jiaruiyang123/SD-OCT/README.md

# SD-OCT

This is for Thorlabs spectral domain OCT acquisition.

Jiarui Yang
05/22/19
