jiaruiyang123/SD-OCT/Vibratome/Rev 1.2/Vibratome Motor Assembly_RevC.SLDASM

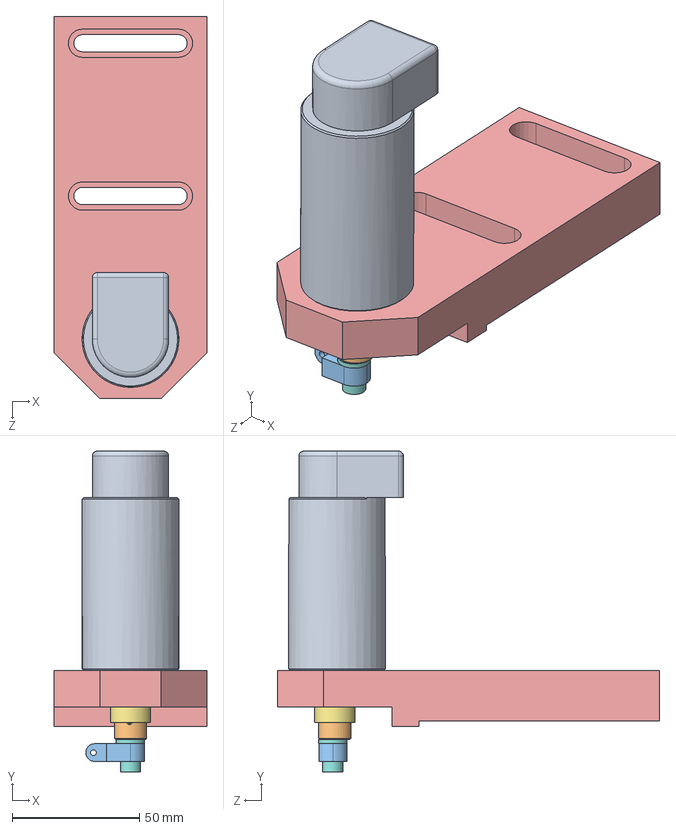
[picture p1: CAD file, 2019-05-22]
Vibratome/Rev 1.2/Vibratome Motor Assembly_RevC.SLDASM
60.0 x 126.0 x 150.0 mm
[Faulhaber] Series3863MotorwithEncoder
MotorEshaft
Motor Coupler Rev C
92695A105_HIGH HOLD CONE POINT SET SCREW x 4
Motor Holder Redesign
91290A113_BLACK-OXIDE CLASS 12.9 SOCKET HEAD CAP SCREW x 6
2706T280_ULTRA-LOW-FRICTION DRY-RUNNING SLEEVE BEARING
2706T120_ULTRA-LOW-FRICTION DRY-RUNNING SLEEVE BEARING
