jiaruiyang123/SD-OCT/Vibratome/Rev 1.2/BladeHolderBottom.STEP

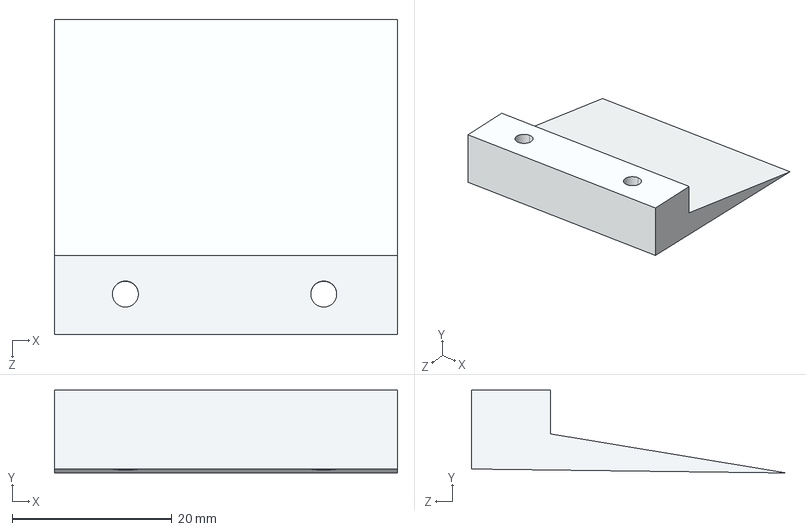
[picture p3: CAD file, 2019-05-22]
Vibratome/Rev 1.2/BladeHolderBottom.STEP
43.0 x 10.4 x 39.5 mm
