jiaruiyang123/SD-OCT/Vibratome/Rev 1.2/MotorEshaft.SLDPRT

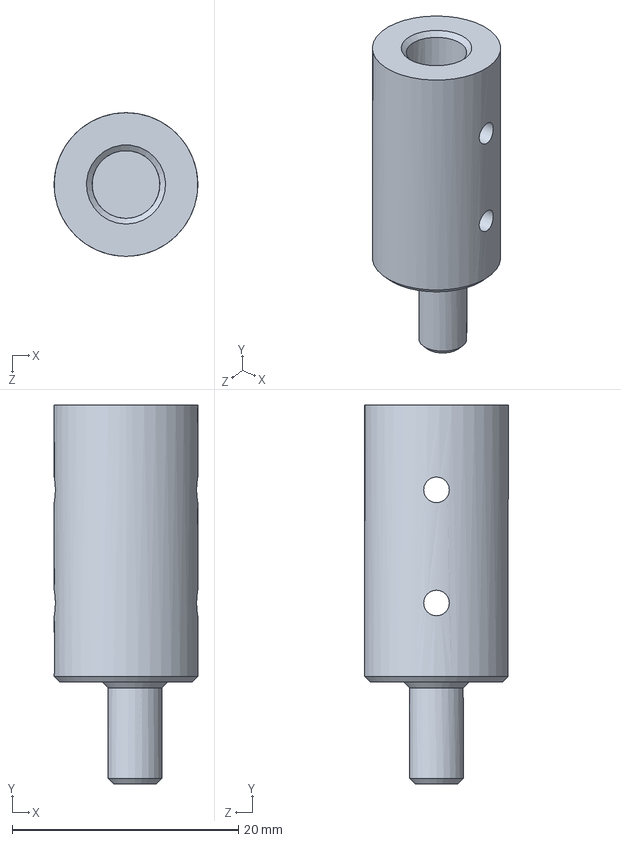
[picture p5: CAD file, 2019-05-22]
Vibratome/Rev 1.2/MotorEshaft.SLDPRT
12.7 x 33.5 x 12.7 mm
