jiaruiyang123/SD-OCT/Vibratome/Rev 1.2/BladeHolderTop.STEP

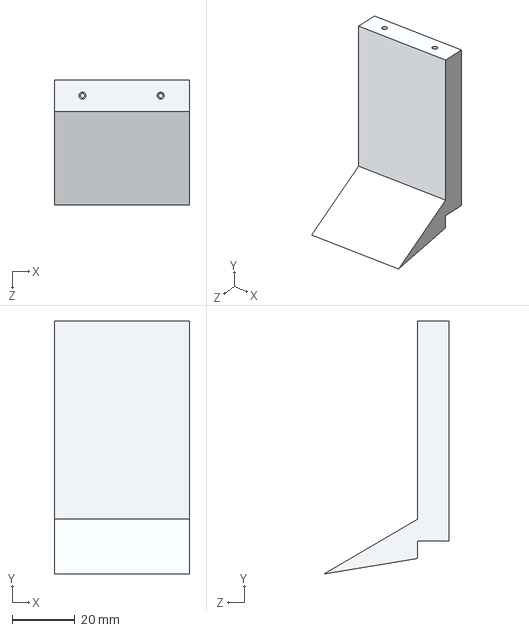
[picture p6: CAD file, 2019-05-22]
Vibratome/Rev 1.2/BladeHolderTop.STEP
43.0 x 80.4 x 39.8 mm
