jiaruiyang123/SD-OCT/Vibratome/Rev 1.2/Motor Coupler Rev C.SLDPRT

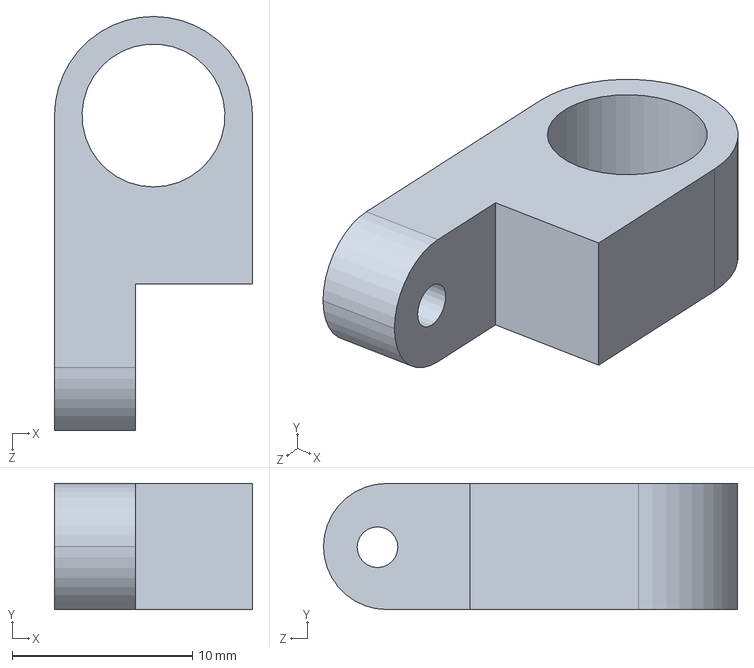
[picture p7: CAD file, 2019-05-22]
Vibratome/Rev 1.2/Motor Coupler Rev C.SLDPRT
11.0 x 7.00 x 23.0 mm
