jiaruiyang123/SD-OCT/Vibratome/Rev 1.2/[Faulhaber] Series3863MotorwithEncoder.SLDPRT

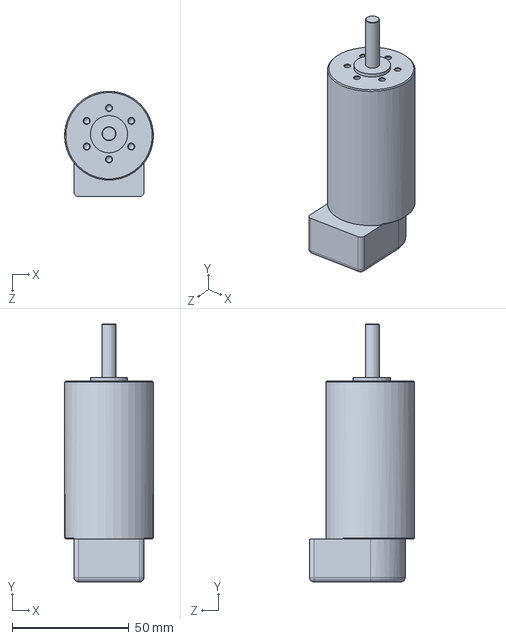
[picture p8: CAD file, 2019-05-22]
Vibratome/Rev 1.2/[Faulhaber] Series3863MotorwithEncoder.SLDPRT
38.0 x 110.4 x 45.1 mm
