jiaruiyang123/SD-OCT/Vibratome/Rev 1.2/Vibratome_Measured.SLDPRT

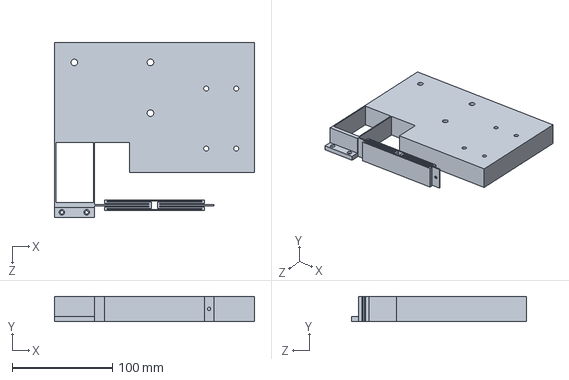
[picture p9: CAD file, 2019-05-22]
Vibratome/Rev 1.2/Vibratome_Measured.SLDPRT
200.0 x 25.0 x 174.8 mm
