jiaruiyang123/SD-OCT/Vibratome/Rev 1.2/93705A119_THREAD-LOCKING 18-8 SS SOCKET HEAD CAP SCREW.SLDPRT

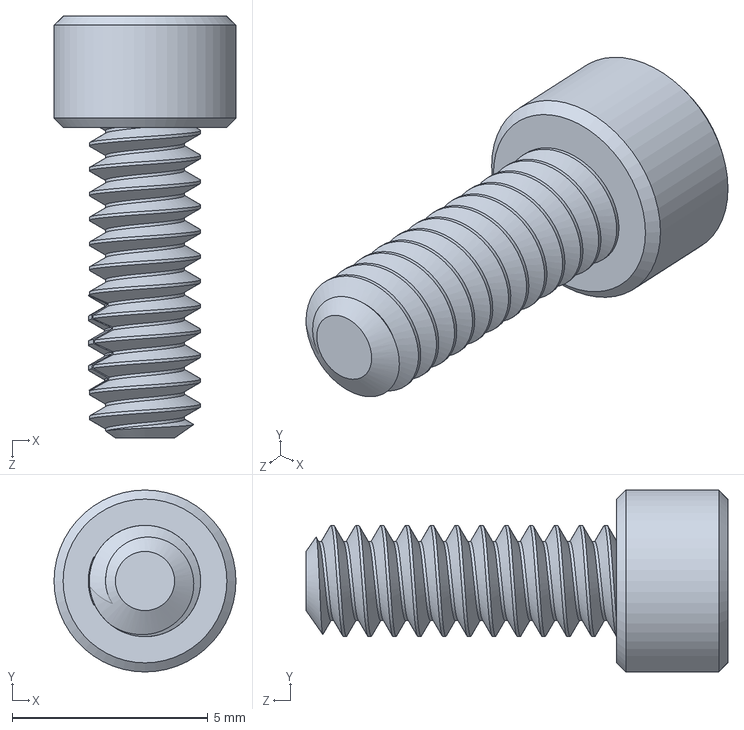
[picture p10: CAD file, 2019-05-22]
Vibratome/Rev 1.2/93705A119_THREAD-LOCKING 18-8 SS SOCKET HEAD CAP SCREW.SLDPRT
4.65 x 4.65 x 10.8 mm
