jiaruiyang123/SD-OCT/Vibratome/Rev 1.2/2706T280_ULTRA-LOW-FRICTION DRY-RUNNING SLEEVE BEARING.SLDPRT

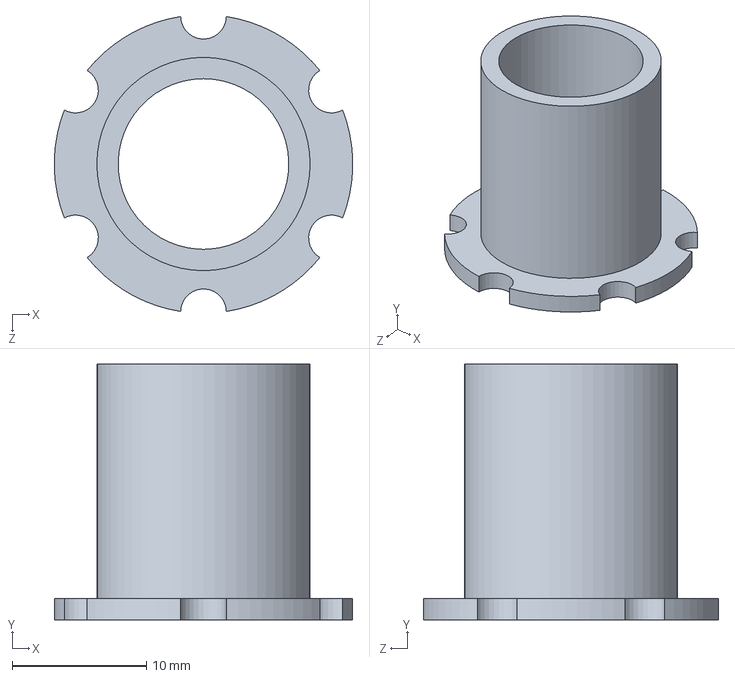
[picture p11: CAD file, 2019-05-22]
Vibratome/Rev 1.2/2706T280_ULTRA-LOW-FRICTION DRY-RUNNING SLEEVE BEARING.SLDPRT
22.2 x 19.1 x 22.0 mm
