jiaruiyang123/SD-OCT/Vibratome/Rev 1.2/93705A118_THREAD-LOCKING 18-8 SS SOCKET HEAD CAP SCREW.SLDPRT

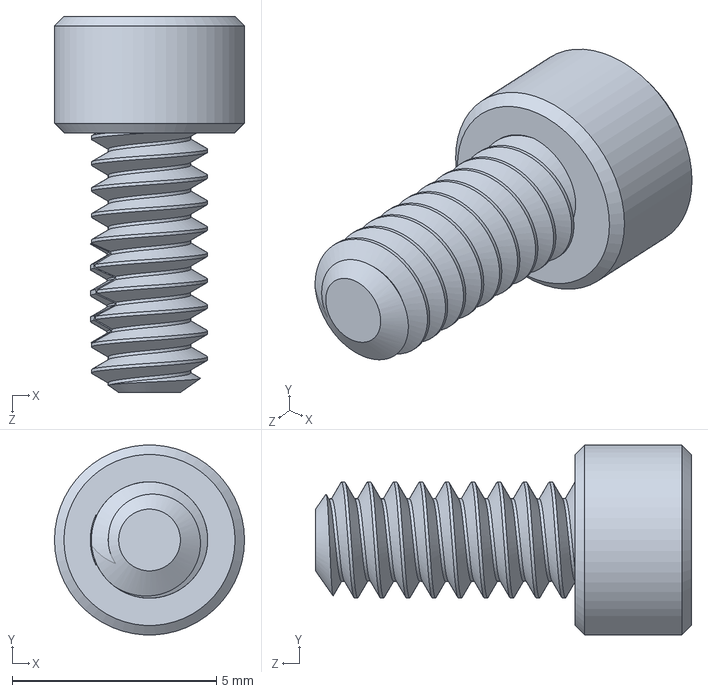
[picture p13: CAD file, 2019-05-22]
Vibratome/Rev 1.2/93705A118_THREAD-LOCKING 18-8 SS SOCKET HEAD CAP SCREW.SLDPRT
4.65 x 4.64 x 9.19 mm
