jiaruiyang123/SD-OCT/Vibratome/Rev 1.2/91251A540_BLACK-OXIDE ALLOY STEEL SOCKET HEAD CAP SCREW.SLDPRT

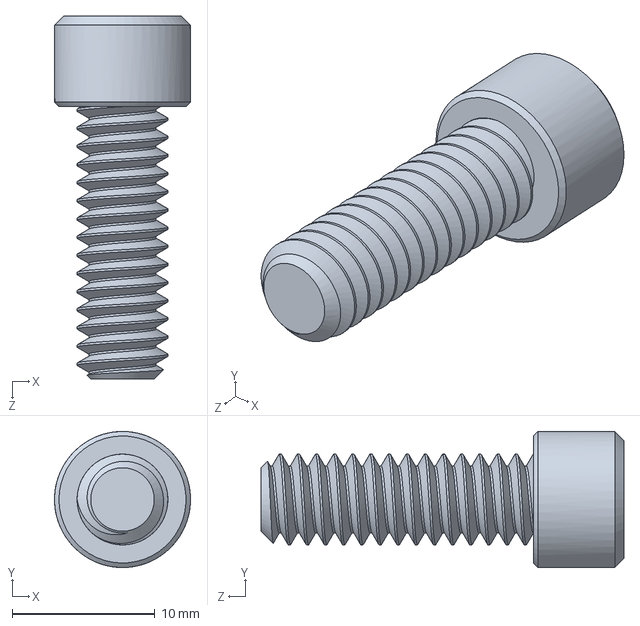
[picture p14: CAD file, 2019-05-22]
Vibratome/Rev 1.2/91251A540_BLACK-OXIDE ALLOY STEEL SOCKET HEAD CAP SCREW.SLDPRT
9.53 x 9.52 x 25.4 mm
