jiaruiyang123/SD-OCT/Vibratome/Rev 1.2/2706T120_ULTRA-LOW-FRICTION DRY-RUNNING SLEEVE BEARING.SLDPRT

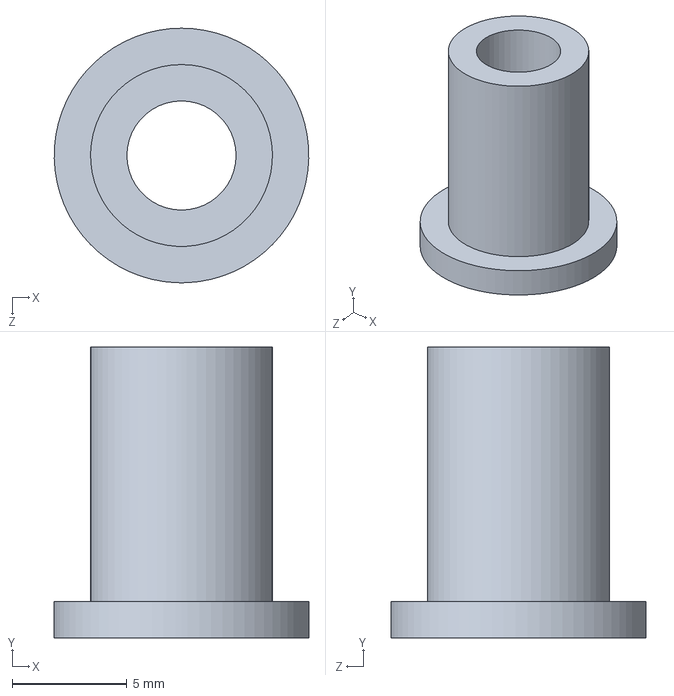
[picture p15: CAD file, 2019-05-22]
Vibratome/Rev 1.2/2706T120_ULTRA-LOW-FRICTION DRY-RUNNING SLEEVE BEARING.SLDPRT
11.1 x 12.7 x 11.1 mm
