jiaruiyang123/SD-OCT/Vibratome/Rev 1.2/91290A111_BLACK-OXIDE CLASS 12.9 SOCKET HEAD CAP SCREW.SLDPRT

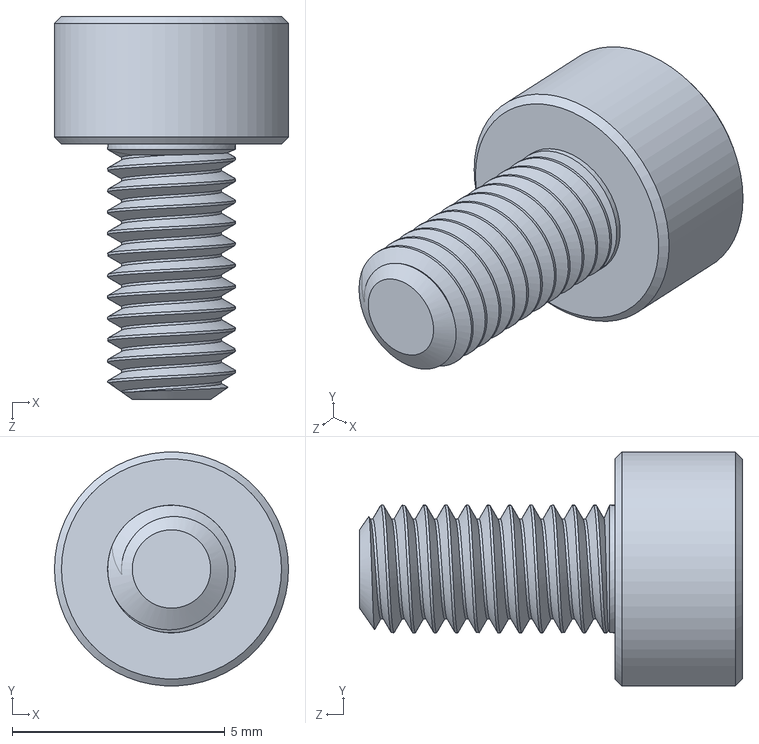
[picture p16: CAD file, 2019-05-22]
Vibratome/Rev 1.2/91290A111_BLACK-OXIDE CLASS 12.9 SOCKET HEAD CAP SCREW.SLDPRT
5.50 x 5.49 x 9.00 mm
