jiaruiyang123/SD-OCT/(list of files, cad)

Other CAD files:
Vibratome/Rev 1.2/Vibratome Assembly with Modified Motor Holder and EShaft_Rev1.2.STEP
Vibratome/Rev 1.2/Motor Holder Rev C.SLDPRT
Vibratome/Rev 1.2/2706T280_ULTRA-LOW-FRICTION DRY-RUNNING SLEEVE BEARING.SLDDRW
Vibratome/Rev 1.2/92695A105_HIGH HOLD CONE POINT SET SCREW.SLDPRT
Vibratome/Rev 1.2/BladeHolderBottom.SLDDRW
Vibratome/Rev 1.2/BladeHolderBottom.SLDPRT
Vibratome/Rev 1.2/BladeHolderTop.SLDDRW
Vibratome/Rev 1.2/BladeHolderTop.SLDPRT
Vibratome/Rev 1.2/ESHAFT.SLDDRW
Vibratome/Rev 1.2/Motor Coupler_RevC.SLDDRW
Vibratome/Rev 1.2/Motor Coupler_RevD.SLDDRW
Vibratome/Rev 1.2/Motor Holder Redesign.SLDDRW
Vibratome/Rev 1.2/Vibratome Assembly Diagram Revision D.SLDDRW
Vibratome/Rev 1.2/Vibratome Motor Holes Modification REV B.SLDDRW
