jiaruiyang123/SD-OCT/Vibratome/Rev 1.2/[VBT-ASM-100] Vibratome Assembly Diagram.pdf

B B

# MOTOR WITH ENCODER

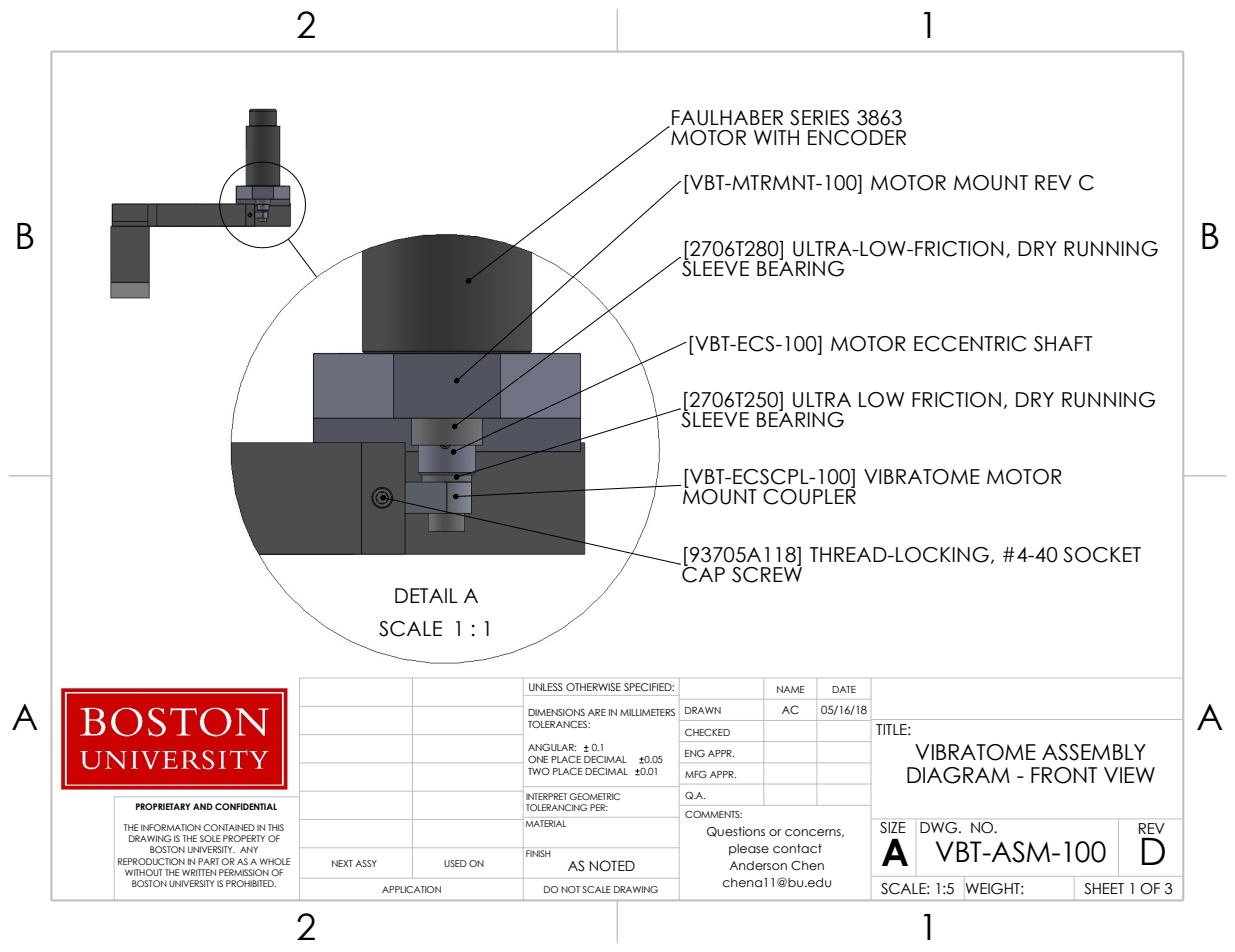
[picture p17: page 1]
DETAIL A SCALE 1 : 1; FAULHABER SERIES 3863

[VBT-MTRMNT-100] MOTOR MOUNT REV C

[2706T280] ULTRA-LOW-FRICTION, DRY RUNNING
SLEEVE BEARING

[VBT-ECS-100] MOTOR ECCENTRIC SHAFT

[2706T250] ULTRA LOW FRICTION, DRY RUNNING

[VBT-ECSCPL-100] VIBRATOME MOTOR
MOUNT COUPLER

[93705A118] THREAD-LOCKING, #4-40 SOCKET
CAP SCREW

UNLESS OTHERWISE SPECIFIED: | | NAME | DATE
DIMENSIONS ARE IN MILLIMETERS TOLERANCES: ANGULAR: 0.1 ONE PLACE DECIMAL 0.05 TWO PLACE DECIMAL 0.01 | DRAWN | AC | 05/16/18

CHECKED | | | TITLE: VIBRATOME ASSEMBLY DIAGRAM - FRONT VIEW

ENG APPR.
MFG APPR.

INTERPRET GEOMETRIC TOLERANCING PER: | Q.A.
MATERIAL | | SIZE A | DWG. NO. VBT-ASM-100 | REV D

PROPRIETARY AND CONFIDENTIAL

COMMENTS:
Questions or concerns,
please contact
Anderson Chen
chena11@bu.edu

THE INFORMATION CONTAINED IN THIS
DRAWING IS THE SOLE PROPERTY OF
BOSTON UNIVERSITY. ANY
REPRODUCTION IN PART OR AS A WHOLE
WITHOUT THE WRITTEN PERMISSION OF
BOSTON UNIVERSITY IS PROHIBITED.

NEXT ASSY | USED ON | FINISH AS NOTED

APPLICATION | DO NOT SCALE DRAWING | | SCALE: 1:5 | WEIGHT: | SHEET 1 OF 3

B B

# CHASSIS

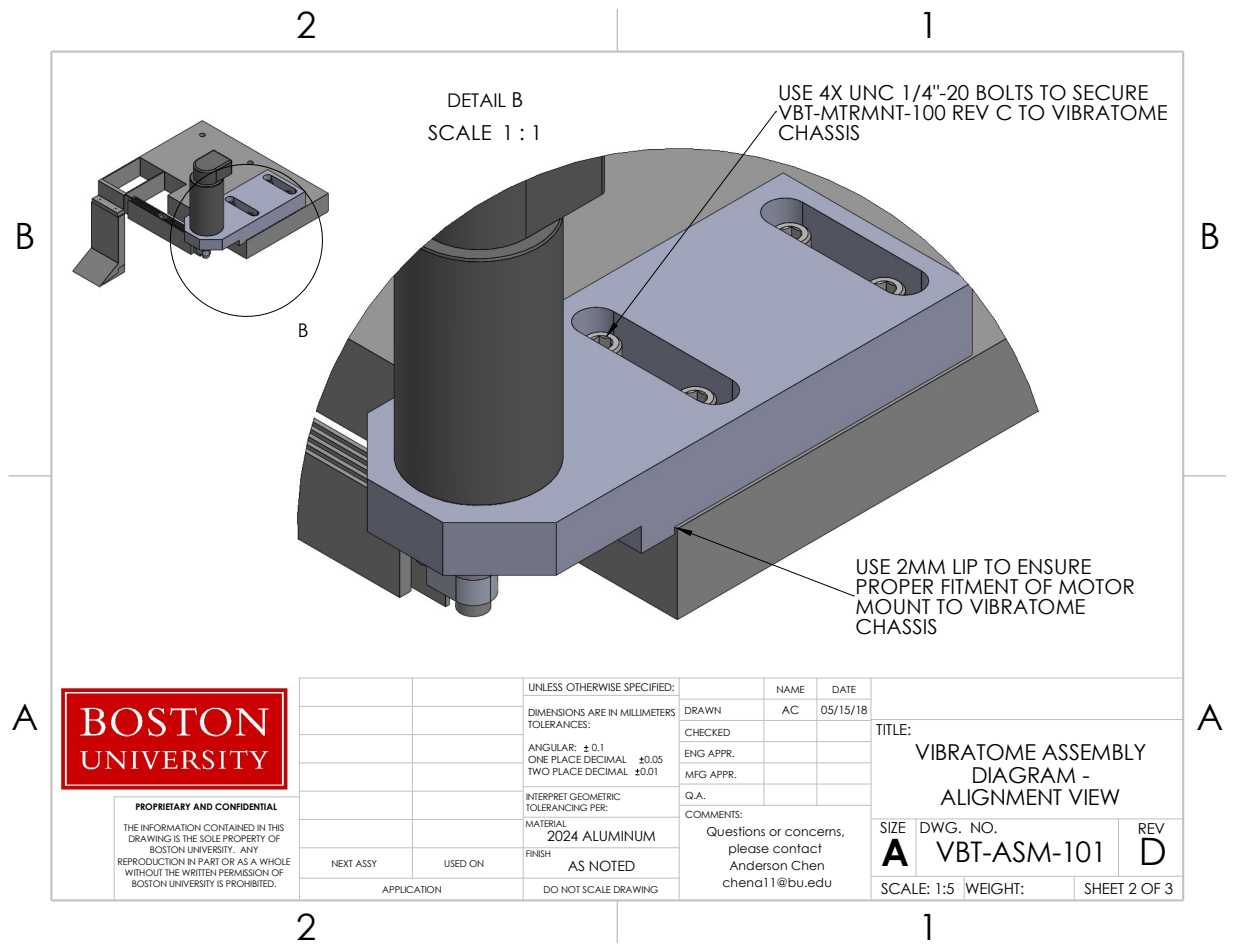
[picture p18: page 2]
SCALE; DETAIL B 1 : 1

USE 4X UNC 1/4"-20 BOLTS TO SECURE
VBT-MTRMNT-100 REV C TO VIBRATOME

USE 2MM LIP TO ENSURE
PROPER FITMENT OF MOTOR
MOUNT TO VIBRATOME
CHASSIS

UNLESS OTHERWISE SPECIFIED: | | NAME | DATE
DIMENSIONS ARE IN MILLIMETERS TOLERANCES: ANGULAR: 0.1 ONE PLACE DECIMAL 0.05 TWO PLACE DECIMAL 0.01 | DRAWN | AC | 05/15/18

CHECKED | | | TITLE: VIBRATOME ASSEMBLY DIAGRAM -ALIGNMENT VIEW

ENG APPR.
MFG APPR.

INTERPRET GEOMETRIC TOLERANCING PER: | Q.A.
MATERIAL 2024 ALUMINUM | | SIZE A | DWG. NO. VBT-ASM-101 | REV D

PROPRIETARY AND CONFIDENTIAL

COMMENTS:
Questions or concerns,
please contact
Anderson Chen

THE INFORMATION CONTAINED IN THIS
DRAWING IS THE SOLE PROPERTY OF
BOSTON UNIVERSITY. ANY
REPRODUCTION IN PART OR AS A WHOLE
WITHOUT THE WRITTEN PERMISSION OF

NEXT ASSY | USED ON | FINISH AS NOTED

DO NOT SCALE DRAWING | | | | SHEET 2 OF 3

C

B B

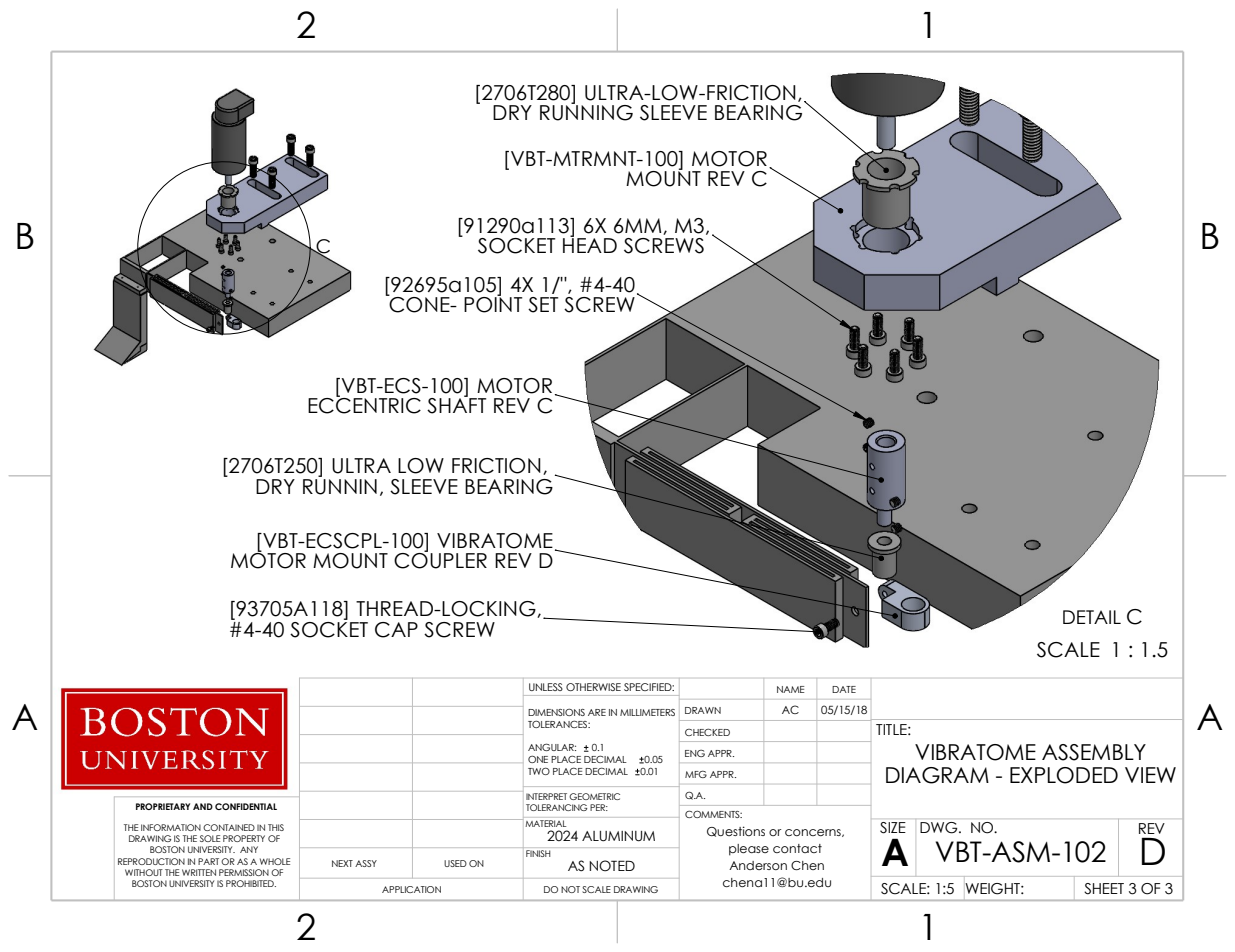
[picture p19: page 3]
SCALE; DETAIL; MOUNT REV C

[2706T280] ULTRA-LOW-FRICTION,
DRY RUNNING SLEEVE BEARING
[VBT-MTRMNT-100] MOTOR

SOCKET HEAD SCREWS

CONE- POINT SET SCREW

[VBT-ECS-100] MOTOR
ECCENTRIC SHAFT REV C

[2706T250] ULTRA LOW FRICTION,
DRY RUNNIN, SLEEVE BEARING

[VBT-ECSCPL-100] VIBRATOME
MOTOR MOUNT COUPLER REV D

[93705A118] THREAD-LOCKING,
#4-40 SOCKET CAP SCREW

UNLESS OTHERWISE SPECIFIED: | | NAME | DATE
DIMENSIONS ARE IN MILLIMETERS TOLERANCES: ANGULAR: 0.1 ONE PLACE DECIMAL 0.05 TWO PLACE DECIMAL 0.01 | DRAWN | AC | 05/15/18

CHECKED | | | TITLE: VIBRATOME ASSEMBLY DIAGRAM - EXPLODED VIEW

ENG APPR.
MFG APPR.

INTERPRET GEOMETRIC TOLERANCING PER: | Q.A.
MATERIAL 2024 ALUMINUM | | SIZE A | DWG. NO. VBT-ASM-102 | REV D

PROPRIETARY AND CONFIDENTIAL

COMMENTS:
Questions or concerns,
please contact
Anderson Chen

THE INFORMATION CONTAINED IN THIS
DRAWING IS THE SOLE PROPERTY OF
BOSTON UNIVERSITY. ANY
REPRODUCTION IN PART OR AS A WHOLE
WITHOUT THE WRITTEN PERMISSION OF

NEXT ASSY | USED ON | FINISH AS NOTED

DO NOT SCALE DRAWING | | | | SHEET 3 OF 3
