jiaruiyang123/SD-OCT/Vibratome/Rev 1.2/[VBT-BLDHLD-100] VIBRATOME BLADE HOLDER - TOP.pdf

# NOTES: 1.) FOR #4-40 TAPS, USING EXISTING HOLES

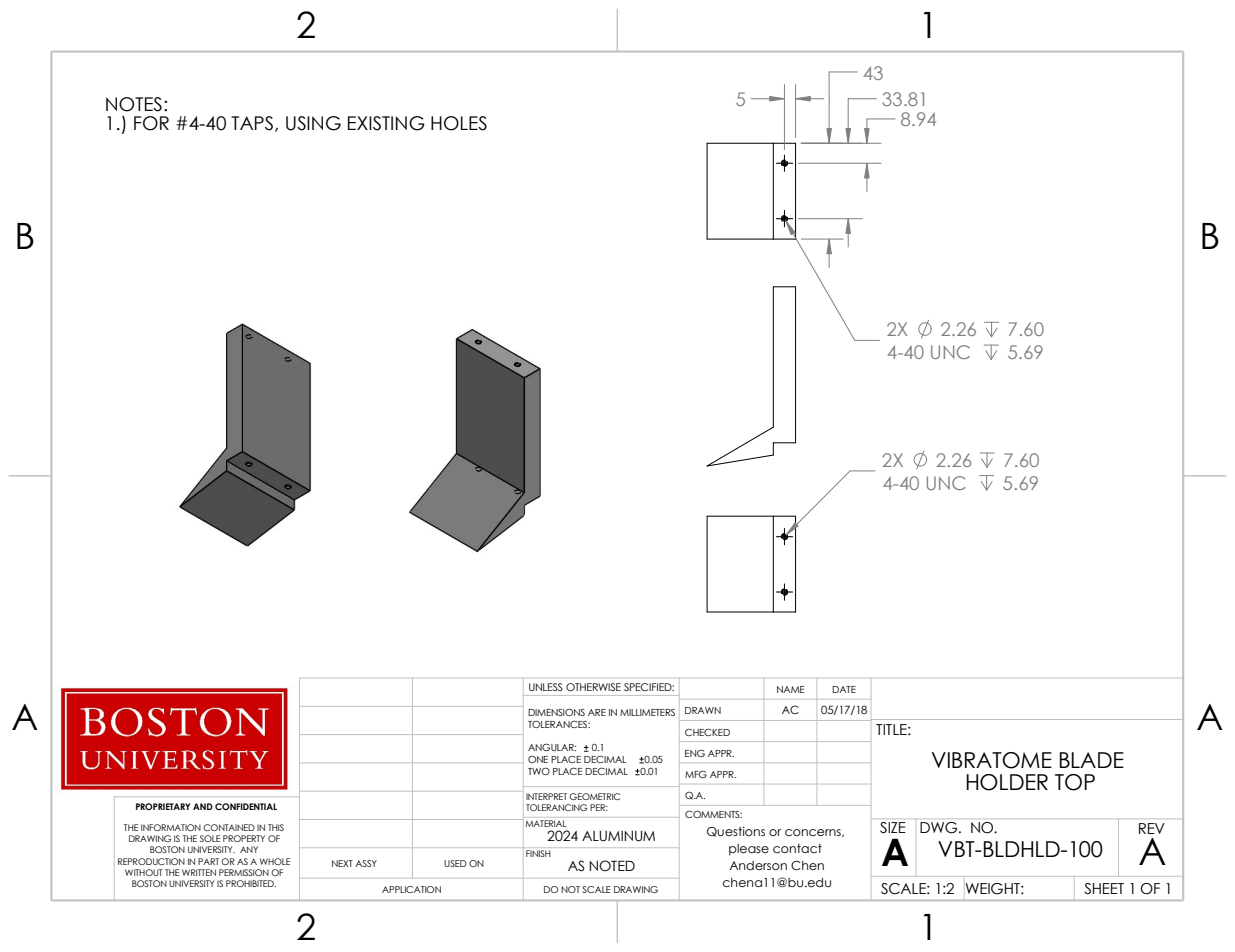
[picture p20: page 1]
REPRODUCTION IN PART OR AS A WHOLE; VBT-BLDHLD-100; DWG. NO.; REV; SIZE; COMMENTS:; 2024 ALUMINUM; MATERIAL; DRAWING IS THE SOLE PROPERTY OF; Questions or concerns,; please contact Anderson Chen chena11@bu.edu; 4-40 UNC

UNLESS OTHERWISE SPECIFIED: | | NAME | DATE
DIMENSIONS ARE IN MILLIMETERS TOLERANCES: ANGULAR: 0.1 ONE PLACE DECIMAL 0.05 TWO PLACE DECIMAL 0.01 | DRAWN | AC | 05/17/18

CHECKED | | | TITLE: VIBRATOME BLADE HOLDER TOP

ENG APPR.
MFG APPR.

INTERPRET GEOMETRIC TOLERANCING PER: | Q.A.

PROPRIETARY AND CONFIDENTIAL

THE INFORMATION CONTAINED IN THIS
BOSTON UNIVERSITY. ANY

NEXT ASSY | USED ON | FINISH AS NOTED

WITHOUT THE WRITTEN PERMISSION OF
BOSTON UNIVERSITY IS PROHIBITED.

APPLICATION | DO NOT SCALE DRAWING | | SCALE: 1:2 | WEIGHT: | SHEET 1 OF 1
