jiaruiyang123/SD-OCT/Vibratome/Rev 1.2/[VBT-BLDHLD-B-100] VIBRATOME BLADE HOLDER - BOTTOM.pdf

# NOTES: 1.) CLEARANCE, #4-40, USE EXISTING HOLES

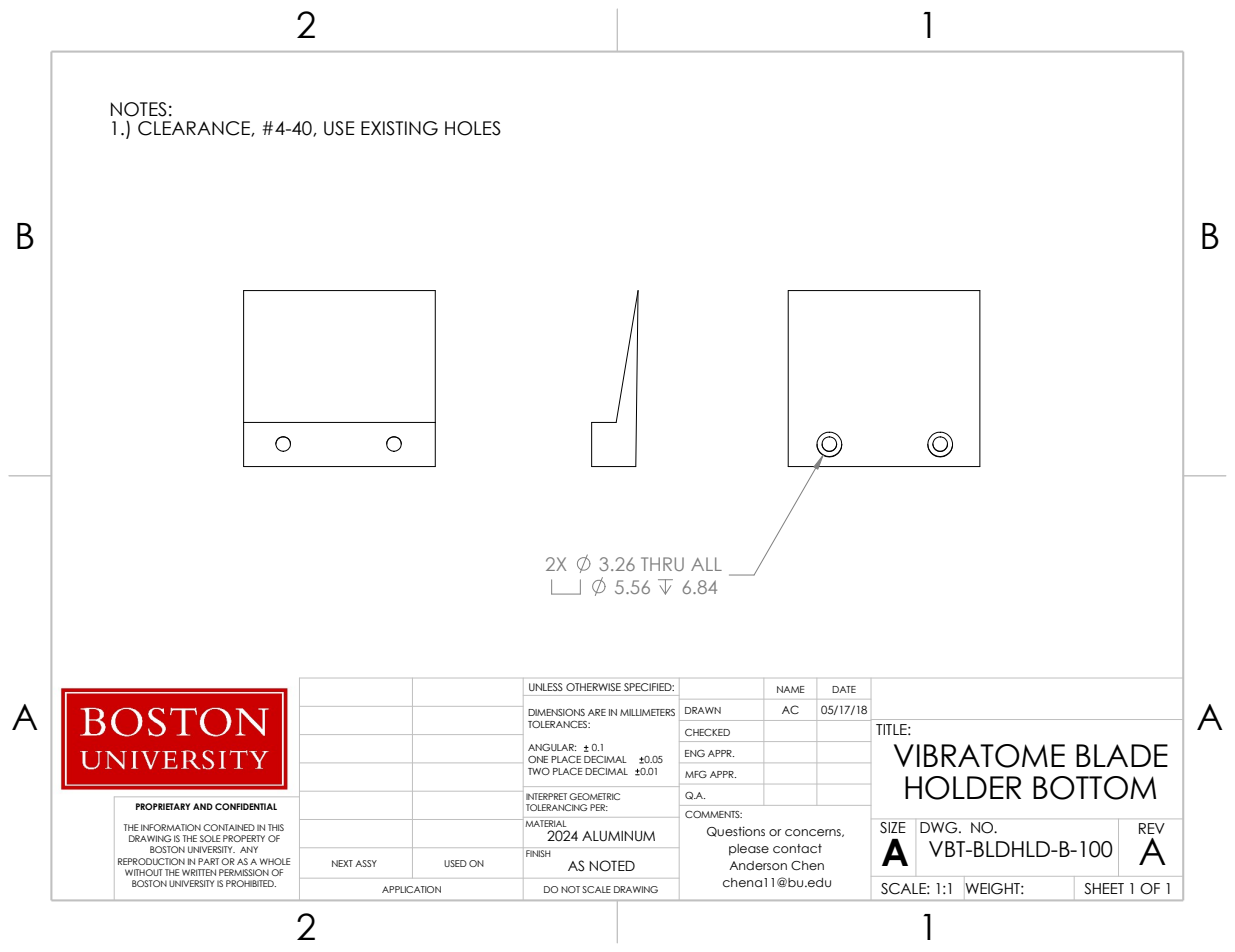
[picture p21: page 1]
2024 ALUMINUM; DWG. NO.; REV; BOSTON UNIVERSITY. ANY; SIZE; COMMENTS:; MATERIAL; VBT-BLDHLD-B-100; DRAWING IS THE SOLE PROPERTY OF; Questions or concerns,; please contact Anderson Chen chena11@bu.edu; 3.26 THRU ALL

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

CHECKED | | | TITLE: VIBRATOME BLADE HOLDER BOTTOM

ENG APPR.
MFG APPR.

INTERPRET GEOMETRIC TOLERANCING PER: | Q.A.

PROPRIETARY AND CONFIDENTIAL

THE INFORMATION CONTAINED IN THIS

REPRODUCTION IN PART OR AS A WHOLE
WITHOUT THE WRITTEN PERMISSION OF
BOSTON UNIVERSITY IS PROHIBITED.

NEXT ASSY | USED ON | FINISH AS NOTED

APPLICATION | DO NOT SCALE DRAWING | | SCALE: 1:1 | WEIGHT: | SHEET 1 OF 1
