jiaruiyang123/SD-OCT/Vibratome/Rev 1.2/[VBT-ECS-100] Eccentric Shaft - REV C.pdf

# 4-40 UNC THRU ALL

# 2.26 THRU ALL

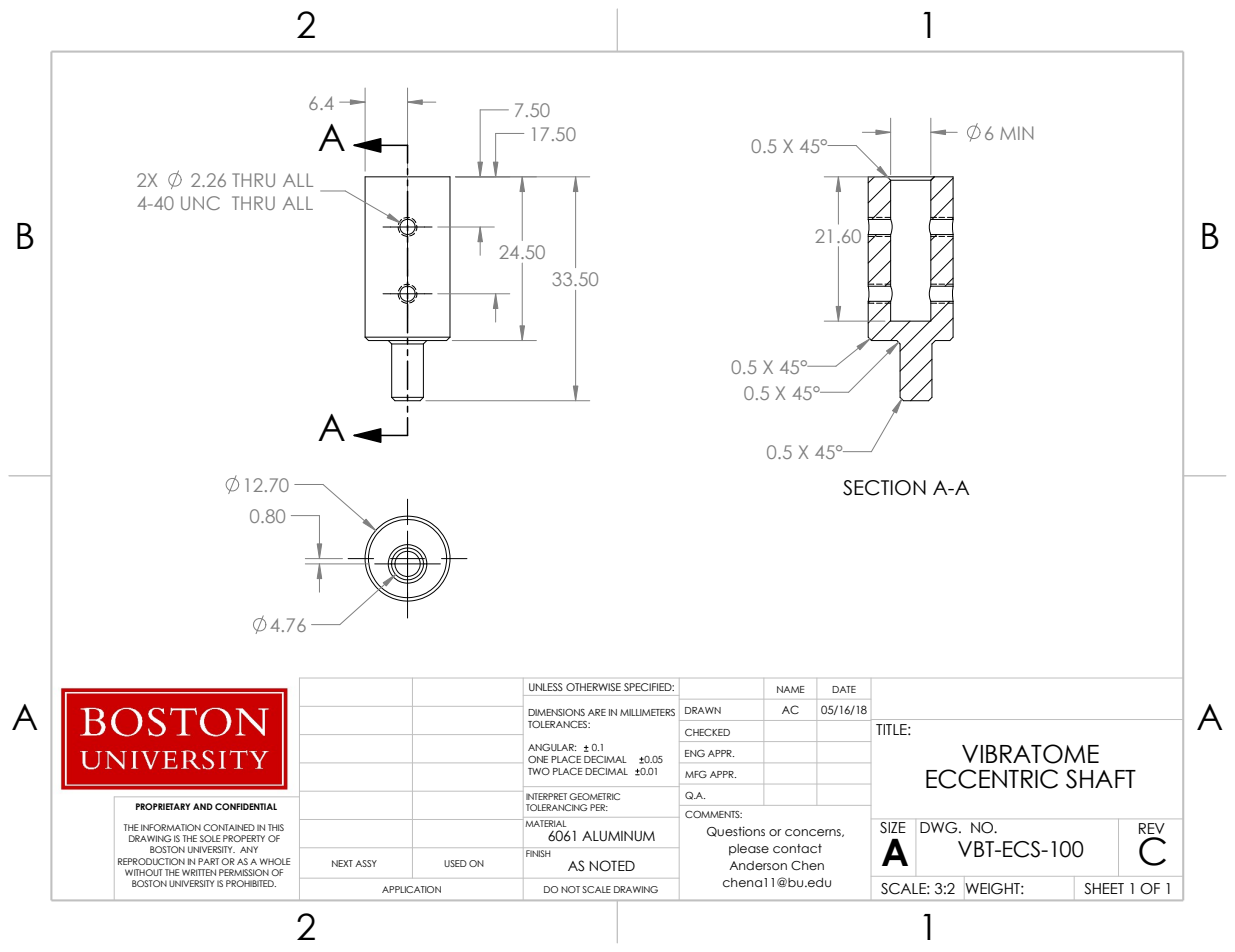
[picture p22: page 1]
SECTION A-A; 6 MIN; COMMENTS:; chena11@bu.edu; DRAWING IS THE SOLE PROPERTY OF; Questions or concerns,; please contact Anderson Chen

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

CHECKED | | | TITLE: VIBRATOME ECCENTRIC SHAFT

ENG APPR.
MFG APPR.

INTERPRET GEOMETRIC TOLERANCING PER: | Q.A.
MATERIAL 6061 ALUMINUM | | SIZE A | DWG. NO. VBT-ECS-100 | REV C

PROPRIETARY AND CONFIDENTIAL

THE INFORMATION CONTAINED IN THIS
BOSTON UNIVERSITY. ANY
REPRODUCTION IN PART OR AS A WHOLE
WITHOUT THE WRITTEN PERMISSION OF
BOSTON UNIVERSITY IS PROHIBITED.

NEXT ASSY | USED ON | FINISH AS NOTED

APPLICATION | DO NOT SCALE DRAWING | | SCALE: 3:2 | WEIGHT: | SHEET 1 OF 1
