jiaruiyang123/SD-OCT/Vibratome/Rev 1.2/[VBT-ECSCPL-100] Vibratome Motor Mount Coupler REV D.pdf

23 7
B

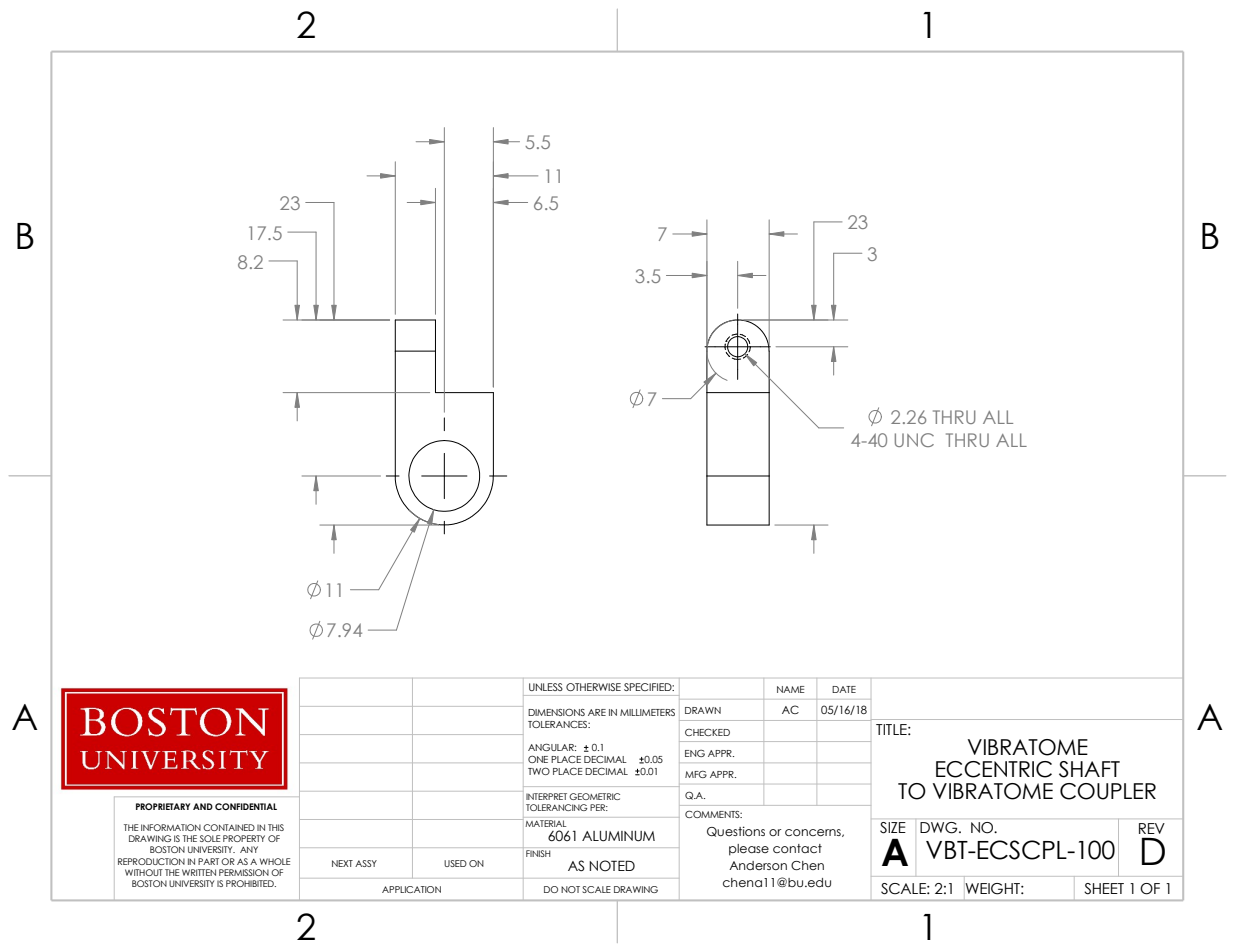
[picture p23: page 1]
BOSTON UNIVERSITY. ANY; REV; SIZE; COMMENTS:; VBT-ECSCPL-100; DRAWING IS THE SOLE PROPERTY OF; Questions or concerns,; please contact Anderson Chen chena11@bu.edu

2.26 THRU ALL
4-40 UNC THRU ALL

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

CHECKED | | | TITLE: VIBRATOME ECCENTRIC SHAFT TO VIBRATOME COUPLER

ENG APPR.
MFG APPR.

INTERPRET GEOMETRIC TOLERANCING PER: | Q.A.

PROPRIETARY AND CONFIDENTIAL

MATERIAL
DWG. NO. 6061 ALUMINUM

THE INFORMATION CONTAINED IN THIS

REPRODUCTION IN PART OR AS A WHOLE
WITHOUT THE WRITTEN PERMISSION OF
BOSTON UNIVERSITY IS PROHIBITED.

NEXT ASSY | USED ON | FINISH AS NOTED
APPLICATION | DO NOT SCALE DRAWING | | SCALE: 2:1 | WEIGHT: | SHEET 1 OF 1
