jiaruiyang123/SD-OCT/Vibratome/Rev 1.2/[VBT-ECSSLV-100] Vibratome Eccentric Shaft Sleeve Modification.pdf

B

1

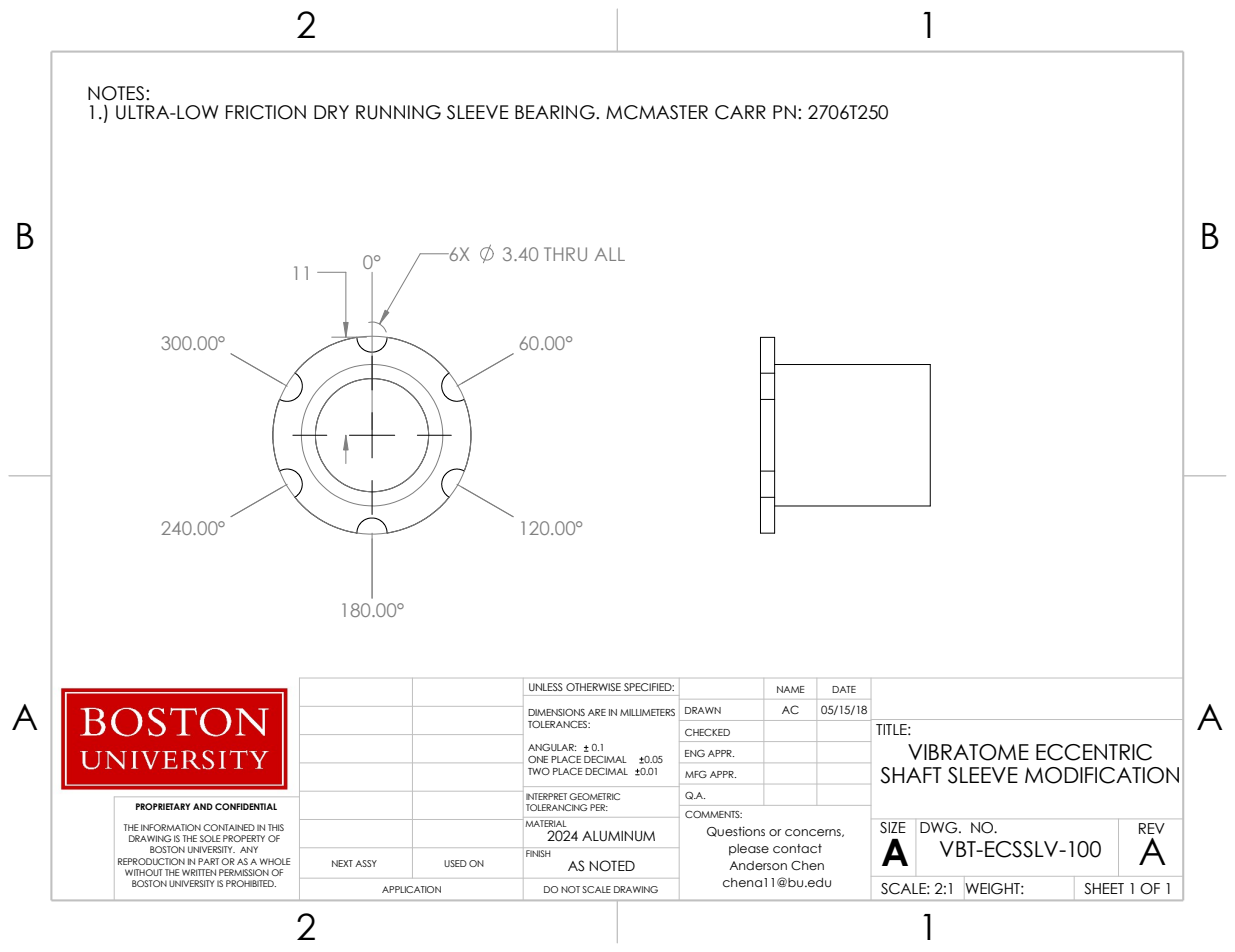
[picture p24: page 1]
COMMENTS:; DRAWING IS THE SOLE PROPERTY OF; Questions or concerns,; please contact Anderson Chen chena11@bu.edu; 3.40 THRU ALL

NOTES:
1.) ULTRA-LOW FRICTION DRY RUNNING SLEEVE BEARING. MCMASTER CARR PN: 2706T250

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

CHECKED | | | TITLE: VIBRATOME ECCENTRIC SHAFT SLEEVE MODIFICATION

ENG APPR.
MFG APPR.

INTERPRET GEOMETRIC TOLERANCING PER: | Q.A.
MATERIAL | | SIZE A | VBT-ECSSLV-100 | REV A

PROPRIETARY AND CONFIDENTIAL

DWG. NO. 2024 ALUMINUM

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
