jiaruiyang123/SD-OCT/Vibratome/Rev 1.2/[VBT-MTRMNT-100] Vibratome Motor Mount-RevC.pdf

60
45

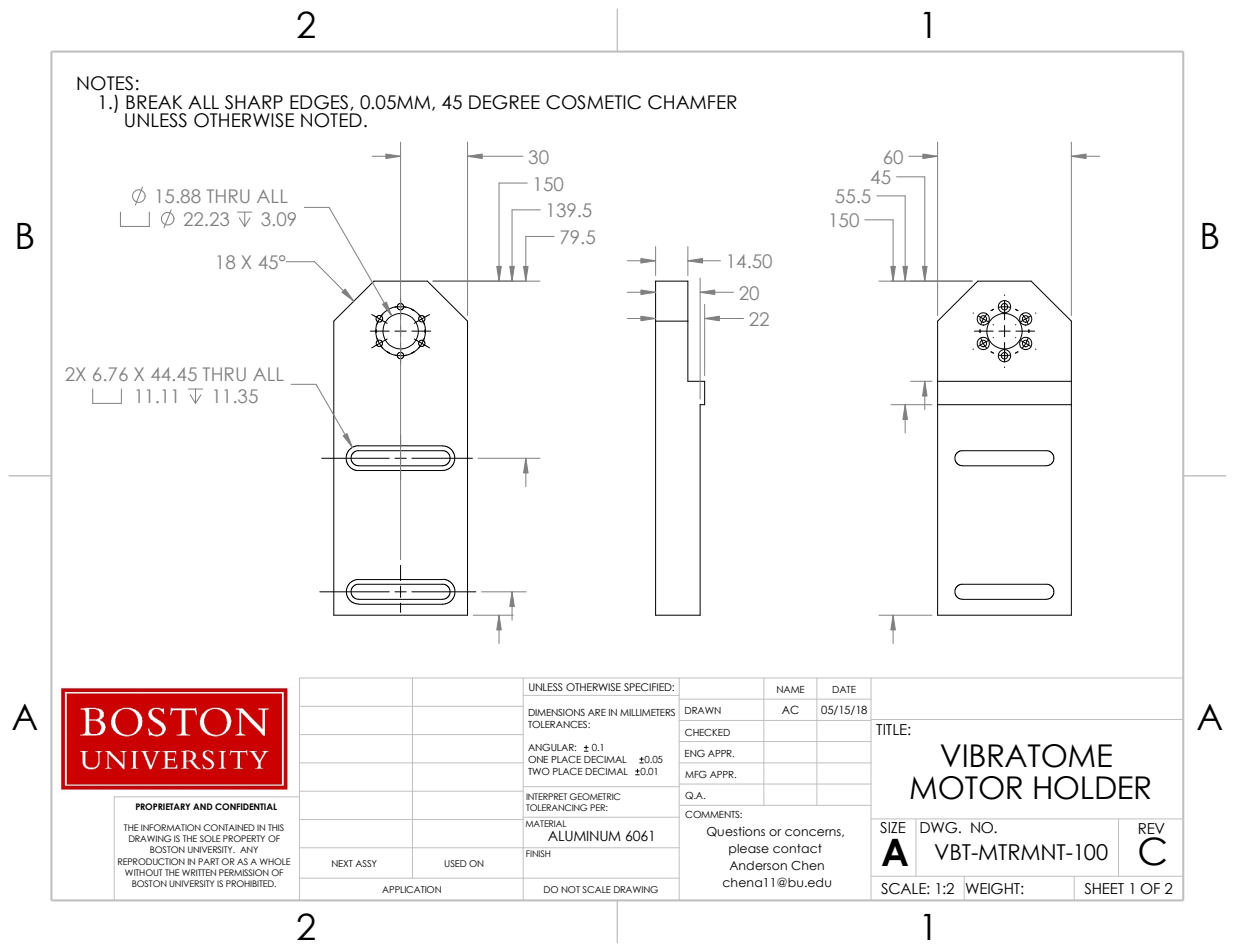
[picture p25: page 1]
2X 6.76 X 44.45 THRU ALL 11.11 11.35; 150 15.88 THRU ALL

NOTES:
1.) BREAK ALL SHARP EDGES, 0.05MM, 45 DEGREE COSMETIC CHAMFER
UNLESS OTHERWISE NOTED.

UNLESS OTHERWISE SPECIFIED: | | NAME | DATE
DIMENSIONS ARE IN MILLIMETERS TOLERANCES: ANGULAR: 0.1 ONE PLACE DECIMAL 0.05 TWO PLACE DECIMAL 0.01 | DRAWN | AC | 05/15/18

CHECKED | | | TITLE: VIBRATOME MOTOR HOLDER

ENG APPR.
MFG APPR.

INTERPRET GEOMETRIC TOLERANCING PER: | Q.A.
MATERIAL ALUMINUM 6061 | | SIZE A | DWG. NO. VBT-MTRMNT-100 | REV C

PROPRIETARY AND CONFIDENTIAL

COMMENTS:
Questions or concerns,
please contact
Anderson Chen
chena11@bu.edu

THE INFORMATION CONTAINED IN THIS
DRAWING IS THE SOLE PROPERTY OF
BOSTON UNIVERSITY. ANY
REPRODUCTION IN PART OR AS A WHOLE
WITHOUT THE WRITTEN PERMISSION OF
BOSTON UNIVERSITY IS PROHIBITED.

NEXT ASSY | USED ON | FINISH

APPLICATION | DO NOT SCALE DRAWING | | SCALE: 1:2 | WEIGHT: | SHEET 1 OF 2

B B

2

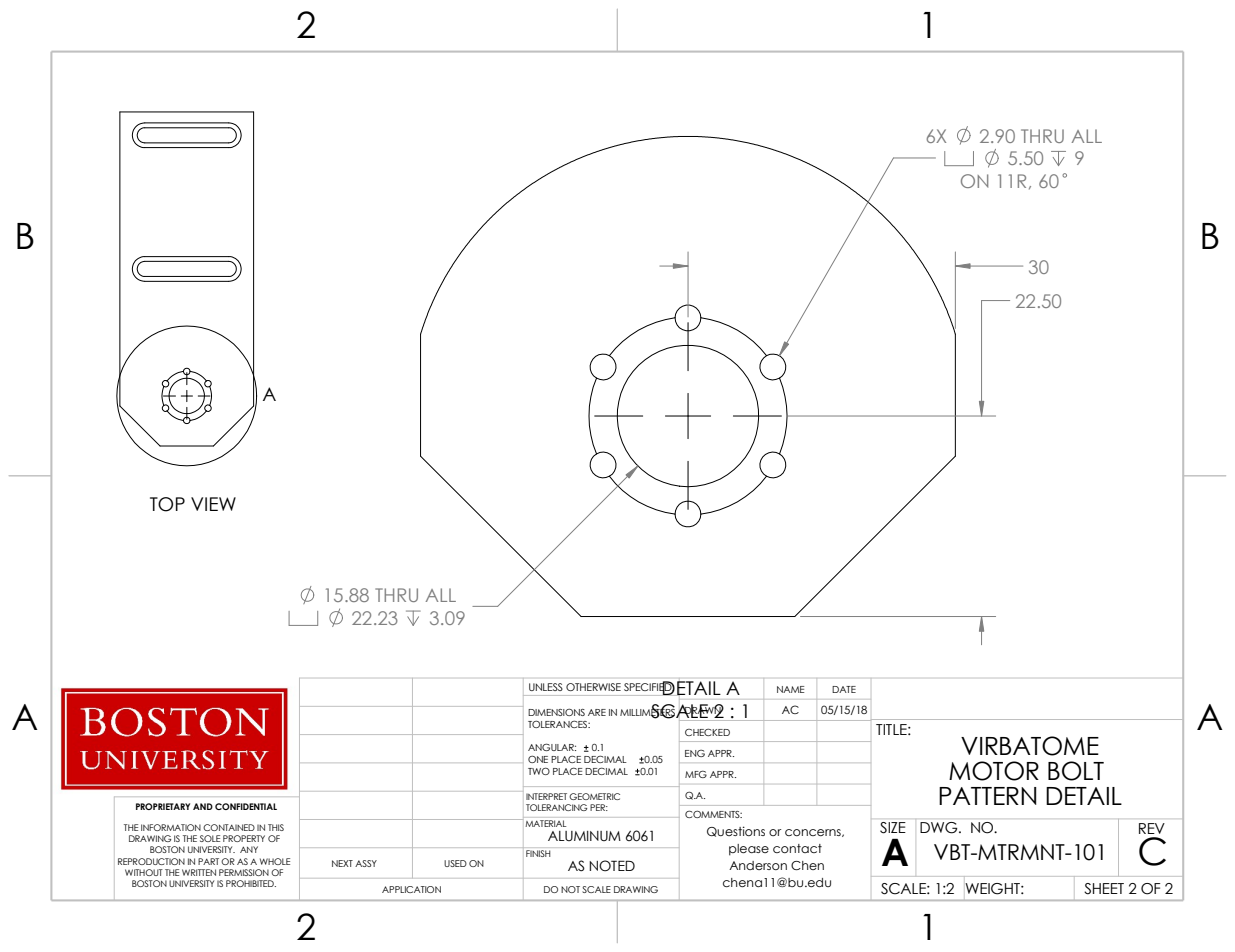
[picture p26: page 2]
TOP VIEW; 2.90 THRU ALL; 15.88 THRU ALL 22.23 3.09

UNLESS OTHERWISE SPECIFIED: DETAIL A | | NAME | DATE
SCALE 2 : 1 DIMENSIONS ARE IN MILLIMETERS TOLERANCES: ANGULAR: 0.1 ONE PLACE DECIMAL 0.05 TWO PLACE DECIMAL 0.01 | DRAWN | AC | 05/15/18

CHECKED | | | TITLE: VIRBATOME MOTOR BOLT PATTERN DETAIL

ENG APPR.
MFG APPR.

INTERPRET GEOMETRIC TOLERANCING PER: | Q.A.
MATERIAL ALUMINUM 6061 | | SIZE A | DWG. NO. VBT-MTRMNT-101 | REV C

PROPRIETARY AND CONFIDENTIAL

COMMENTS:
Questions or concerns,
please contact
Anderson Chen
chena11@bu.edu

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

NEXT ASSY | USED ON | FINISH AS NOTED

APPLICATION | DO NOT SCALE DRAWING | | SCALE: 1:2 | WEIGHT: | SHEET 2 OF 2
