jiaruiyang123/SD-OCT/Vibratome/Rev 1.2/[VBT-MTRMOD-100] Vibratome Motor Mount Modification REV C.pdf

2

B B

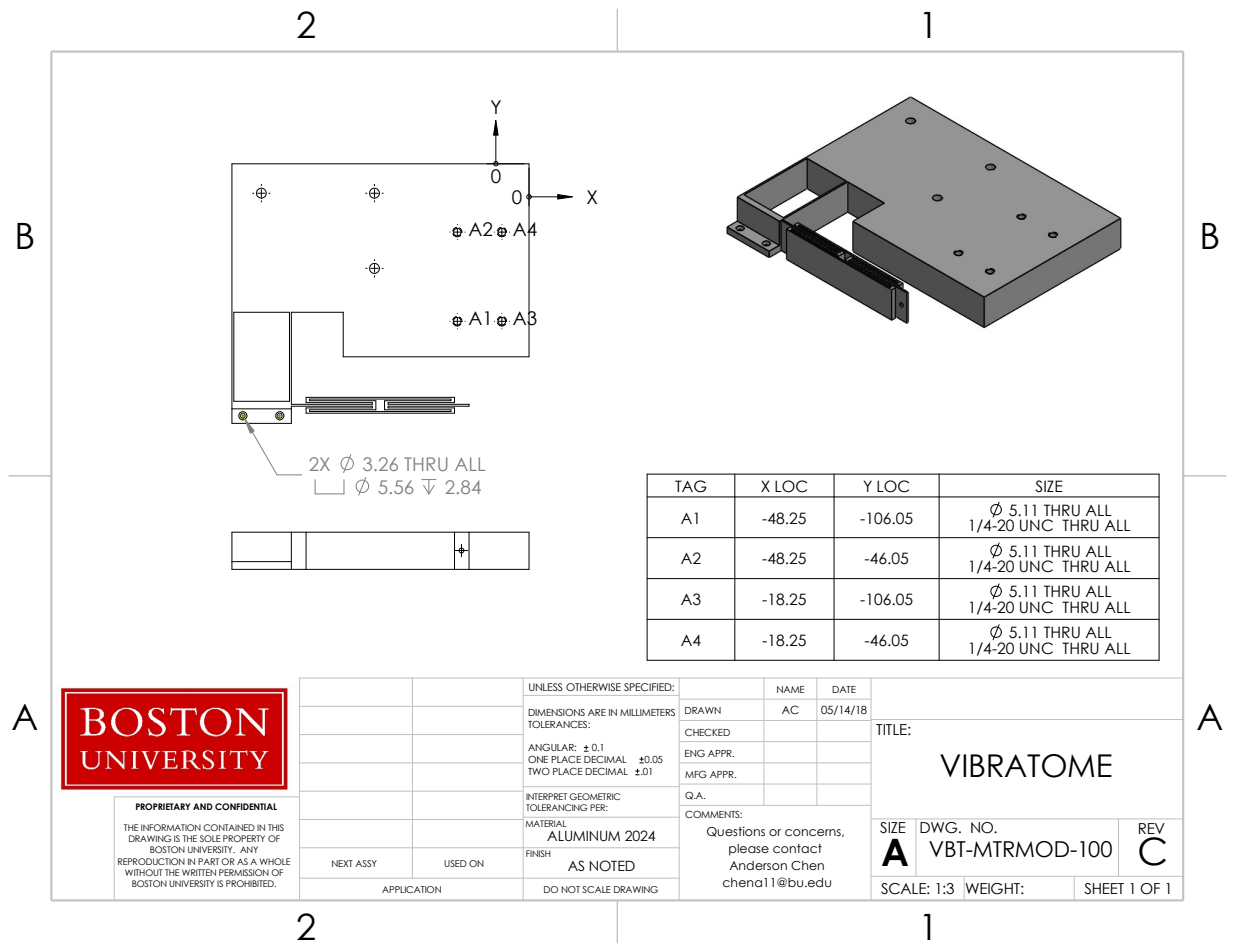
[picture p27: page 1]
COMMENTS:; chena11@bu.edu; DRAWING IS THE SOLE PROPERTY OF; Questions or concerns,; please contact Anderson Chen; 3.26 THRU ALL

TAG | X LOC | Y LOC | SIZE
A1 | -48.25 | -106.05 | 5.11 THRU ALL 1/4-20 UNC THRU ALL

A2 | -48.25 | -46.05 | 5.11 THRU ALL 1/4-20 UNC THRU ALL

A3 | -18.25 | -106.05 | 5.11 THRU ALL 1/4-20 UNC THRU ALL

A4 | -18.25 | -46.05 | 5.11 THRU ALL 1/4-20 UNC THRU ALL

UNLESS OTHERWISE SPECIFIED: | | NAME | DATE
DIMENSIONS ARE IN MILLIMETERS TOLERANCES: ANGULAR: 0.1 ONE PLACE DECIMAL 0.05 TWO PLACE DECIMAL .01 | DRAWN | AC | 05/14/18

CHECKED | | | TITLE: VIBRATOME

ENG APPR.
MFG APPR.

INTERPRET GEOMETRIC TOLERANCING PER: | Q.A.
MATERIAL ALUMINUM 2024 | | SIZE A | DWG. NO. VBT-MTRMOD-100 | REV C

PROPRIETARY AND CONFIDENTIAL

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

NEXT ASSY | USED ON | FINISH AS NOTED
APPLICATION | DO NOT SCALE DRAWING | | SCALE: 1:3 | WEIGHT: | SHEET 1 OF 1
