jiaruiyang123/SD-OCT/(list of files, drawings)

Other design files:
Documents/Notes/Galvo Timing Chart.opj
