jiaruiyang123/SD-OCT/Software/Thorlabs.MotionControl.Benchtop.BrushlessMotor.h

// summary:	Declares the functions class
// The following ifdef block is the standard way of creating macros which make exporting 
// from a DLL simpler. All files within this DLL are compiled with the BRUSHLESSMOTOR_EXPORTS
// symbol defined on the command line. This symbol should not be defined on any project
// that uses this DLL. This way any other project whose source files include this file see 
// BRUSHLESSMOTOR_API functions as being imported from a DLL, whereas this DLL sees symbols
// defined with this macro as being exported.

#pragma once

#ifdef BRUSHLESSMOTORDLL_EXPORTS
/// <summary> Gets the brushlessmotor API. </summary>
#define BRUSHLESSMOTOR_API __declspec(dllexport)
#else
#define BRUSHLESSMOTOR_API __declspec(dllimport)
#endif

#include <OaIdl.h>

extern "C"
{
/** @defgroup Common Common Enums, structs and Functions
 *  This section details the Structures and Functions common to all devices
 *  @{
 */

	/// <summary> Values that represent FT_Status. </summary>
	typedef enum FT_Status : short
	{
		FT_OK = 0x00, ///<OK - no error.
		FT_InvalidHandle = 0x01, ///<Invalid handle.
		FT_DeviceNotFound = 0x02, ///<Device not found.
		FT_DeviceNotOpened = 0x03, ///<Device not opened.
		FT_IOError = 0x04, ///<I/O error.
		FT_InsufficientResources = 0x05, ///<Insufficient resources.
		FT_InvalidParameter = 0x06, ///<Invalid parameter.
		FT_DeviceNotPresent = 0x07, ///<Device not present.
		FT_IncorrectDevice = 0x08 ///<Incorrect device.
	 } FT_Status;

	/// <summary> Values that represent different Motor Types. </summary>
	typedef enum MOT_MotorTypes
	{
		MOT_NotMotor = 0, ///<Not a motor
		MOT_DCMotor = 1, ///< Motor is a DC Servo motor
		MOT_StepperMotor = 2, ///< Motor is a Stepper Motor
		MOT_BrushlessMotor = 3, ///< Motor is a Brushless Motor
		MOT_CustomMotor = 100, ///< Motor is a custom motor
	} MOT_MotorTypes;

	/// <summary> Values that represent Travel Modes. </summary>
	typedef enum MOT_TravelModes : int
	{
		MOT_TravelModeUndefined,///<Undefined
		MOT_Linear = 0x01,///<Linear travel, default units are millimeters
		MOT_Rotational = 0x02,///<Rotational travel, default units are degrees
	} MOT_TravelModes;

	/// <summary> Values that represent Travel Modes. </summary>
	typedef enum MOT_TravelDirection : short
	{
		MOT_TravelDirectionDisabled = 0x00,///<Disabled or Undefined
		MOT_Forwards = 0x01,///<Move in a Forward direction
		MOT_Reverse = 0x02,///<Move in a Backward / Reverse direction
	} MOT_TravelDirection;

	/// <summary> Values that represent Direction Type. </summary>
	typedef enum MOT_DirectionSense : short
	{
		MOT_Normal = 0x00,///<Move / Jog direction is normal (clockwise).
		MOT_Backwards = 0x01,///<Move / Jog direction is reversed (anti clockwise).
	} MOT_DirectionSense;

	/// <summary> Values that represent Limit Switch Directions. </summary>
	typedef enum MOT_HomeLimitSwitchDirection : short
	{
		MOT_LimitSwitchDirectionUndefined,///<Undefined
		MOT_ReverseLimitSwitch = 0x01,///<Limit switch in forward direction
		MOT_ForwardLimitSwitch = 0x04,///<Limit switch in reverse direction
	} MOT_HomeLimitSwitchDirection;

	/// <summary> Values that represent the motor Jog Modes. </summary>
	typedef enum MOT_JogModes : short
	{
		MOT_JogModeUndefined = 0x00,///<Undefined
		MOT_Continuous = 0x01,///<Continuous jogging
		MOT_SingleStep = 0x02,///<Jog 1 step at a time
	} MOT_JogModes;

	/// <summary> Values that represent the motor Jog Modes. </summary>
	typedef enum MOT_StopModes : short
	{
		MOT_StopModeUndefined = 0x00,///<Undefined
		MOT_Immediate = 0x01,///<Stops immediate
		MOT_Profiled = 0x02,///<Stops using a velocity profile
	} MOT_StopModes;

	/// <summary> Values that represent the motor Button Modes. </summary>
	typedef enum MOT_ButtonModes : WORD
	{
		MOT_ButtonModeUndefined = 0x00,///<Undefined
		MOT_JogMode = 0x01,///<Jog motor in correct direction for button
		MOT_Preset = 0x02,///<Move to preset position
	} MOT_ButtonModes;

	/// <summary> Values that represent Velocity profile Modes. </summary>
	typedef enum MOT_VelocityProfileModes : WORD
	{
		MOT_Trapezoidal = 0x00,///<Trapezoidal Profile
		MOT_SCurve = 0x02,///<S-Curve profile
	} MOT_VelocityProfileModes;

	/// <summary> Value that represent action to be taken when motor hits a limit switch. </summary>
	typedef enum MOT_LimitSwitchModes : WORD
	{
		MOT_LimitSwitchModeUndefined = 0x00,///<Undefined
		MOT_LimitSwitchIgnoreSwitch=0x01,///<Ignore limit switch
		MOT_LimitSwitchMakeOnContact=0x02,///<Switch makes on contact
		MOT_LimitSwitchBreakOnContact=0x03,///<Switch breaks on contact
		MOT_LimitSwitchMakeOnHome=0x04,///<Switch makes on contact when homing
		MOT_LimitSwitchBreakOnHome=0x05,///<Switch breaks on contact when homing
		MOT_PMD_Reserved=0x06,///<Reserved for PMD brushless servo controllers
		MOT_LimitSwitchIgnoreSwitchSwapped = 0x81,///<Ignore limit switch (swapped)
		MOT_LimitSwitchMakeOnContactSwapped = 0x82,///<Switch makes on contact (swapped)
		MOT_LimitSwitchBreakOnContactSwapped = 0x83,///<Switch breaks on contact (swapped)
		MOT_LimitSwitchMakeOnHomeSwapped = 0x84,///<Switch makes on contact when homing (swapped)
		MOT_LimitSwitchBreakOnHomeSwapped = 0x85,///<Switch breaks on contact when homing (swapped)
	} MOT_LimitSwitchModes;

	/// <summary> Value that represent action to be taken when motor hits a limit switch. </summary>
	typedef enum MOT_LimitSwitchSWModes : WORD
	{
		MOT_LimitSwitchSWModeUndefined = 0x00,///<Undefined
		MOT_LimitSwitchIgnored=0x01,///<Ignore limit switch
		MOT_LimitSwitchStopImmediate=0x02,///<Stop immediately when hitting limit switch
		MOT_LimitSwitchStopProfiled=0x03,///<Stop profiled when hitting limit switch
		MOT_LimitSwitchIgnored_Rotational=0x81,///<Ignore limit switch (rotational stage)
		MOT_LimitSwitchStopImmediate_Rotational=0x82,///<Stop immediately when hitting limit switch (rotational stage)
		MOT_LimitSwitchStopProfiled_Rotational=0x83,///<Stop profiled when hitting limit switch (rotational stage)
	} MOT_LimitSwitchSWModes;


	/// <summary> Values that represent MOT_LimitsSoftwareApproachPolicy. </summary>
	typedef enum MOT_LimitsSoftwareApproachPolicy : short
	{
		DisallowIllegalMoves = 0,///<Disable any move outside travel range
		AllowPartialMoves,///<Truncate all moves beyond limit to limit.
		AllowAllMoves,///<Allow all moves, illegal or not
	} MOT_LimitsSoftwareApproachPolicy;

	/// <summary> Values that represent MOT_CurrentLoopPhases. </summary>
	typedef enum MOT_CurrentLoopPhases : WORD
	{
		MOT_PhaseA = 0x0,///< Phase A
		MOT_PhaseB = 0x1,///< Phase B
		MOT_PhaseAB = 0x2,///< Phase A and B
	} MOT_CurrentLoopPhases;

	/// <summary> Values that represent DeviceMessageClass message types. </summary>
	typedef enum MOT_MovementModes
	{
		LinearRange = 0x00,///< Fixed Angular Range defined by MinPosition and MaxPosition
		RotationalUnlimited = 0x01,///< Unlimited angle
		RotationalWrapping = 0x02,///< Angular Range 0 to 360 with wrap around
	} MOT_MovementModes;

	/// <summary> Values that represent DeviceMessageClass message types. </summary>
	typedef enum MOT_MovementDirections
	{
		Quickest = 0x00,///< Uses the shortest travel between two angles
		Forwards = 0x01,///< Only rotate in a forward direction
		Reverse = 0x02,///< Only rotate in a backward direction
	} MOT_MovementDirections;

/** @} */ // Common

/** @defgroup BenchtopBrushlessMotor Benchtop Brushless Motor
 *  This section details the Structures and Functions relavent to the  @ref BBD103_page "Benchtop Brushless Motor"<br />
 *  For an example of how to connect to the device and perform simple operations use the following links:
 *  <list type=bullet>
 *    <item> \ref namespaces_bbd_ex_1 "Example of using the Thorlabs.MotionControl.Benchtop.BrushlessMotor.DLL from a C or C++ project."<br />
 *									  This requires the DLL to be dynamical linked. </item>
 *    <item> \ref namespaces_bbd_ex_2 "Example of using the Thorlabs.MotionControl.Benchtop.BrushlessMotor.DLL from a C# project"<br />
 *									  This uses Marshalling to load and access the C DLL. </item>
 *  </list>
 *  The Thorlabs.MotionControl.Benchtop.BrushlessMotor.DLL requires the following DLLs
 *  <list type=bullet>
 *    <item> Thorlabs.MotionControl.DeviceManager. </item>
 *  </list>
 *  @{
 */

	#pragma pack(1)

	/// <summary> Information about the device generated from serial number and USB info block. </summary>
	typedef struct TLI_DeviceInfo
	{
		/// <summary> The device Type ID, see \ref C_DEVICEID_page "Device serial numbers". </summary>
		DWORD typeID;
		/// <summary> The device description. </summary>
		char description[65];
		/// <summary> The device serial number. </summary>
		char serialNo[9];
		/// <summary> The USB PID number. </summary>
		DWORD PID;

		/// <summary> <c>true</c> if this object is a type known to the Motion Control software. </summary>
		bool isKnownType;
		/// <summary> The motor type (if a motor).
		/// 		  <list type=table>
		///				<item><term>MOT_NotMotor</term><term>0</term></item>
		///				<item><term>MOT_DCMotor</term><term>1</term></item>
		///				<item><term>MOT_StepperMotor</term><term>2</term></item>
		///				<item><term>MOT_BrushlessMotor</term><term>3</term></item>
		///				<item><term>MOT_CustomMotor</term><term>100</term></item>
		/// 		  </list> </summary>
		MOT_MotorTypes motorType;

		/// <summary> <c>true</c> if the device is a piezo device. </summary>
		bool isPiezoDevice;
		/// <summary> <c>true</c> if the device is a laser. </summary>
		bool isLaser;
		/// <summary> <c>true</c> if the device is a custom type. </summary>
		bool isCustomType;
		/// <summary> <c>true</c> if the device is a rack. </summary>
		bool isRack;
		/// <summary> Defines the number of channels available in this device. </summary>
		short maxChannels;
	} TLI_DeviceInfo;

	/// <summary> Structure containing the Hardware Information. </summary>
	typedef struct TLI_HardwareInformation
	{
		/// <summary> The device serial number. </summary>
		/// <remarks> The device serial number is a serial number,<br />starting with 2 digits representing the device type<br /> and a 6 digit unique value.</remarks>
		DWORD serialNumber;
		/// <summary> The device model number. </summary>
		/// <remarks> The model number uniquely identifies the device type as a string. </remarks>
		char modelNumber[8];
		/// <summary> The device type. </summary>
		/// <remarks> Each device type has a unique Type ID: see \ref C_DEVICEID_page "Device serial numbers" </remarks>
		WORD type;
		/// <summary> The device firmware version. </summary>
		DWORD firmwareVersion;
		/// <summary> The device notes read from the device. </summary>
		char notes[48];
		/// <summary> The device dependant data. </summary>
		BYTE deviceDependantData[12];
		/// <summary> The device hardware version. </summary>
		WORD hardwareVersion;
		/// <summary> The device modification state. </summary>
		WORD modificationState;
		/// <summary> The number of channels the device provides. </summary>
		short numChannels;
	} TLI_HardwareInformation;

	/// <summary> Structure containing the velocity parameters. </summary>
	/// <remarks> Moves are performed using a velocity profile.<br />
	/// 		  The move starts at the Minimum Velocity (always 0 at present) and accelerated to the Maximum Velocity using the defined Acceleration.<br/>
	/// 		  The move is usually completed using a similar deceleration.<br/>
	/// 		  For further information see \ref C_MOTOR_sec11 "Positioning" </remarks>
	/// <seealso cref="MOT_JogParameters"/>
	/// <seealso cref="MOT_HomingParameters"/>
	typedef struct MOT_VelocityParameters
	{
		/// <summary> The minimum velocity in \ref DeviceUnits_page usually 0. </summary>
		int minVelocity;
		/// <summary> The acceleration in \ref DeviceUnits_page. </summary>
		int acceleration;
		/// <summary> The maximum velocity in \ref DeviceUnits_page. </summary>
		int maxVelocity;
	} MOT_VelocityParameters;

	/// <summary> Structure containing the jog parameters. </summary>
	/// <remarks> Jogs are performed using a velocity profile over small fixed distances.<br />
	/// 		  The move starts at the Minimum Velocity (always 0 at present) and accelerated to the Maximum Velocity using the defined Acceleration.<br/>
	/// 		  The move is usually completed using a similar deceleration.<br/>
	/// 		  For further information see \ref C_MOTOR_sec12 "Jogging" </remarks>
	/// <seealso cref="MOT_VelocityParameters"/>
	/// <seealso cref="MOT_HomingParameters"/>
	typedef struct MOT_JogParameters
	{
		/// <summary> The jogging mode. </summary>
		/// <remarks> The mode can be one of the following:
		/// 		  <list type=table>
		///				<item><term>1</term><term>Continuous Jogging<br />The device will continue moving until the end stop is reached or the device button is raised</term></item>
		///				<item><term>2</term><term>Step Jogbr />The device will move by a fixed amount as defined in this structure.</term></item>
		/// 		  </list></remarks>
		MOT_JogModes mode;
		/// <summary> The step size in \ref DeviceUnits_page. </summary>
		unsigned int stepSize;
		/// <summary> The MOT_VelocityParameters for the jog. </summary>
		MOT_VelocityParameters velParams;
		/// <summary> The Stop Mode</summary>
		/// <remarks> The Stop Mode determines how the jog should stop.
		/// 		  <list type=table>
		///				<item><term>1</term><term>Immediate</term></item>
		///				<item><term>2</term><term>Profiled.</term></item>
		/// 		  </list> </remarks>
		MOT_StopModes stopMode;
	} MOT_JogParameters;

	/// <summary> Structure containing the homing parameters. </summary>
	/// <remarks> Homing is performed using a constant velocity.<br />
	/// 		  The home starts moving the motor in the defined direction until the limit switch is detected.<br/>
	/// 		  The device will then vback off from the limit switch by  the defined offset distance.<br />
	/// 		  For further information see \ref C_MOTOR_sec10 "Homing" </remarks>
	/// <seealso cref="MOT_VelocityParameters"/>
	/// <seealso cref="MOT_JogParameters"/>
	typedef struct MOT_HomingParameters
	{
		/// <summary> The Homing direction sense </summary>
		/// <remarks> The Homing Operation will always move in a decreasing position sense, but the actuator gearing may change the actual physical sense<br/>
		/// 		  Therefore the homing direction can correct the physical sense.
		/// 		 <list type=table>
		///				<item><term>1</term><term>Forwards</term></item>
		///				<item><term>2</term><term>Backwards.</term></item>
		/// 		  </list></remarks>
		MOT_TravelDirection direction;
		/// <summary> The limit switch direction. </summary>
		/// <remarks> The limit switch which will be hit when homing completes.
		/// 		 <list type=table>
		///				<item><term>1</term><term>Forward Limit Switch</term></item>
		///				<item><term>2</term><term>Reverse Limit Switch.</term></item>
		/// 		  </list</remarks>
		MOT_HomeLimitSwitchDirection limitSwitch;
		/// <summary> The velocity in small indivisible units. </summary>
		/// <remarks> As the homing operation is performed at a much lower velocity, to achieve accuracy, a profile is not required.</remarks>
		unsigned int velocity;
		/// <summary> Distance of home from limit in small indivisible units. </summary>
		unsigned int offsetDistance;
	} MOT_HomingParameters;

	/// <summary> Structure containing velocity profile parameters for advanced motor control. </summary>
	typedef struct MOT_VelocityProfileParameters
	{
		/// <summary> The Velocity Profile Mode. </summary>
		/// <remarks> The Velocity Profile mode can be onw of the following:
		/// 		 <list type=table>
		///				<item><term>0</term><term>Trapezoidal Profile</term></item>
		///				<item><term>2</term><term>S-curve.</term></item>
		/// 		  </list></remarks>
		MOT_VelocityProfileModes mode;
		/// <summary> Maximum rate of change of acceleration. </summary>
		DWORD jerk;
		/// <summary> Not used. </summary>
		WORD notUsed;
		/// <summary> Not used. </summary>
		WORD lastNotUsed;
	} MOT_VelocityProfileParameters;

	/// <summary> Structure containing stage axis parameters. </summary>
	typedef struct MOT_StageAxisParameters
	{
		/// <summary> Two digit identifier of stage type. </summary>
		WORD stageID;
		/// <summary>Defines the axis to which this is applied. </summary>
		/// <remarks> The axis of operation
		/// 		 <list type=table>
		///				<item><term>0</term><term>X Axis</term></item>
		///				<item><term>1</term><term>Y Axis.</term></item>
		///				<item><term>2</term><term>Z Axis.</term></item>
		/// 		  </list></remarks>
		WORD axisID;
		/// <summary> The Catalogue part number. </summary>
		char partNumber[16];
		/// <summary> Eight digit stage serial number. </summary>
		DWORD serialNumber;
		/// <summary> The number of Encoder counts per mm or degree. </summary>
		DWORD countsPerUnit;
		/// <summary> Minimum position in encoder counts usually 0. </summary>
		int minPosition;
		/// <summary> Maximum position in encoder counts. </summary>
		int maxPosition;
		/// <summary> Maximum acceleration in encoder counts per cycle per cycle. </summary>
		int maxAcceleration;
		/// <summary> Maximum decceleration in encoder counts per cycle per cycle. </summary>
		int maxDecceleration;
		/// <summary> Maximum speed in encoder counts per cycle. </summary>
		int maxVelocity;
		/// <summary> Reserved for future use. </summary>
		WORD reserved1;
		/// <summary> Reserved for future use. </summary>
		WORD reserved2;
		/// <summary> Reserved for future use. </summary>
		WORD reserved3;
		/// <summary> Reserved for future use. </summary>
		WORD reserved4;
		/// <summary> Reserved for future use. </summary>
		DWORD reserved5;
		/// <summary> Reserved for future use. </summary>
		DWORD reserved6;
		/// <summary> Reserved for future use. </summary>
		DWORD reserved7;
		/// <summary> Reserved for future use. </summary>
		DWORD reserved8;
	} MOT_StageAxisParameters;

	/// <summary> Structure containing the joystick parameters. </summary>
	typedef struct MOT_JoystickParameters
	{
		/// <summary> Maximum speed in low gear mode in encoder counts per cycle. </summary>
		DWORD lowGearMaxVelocity;
		/// <summary> Maximum speed in high gear mode in encoder counts per cycle.  </summary>
		DWORD highGearMaxVelocity;
		/// <summary> Low gear acceleration in encoder counts per cycle per cycle. </summary>
		DWORD lowGearAcceleration;
		/// <summary> High gear acceleration in encoder counts per cycle per cycle. </summary>
		DWORD highGearAcceleration;
		/// <summary> Travel Direction for the joystick
		/// <remarks> The direction sense of the Joystick
		/// 		 <list type=table>
		///				<item><term>0</term><term>Disabled</term></item>
		///				<item><term>1</term><term>Forwards</term></item>
		///				<item><term>2</term><term>Backwards.</term></item>
		/// 		  </list></remarks>
		MOT_TravelDirection directionSense;
	} MOT_JoystickParameters;

	/// <summary> Structure containing the PID Parameters with extension for brushless DC motors used
	/// in an algorithm involving calculus to control position. </summary>
	typedef struct MOT_BrushlessPositionLoopParameters
	{
		/// <summary> The PID Proportional Gain, range 0 to 0x7FFF. </summary>
		WORD proportionalGain;
		/// <summary> The PID Integral Gain, range 0 to 0x7FFF. </summary>
		WORD integralGain;
		/// <summary> The PID Integral Limit, range 0 to 0x7FFFFFFF. </summary>
		DWORD integralLimit;
		/// <summary> The PID Differential Gain, range 0 to 0x7FFF. </summary>
		WORD differentialGain;
		/// <summary> The PID Derivative Recalculation Time, range 0 to 0x7FFF. </summary>
		WORD derivativeRecalculationTime;
		/// <summary> The PID Factor for Output, range 0 to 0xFFFF where 0xFFFF is 100 %. </summary>
		WORD factorForOutput;
		/// <summary> The PID Velocity Feed Forward factor, range 0 to 0x7FFF. </summary>
		WORD velocityFeedForward;
		/// <summary> The PID Acceleration Feed Forward factor, range 0 to 0x7FFF. </summary>
		WORD accelerationFeedForward;
		/// <summary> The PID Position Error Limit, range 0 to 0x7FFFFFFF. </summary>
		DWORD positionErrorLimit;
		/// <summary> Not used. </summary>
		WORD notUsed;
		/// <summary> Not used. </summary>
		WORD lastNotUsed;
	} MOT_BrushlessPositionLoopParameters;

	/// <summary> Structure containing parameters used to decide when brushless DC motor is settled at the right position. </summary>
	typedef struct MOT_BrushlessTrackSettleParameters
	{
		/// <summary> Time in cycles of 102.4 microsec given for stage to settle, range 1 to 0x7FFF. </summary>
		WORD time;
		/// <summary> Low position error in encoder units when stage is considered settled, range 0 to 0xFFFF. </summary>
		WORD settledError;
		/// <summary> Maximum tolerated position error in encoder units whilst stage settling, range 0 to 0xFFFF. </summary>
		WORD maxTrackingError;
		/// <summary> Not used. </summary>
		WORD notUsed;
		/// <summary> Not used. </summary>
		WORD lastNotUsed;
	} MOT_BrushlessTrackSettleParameters;

	/// <summary> Structure containing the PI Parameters with extension for brushless DC motors used in an algorithm involving calculus to control current. </summary>
	typedef struct MOT_BrushlessCurrentLoopParameters
	{
		/// <summary> The Current Loop Phase. </summary>
		/// <remarks> The current loop phases to be used
		/// 		 <list type=table>
		///				<item><term>0</term><term>Phase A</term></item>
		///				<item><term>1</term><term>Phase B</term></item>
		///				<item><term>2</term><term>Phases A and B.</term></item>
		/// 		  </list></remarks>
		MOT_CurrentLoopPhases phase;
		/// <summary> The PI Proportional Gain, range 0 to 0x7FFF. </summary>
		WORD proportionalGain;
		/// <summary> The PI Integral Gain, range 0 to 0x7FFF. </summary>
		WORD integralGain;
		/// <summary> The PI Integral Limit, range 0 to 0x7FFF. </summary>
		WORD integralLimit;
		/// <summary> The PI Dead error band, range 0 to 0x7FFF. </summary>
		WORD deadErrorBand;
		/// <summary> The PI Feed forward, range 0 to 0x7FFF. </summary>
		WORD feedForward;
		/// <summary> Not used. </summary>
		WORD notUsed;
		/// <summary> Not used. </summary>
		WORD lastNotUsed;
	} MOT_BrushlessCurrentLoopParameters;

	/// <summary> Structure containing parameters to control electrical output to brushless DC motors. </summary>
	typedef struct MOT_BrushlessElectricOutputParameters
	{
		/// <summary> The Continuous current limit, range 0 to 0x7FFF (0 to 100%). </summary>
		WORD continuousCurrentLimit;
		/// <summary> The Excess energy limit, range 0 to 0x7FFF (0 to 100%). </summary>
		WORD excessEnergyLimit;
		/// <summary> The Motor signal limit, range 0 to 0x7FFF (0 to 100%). </summary>
		short motorSignalLimit;
		/// <summary> The Motor signal bias, range -0x7FFF to 0x7FFF. </summary>
		short motorSignalBias;
		/// <summary> Not used. </summary>
		WORD notUsed;
		/// <summary> Not used. </summary>
		WORD lastNotUsed;
	} MOT_BrushlessElectricOutputParameters;

	#pragma pack()
    /// <summary> Build the DeviceList. </summary>
    /// <remarks> This function builds an internal collection of all devices found on the USB that are not currently open. <br />
    /// 		  NOTE, if a device is open, it will not appear in the list until the device has been closed. </remarks>
	/// <returns> The error code (see \ref C_DLL_ERRORCODES_page "Error Codes") or zero if successful. </returns>
    /// 		  \include CodeSnippet_identification.cpp
	/// <seealso cref="TLI_GetDeviceListSize()" />
	/// <seealso cref="TLI_GetDeviceList(SAFEARRAY** stringsReceiver)" />
	/// <seealso cref="TLI_GetDeviceListByType(SAFEARRAY** stringsReceiver, int typeID)" />
	/// <seealso cref="TLI_GetDeviceListByTypes(SAFEARRAY** stringsReceiver, int * typeIDs, int length)" />
	/// <seealso cref="TLI_GetDeviceListExt(char *receiveBuffer, DWORD sizeOfBuffer)" />
	/// <seealso cref="TLI_GetDeviceListByTypeExt(char *receiveBuffer, DWORD sizeOfBuffer, int typeID)" />
	/// <seealso cref="TLI_GetDeviceListByTypesExt(char *receiveBuffer, DWORD sizeOfBuffer, int * typeIDs, int length)" />
	BRUSHLESSMOTOR_API short __cdecl TLI_BuildDeviceList(void);

	/// <summary> Gets the device list size. </summary>
	/// 		  \include CodeSnippet_identification.cpp
	/// <returns> Number of devices in device list. </returns>
	/// <seealso cref="TLI_BuildDeviceList()" />
	/// <seealso cref="TLI_GetDeviceList(SAFEARRAY** stringsReceiver)" />
	/// <seealso cref="TLI_GetDeviceListByType(SAFEARRAY** stringsReceiver, int typeID)" />
	/// <seealso cref="TLI_GetDeviceListByTypes(SAFEARRAY** stringsReceiver, int * typeIDs, int length)" />
	/// <seealso cref="TLI_GetDeviceListExt(char *receiveBuffer, DWORD sizeOfBuffer)" />
	/// <seealso cref="TLI_GetDeviceListByTypeExt(char *receiveBuffer, DWORD sizeOfBuffer, int typeID)" />
	/// <seealso cref="TLI_GetDeviceListByTypesExt(char *receiveBuffer, DWORD sizeOfBuffer, int * typeIDs, int length)" />
	BRUSHLESSMOTOR_API short __cdecl TLI_GetDeviceListSize();

	/// <summary> Get the entire contents of the device list. </summary>
	/// <param name="stringsReceiver"> Outputs a SAFEARRAY of strings holding device serial numbers. </param>
	/// <returns> The error code (see \ref C_DLL_ERRORCODES_page "Error Codes") or zero if successful. </returns>
    /// 		  \include CodeSnippet_identification.cpp
	/// <seealso cref="TLI_GetDeviceListSize()" />
	/// <seealso cref="TLI_BuildDeviceList()" />
	/// <seealso cref="TLI_GetDeviceListByType(SAFEARRAY** stringsReceiver, int typeID)" />
	/// <seealso cref="TLI_GetDeviceListByTypes(SAFEARRAY** stringsReceiver, int * typeIDs, int length)" />
	/// <seealso cref="TLI_GetDeviceListExt(char *receiveBuffer, DWORD sizeOfBuffer)" />
	/// <seealso cref="TLI_GetDeviceListByTypeExt(char *receiveBuffer, DWORD sizeOfBuffer, int typeID)" />
	/// <seealso cref="TLI_GetDeviceListByTypesExt(char *receiveBuffer, DWORD sizeOfBuffer, int * typeIDs, int length)" />
	BRUSHLESSMOTOR_API short __cdecl TLI_GetDeviceList(SAFEARRAY** stringsReceiver);

	/// <summary> Get the contents of the device list which match the supplied typeID. </summary>
	/// <param name="stringsReceiver"> Outputs a SAFEARRAY of strings holding device serial numbers. </param>
	/// <param name="typeID">The typeID of devices to match, see \ref C_DEVICEID_page "Device serial numbers". </param>
	/// <returns> The error code (see \ref C_DLL_ERRORCODES_page "Error Codes") or zero if successful. </returns>
    /// 		  \include CodeSnippet_identification.cpp
	/// <seealso cref="TLI_GetDeviceListSize()" />
	/// <seealso cref="TLI_BuildDeviceList()" />
	/// <seealso cref="TLI_GetDeviceList(SAFEARRAY** stringsReceiver)" />
	/// <seealso cref="TLI_GetDeviceListByTypes(SAFEARRAY** stringsReceiver, int * typeIDs, int length)" />
	/// <seealso cref="TLI_GetDeviceListExt(char *receiveBuffer, DWORD sizeOfBuffer)" />
	/// <seealso cref="TLI_GetDeviceListByTypeExt(char *receiveBuffer, DWORD sizeOfBuffer, int typeID)" />
	/// <seealso cref="TLI_GetDeviceListByTypesExt(char *receiveBuffer, DWORD sizeOfBuffer, int * typeIDs, int length)" />
	BRUSHLESSMOTOR_API short __cdecl TLI_GetDeviceListByType(SAFEARRAY** stringsReceiver, int typeID);

	/// <summary> Get the contents of the device list which match the supplied typeIDs. </summary>
	/// <param name="stringsReceiver"> Outputs a SAFEARRAY of strings holding device serial numbers. </param>
	/// <param name="typeIDs"> list of typeIDs of devices to be matched, see \ref C_DEVICEID_page "Device serial numbers"</param>
	/// <param name="length"> length of type list</param>
	/// <returns> The error code (see \ref C_DLL_ERRORCODES_page "Error Codes") or zero if successful. </returns>
    /// 		  \include CodeSnippet_identification.cpp
	/// <seealso cref="TLI_GetDeviceListSize()" />
	/// <seealso cref="TLI_BuildDeviceList()" />
	/// <seealso cref="TLI_GetDeviceList(SAFEARRAY** stringsReceiver)" />
	/// <seealso cref="TLI_GetDeviceListByType(SAFEARRAY** stringsReceiver, int typeID)" />
	/// <seealso cref="TLI_GetDeviceListExt(char *receiveBuffer, DWORD sizeOfBuffer)" />
	/// <seealso cref="TLI_GetDeviceListByTypeExt(char *receiveBuffer, DWORD sizeOfBuffer, int typeID)" />
	/// <seealso cref="TLI_GetDeviceListByTypesExt(char *receiveBuffer, DWORD sizeOfBuffer, int * typeIDs, int length)" />
	BRUSHLESSMOTOR_API short __cdecl TLI_GetDeviceListByTypes(SAFEARRAY** stringsReceiver, int * typeIDs, int length);

	/// <summary> Get the entire contents of the device list. </summary>
	/// <param name="receiveBuffer"> a buffer in which to receive the list as a comma separated string. </param>
	/// <param name="sizeOfBuffer">	The size of the output string buffer. </param>
	/// <returns> The error code (see \ref C_DLL_ERRORCODES_page "Error Codes") or zero if successful. </returns>
    /// 		  \include CodeSnippet_identification.cpp
	/// <seealso cref="TLI_GetDeviceListSize()" />
	/// <seealso cref="TLI_BuildDeviceList()" />
	/// <seealso cref="TLI_GetDeviceList(SAFEARRAY** stringsReceiver)" />
	/// <seealso cref="TLI_GetDeviceListByType(SAFEARRAY** stringsReceiver, int typeID)" />
	/// <seealso cref="TLI_GetDeviceListByTypes(SAFEARRAY** stringsReceiver, int * typeIDs, int length)" />
	/// <seealso cref="TLI_GetDeviceListByTypeExt(char *receiveBuffer, DWORD sizeOfBuffer, int typeID)" />
	/// <seealso cref="TLI_GetDeviceListByTypesExt(char *receiveBuffer, DWORD sizeOfBuffer, int * typeIDs, int length)" />
	BRUSHLESSMOTOR_API short __cdecl TLI_GetDeviceListExt(char *receiveBuffer, DWORD sizeOfBuffer);

	/// <summary> Get the contents of the device list which match the supplied typeID. </summary>
	/// <param name="receiveBuffer"> a buffer in which to receive the list as a comma separated string. </param>
	/// <param name="sizeOfBuffer">	The size of the output string buffer. </param>
	/// <param name="typeID"> The typeID of devices to be matched, see \ref C_DEVICEID_page "Device serial numbers"</param>
	/// <returns> The error code (see \ref C_DLL_ERRORCODES_page "Error Codes") or zero if successful. </returns>
    /// 		  \include CodeSnippet_identification.cpp
	/// <seealso cref="TLI_GetDeviceListSize()" />
	/// <seealso cref="TLI_BuildDeviceList()" />
	/// <seealso cref="TLI_GetDeviceList(SAFEARRAY** stringsReceiver)" />
	/// <seealso cref="TLI_GetDeviceListByType(SAFEARRAY** stringsReceiver, int typeID)" />
	/// <seealso cref="TLI_GetDeviceListByTypes(SAFEARRAY** stringsReceiver, int * typeIDs, int length)" />
	/// <seealso cref="TLI_GetDeviceListExt(char *receiveBuffer, DWORD sizeOfBuffer)" />
	/// <seealso cref="TLI_GetDeviceListByTypesExt(char *receiveBuffer, DWORD sizeOfBuffer, int * typeIDs, int length)" />
	BRUSHLESSMOTOR_API short __cdecl TLI_GetDeviceListByTypeExt(char *receiveBuffer, DWORD sizeOfBuffer, int typeID);

	/// <summary> Get the contents of the device list which match the supplied typeIDs. </summary>
	/// <param name="receiveBuffer"> a buffer in which to receive the list as a comma separated string. </param>
	/// <param name="sizeOfBuffer">	The size of the output string buffer. </param>
	/// <param name="typeIDs"> list of typeIDs of devices to be matched, see \ref C_DEVICEID_page "Device serial numbers"</param>
	/// <param name="length"> length of type list</param>
	/// <returns> The error code (see \ref C_DLL_ERRORCODES_page "Error Codes") or zero if successful. </returns>
    /// 		  \include CodeSnippet_identification.cpp
	/// <seealso cref="TLI_GetDeviceListSize()" />
	/// <seealso cref="TLI_BuildDeviceList()" />
	/// <seealso cref="TLI_GetDeviceList(SAFEARRAY** stringsReceiver)" />
	/// <seealso cref="TLI_GetDeviceListByType(SAFEARRAY** stringsReceiver, int typeID)" />
	/// <seealso cref="TLI_GetDeviceListByTypes(SAFEARRAY** stringsReceiver, int * typeIDs, int length)" />
	/// <seealso cref="TLI_GetDeviceListExt(char *receiveBuffer, DWORD sizeOfBuffer)" />
	/// <seealso cref="TLI_GetDeviceListByTypeExt(char *receiveBuffer, DWORD sizeOfBuffer, int typeID)" />
	BRUSHLESSMOTOR_API short __cdecl TLI_GetDeviceListByTypesExt(char *receiveBuffer, DWORD sizeOfBuffer, int * typeIDs, int length);

	/// <summary> Get the device information from the USB port. </summary>
	/// <remarks> The Device Info is read from the USB port not from the device itself.<remarks>
	/// <param name="serialNo"> The serial number of the device. </param>
	/// <param name="info">    The <see cref="TLI_DeviceInfo"/> device information. </param>
	/// <returns> 1 if successful, 0 if not. </returns>
    /// 		  \include CodeSnippet_identification.cpp
	/// <seealso cref="TLI_GetDeviceListSize()" />
	/// <seealso cref="TLI_BuildDeviceList()" />
	/// <seealso cref="TLI_GetDeviceList(SAFEARRAY** stringsReceiver)" />
	/// <seealso cref="TLI_GetDeviceListByType(SAFEARRAY** stringsReceiver, int typeID)" />
	/// <seealso cref="TLI_GetDeviceListByTypes(SAFEARRAY** stringsReceiver, int * typeIDs, int length)" />
	/// <seealso cref="TLI_GetDeviceListExt(char *receiveBuffer, DWORD sizeOfBuffer)" />
	/// <seealso cref="TLI_GetDeviceListByTypeExt(char *receiveBuffer, DWORD sizeOfBuffer, int typeID)" />
	/// <seealso cref="TLI_GetDeviceListByTypesExt(char *receiveBuffer, DWORD sizeOfBuffer, int * typeIDs, int length)" />
	BRUSHLESSMOTOR_API short __cdecl TLI_GetDeviceInfo(char const * serialNo, TLI_DeviceInfo *info);

	/// <summary> Open the device for communications. </summary>
	/// <param name="serialNo">	The serial no of the controller to be connected. </param>
	/// <returns> The error code (see \ref C_DLL_ERRORCODES_page "Error Codes") or zero if successful. </returns>
	/// 		  \include CodeSnippet_connectionN.cpp
	/// <seealso cref="BMC_Close(char const * serialNo)" />
	BRUSHLESSMOTOR_API short __cdecl BMC_Open(char const * serialNo);

	/// <summary> Disconnect and close the device. </summary>
	/// <param name="serialNo">	The serial no of the controller to be disconnected. </param>
	/// <returns> The error code (see \ref C_DLL_ERRORCODES_page "Error Codes") or zero if successful. </returns>
	/// 		  \include CodeSnippet_connectionN.cpp
	/// <seealso cref="BMC_Open(char const * serialNo)" />
	BRUSHLESSMOTOR_API short __cdecl BMC_Close(char const * serialNo);

	/// <summary>	Check connection. </summary>
	/// <param name="serialNo">	The device serial no. </param>
	/// <returns> true if the USB is listed by the ftdi controller</returns>
	/// \include CodeSnippet_CheckConnection.cpp
	BRUSHLESSMOTOR_API bool __cdecl BMC_CheckConnection(char const * serialNo);

	/// <summary> Verifies that the specified channel is valid. </summary>
	/// <param name="serialNo"> The controller serial no. </param>
	/// <param name="channel">  The requested channel (1 to n). </param>
	/// <returns> <c>true</c> if the channel is valid. </returns>
	/// 		  \include CodeSnippet_connectionN.cpp
	BRUSHLESSMOTOR_API bool __cdecl BMC_IsChannelValid(char const * serialNo, short channel);

	/// <summary> Gets the number of channels available to this device. </summary>
	/// <remarks> This function returns ther number of available bays, not the number of bays filled.</remarks>
	/// <param name="serialNo"> The controller serial no. </param>
	/// <returns> The number of channels available on this device. </returns>
	/// 		  \include CodeSnippet_connectionN.cpp
	BRUSHLESSMOTOR_API int __cdecl BMC_MaxChannelCount(char const * serialNo);

	/// <summary> Sends a command to the device to make it identify iteself. </summary>
	/// <param name="serialNo">	The controller serial no. </param>
	/// <returns> The error code (see \ref C_DLL_ERRORCODES_page "Error Codes") or zero if successful. </returns>
	BRUSHLESSMOTOR_API short __cdecl BMC_Identify(char const * serialNo);

	/// <summary> Gets the hardware information from the device. </summary>
	/// <param name="serialNo">		    The controller serial no. </param>
	/// <param name="channel">		    The channel (1 to n). </param>
	/// <param name="modelNo">		    Address of a buffer to receive the model number string. Minimum 8 characters </param>
	/// <param name="sizeOfModelNo">	    The size of the model number buffer, minimum of 8 characters. </param>
	/// <param name="type">		    Address of a WORD to receive the hardware type number. </param>
	/// <param name="numChannels">	    Address of a short to receive the  number of channels. </param>
	/// <param name="notes">		    Address of a buffer to receive the notes describing the device. </param>
	/// <param name="sizeOfNotes">		    The size of the notes buffer, minimum of 48 characters. </param>
	/// <param name="firmwareVersion"> Address of a DWORD to receive the  firmware version number made up of 4 byte parts. </param>
	/// <param name="hardwareVersion"> Address of a WORD to receive the  hardware version number. </param>
	/// <param name="modificationState">	    Address of a WORD to receive the hardware modification state number. </param>
	/// <returns> The error code (see \ref C_DLL_ERRORCODES_page "Error Codes") or zero if successful. </returns>
	/// 		  \include CodeSnippet_identify.cpp
	BRUSHLESSMOTOR_API short __cdecl BMC_GetHardwareInfo(char const * serialNo, short channel, char * modelNo, DWORD sizeOfModelNo, WORD * type, short * numChannels,
		char * notes, DWORD sizeOfNotes, DWORD * firmwareVersion, WORD * hardwareVersion, WORD * modificationState);

	/// <summary> Gets the hardware information in a block. </summary>
	/// <param name="serialNo">	The controller serial no. </param>
	/// <param name="channel">  The channel (1 to n). </param>
	/// <param name="hardwareInfo"> Address of a TLI_HardwareInformation structure to receive the hardware information. </param>
	/// <returns> The error code (see \ref C_DLL_ERRORCODES_page "Error Codes") or zero if successful. </returns>
	/// 		  \include CodeSnippet_identify.cpp
	BRUSHLESSMOTOR_API short __cdecl BMC_GetHardwareInfoBlock(char const * serialNo, short channel, TLI_HardwareInformation *hardwareInfo);

	/// <summary> Gets the number of channels in the device. </summary>
	/// <param name="serialNo">	The controller serial no. </param>
	/// <returns> The number of channels. </returns>
	BRUSHLESSMOTOR_API short __cdecl BMC_GetNumChannels(char const * serialNo);

	/// <summary> Gets version number of the device firmware. </summary>
	/// <param name="serialNo">	The controller serial no. </param>
	/// <param name="channel">  The channel (1 to n). </param>
	/// <returns> The device firmware version number made up of 4 byte parts. </returns>
	/// 		  \include CodeSnippet_identify.cpp
	BRUSHLESSMOTOR_API DWORD __cdecl BMC_GetFirmwareVersion(char const * serialNo, short channel);

	/// <summary> Gets version number of the device software. </summary>
	/// <param name="serialNo">	The controller serial no. </param>
	/// <returns> The device software version number made up of 4 byte parts. </returns>
	/// 		  \include CodeSnippet_identify.cpp
	BRUSHLESSMOTOR_API DWORD __cdecl BMC_GetSoftwareVersion(char const * serialNo);

	/// <summary> Update device with stored settings. </summary>
	/// <param name="serialNo"> The controller serial no. </param>
	/// <param name="channel">  The channel (1 to n). </param>
	/// <returns> <c>true</c> if successful, false if not. </returns>
	/// 		  \include CodeSnippet_connectionN.cpp
	BRUSHLESSMOTOR_API bool __cdecl BMC_LoadSettings(char const * serialNo, short channel);

	/// <summary> Update device with named settings. </summary>
	/// <param name="serialNo"> The serial no. </param>
	/// <param name="channel">  The channel. </param>
	/// <param name="settingsName"> Name of settings stored away from device. </param>
	/// <returns> <c>true</c> if successful, false if not. </returns>
	///             \include CodeSnippet_connection1.cpp
	BRUSHLESSMOTOR_API bool __cdecl BMC_LoadNamedSettings(char const * serialNo, short channel, char const *settingsName);

	/// <summary> persist the devices current settings. </summary>
	/// <param name="serialNo">	The device serial no. </param>
	/// <param name="channel">  The channel (1 to n). </param>
	/// <returns> <c>true</c> if successful, false if not. </returns>
	BRUSHLESSMOTOR_API bool __cdecl BMC_PersistSettings(char const * serialNo, short channel);

	/// <summary> Disable the channel so that motor can be moved by hand. </summary>
	/// <remarks> When disabled power is removed from the motor and it can be freely moved.</remarks>
	/// <param name="serialNo">	The controller serial no. </param>
	/// <param name="channel">  The channel (1 to n). </param>
	/// <returns> The error code (see \ref C_DLL_ERRORCODES_page "Error Codes") or zero if successful. </returns>
	/// <seealso cref="BMC_EnableChannel(char const * serialNo, short channel)" />
	BRUSHLESSMOTOR_API short __cdecl BMC_DisableChannel(char const * serialNo, short channel);

	/// <summary> Enable channel for computer control. </summary>
	/// <remarks> When enabled power is applied to the motor so it is fixed in position.</remarks>
	/// <param name="serialNo">	The controller serial no. </param>
	/// <param name="channel">  The channel (1 to n). </param>
	/// <returns> The error code (see \ref C_DLL_ERRORCODES_page "Error Codes") or zero if successful. </returns>
	/// <seealso cref="BMC_DisableChannel(char const * serialNo, short channel)" />
	BRUSHLESSMOTOR_API short __cdecl BMC_EnableChannel(char const * serialNo, short channel);

	/// <summary> Get number of positions. </summary>
	/// <remarks> The GetNumberPositions function will get the maximum position reachable by the device.<br />
	/// 		  The motor may need to be \ref C_MOTOR_sec10 "Homed" before this parameter can be used. </remarks>
	/// <param name="serialNo">	The controller serial no. </param>
	/// <param name="channel">  The channel (1 to n). </param>
	/// <returns> The number of positions. </returns>
	/// <seealso cref="BMC_MoveToPosition(char const * serialNo, short channel, int index)" />
	/// <seealso cref="BMC_GetPosition(char const * serialNo, short channel)" />
	/// <seealso cref="BMC_Home(char const * serialNo, short channel)" />
	/// 		  \include CodeSnippet_move.cpp
	BRUSHLESSMOTOR_API int __cdecl BMC_GetNumberPositions(char const * serialNo, short channel);

	/// <summary> Get the current position. </summary>
	/// <remarks> The current position is the last recorded position.<br />
	/// 		  The current position is updated either by the polling mechanism or<br />
	/// 		  by calling <see cref="RequestPosition" /> or <see cref="RequestStatus" />.</remarks>
	/// <param name="serialNo">	The controller serial no. </param>
	/// <param name="channel">  The channel (1 to n). </param>
	/// <returns> The current position in \ref DeviceUnits_page. </returns>
	/// <seealso cref="BMC_GetNumberPositions(char const * serialNo, short channel)" />
	/// <seealso cref="BMC_MoveToPosition(char const * serialNo, short channel, int index)" />
	/// <seealso cref="BMC_Home(char const * serialNo, short channel)" />
	/// 		  \include CodeSnippet_move.cpp
	BRUSHLESSMOTOR_API int __cdecl BMC_GetPosition(char const * serialNo, short channel);

	/// <summary> Can the device perform a Home. </summary>
	/// <param name="serialNo"> The controller serial no. </param>
	/// <param name="channel">  The channel (1 to n). </param>
	/// <returns> <c>true</c> if the device can home. </returns>
	BRUSHLESSMOTOR_API bool __cdecl BMC_CanHome(char const * serialNo, short channel);

	/// <summary> Does the device need to be Homed before a move can be performed. </summary>
	/// <remarks> @deprecated superceded by <see cref="BMC_CanMoveWithoutHomingFirst(char const * serialNo, short channel)"/> </remarks>
	/// <param name="serialNo"> The controller serial no. </param>
	/// <param name="channel">  The channel (1 to n). </param>
	/// <returns> <c>true</c> if the device needs homing. </returns>
	BRUSHLESSMOTOR_API bool __cdecl BMC_NeedsHoming(char const * serialNo, short channel);

	/// <summary> Can this device be moved without Homing. </summary>
	/// <param name="serialNo"> The serial no. </param>
	/// <param name="channel">  The channel. </param>
	/// <returns> <c>true</c> if the device does not need to be homed before a move can be commanded. </returns>
	BRUSHLESSMOTOR_API bool __cdecl BMC_CanMoveWithoutHomingFirst(char const * serialNo, short channel);

	/// <summary> Home the device. </summary>
	/// <remarks> Homing the device will set the device to a known state and determine the home position,<br />
	/// 		  see \ref C_MOTOR_sec10 "Homing" for more detail. </remarks>
	/// <param name="serialNo">	The controller serial no. </param>
	/// <param name="channel">  The channel (1 to n). </param>
	/// <returns> The error code (see \ref C_DLL_ERRORCODES_page "Error Codes") or zero if move successfully started. </returns>
	/// <seealso cref="BMC_GetNumberPositions(char const * serialNo, short channel)" />
	/// <seealso cref="BMC_MoveToPosition(char const * serialNo, short channel, int index)" />
	/// <seealso cref="BMC_GetPosition(char const * serialNo, short channel)" />
	/// 		  \include CodeSnippet_move.cpp
	BRUSHLESSMOTOR_API short __cdecl BMC_Home(char const * serialNo, short channel);

	/// <summary> Set to allow a device to be positioned without prior homing. </summary>
	/// <param name="serialNo"> The controller serial no. </param>
	/// <param name="channel">  The channel (1 to n). </param>
	/// <returns> The error code (see \ref C_DLL_ERRORCODES_page "Error Codes") or zero if move successfully started. </returns>
	BRUSHLESSMOTOR_API short BMC_OverrideHomeRequirement(char const * serialNo, short channel);

	/// <summary> Clears the device message queue. </summary>
	/// <remarks> see \ref C_MESSAGES_page "Device Messages" for details on how to use messages. </remarks>
	/// <param name="serialNo"> The controller serial no. </param>
	/// <param name="channel">  The channel (1 to n). </param>
	/// <returns> The error code (see \ref C_DLL_ERRORCODES_page "Error Codes") or zero if successful. </returns>
	BRUSHLESSMOTOR_API short BMC_ClearMessageQueue(char const * serialNo, short channel);

	/// <summary> Registers a callback on the message queue. </summary>
	/// <remarks> see \ref C_MESSAGES_page "Device Messages" for details on how to use messages. </remarks>
	/// <param name="serialNo"> The controller serial no. </param>
	/// <param name="channel">  The channel (1 to n). </param>
	/// <param name="functionPointer"> A function pointer to be called whenever messages are received. </param>
	/// <returns> The error code (see \ref C_DLL_ERRORCODES_page "Error Codes") or zero if successful. </returns>
	BRUSHLESSMOTOR_API short __cdecl BMC_RegisterMessageCallback(char const * serialNo, short channel, void(*functionPointer)());

	/// <summary> Gets the MessageQueue size. </summary>
	/// <remarks> see \ref C_MESSAGES_page "Device Messages" for details on how to use messages. </remarks>
	/// <param name="serialNo"> The controller serial no. </param>
	/// <param name="channel">  The channel (1 to n). </param>
	/// <returns> number of messages in the queue. </returns>
	BRUSHLESSMOTOR_API int __cdecl BMC_MessageQueueSize(char const * serialNo, short channel);

	/// <summary> Get the next MessageQueue item if it is available. </summary>
	/// <remarks> see \ref C_MESSAGES_page "Device Messages" for details on how to use messages. </remarks>
	/// <param name="serialNo"> The controller serial no. </param>
	/// <param name="channel">  The channel (1 to n). </param>
	/// <param name="messageType"> Address of the WORD to receive the message type. </param>
	/// <param name="messageID"> Address of the WORD to receive themessage ID. </param>
	/// <param name="messageData"> Address of the DWORD to receive the messageData. </param>
	/// <returns> <c>true</c> if successful, false if not. </returns>
	BRUSHLESSMOTOR_API bool __cdecl BMC_GetNextMessage(char const * serialNo, short channel, WORD * messageType, WORD * messageID, DWORD *messageData);

	/// <summary> Get the next MessageQueue item if it is available. </summary>
	/// <remarks> see \ref C_MESSAGES_page "Device Messages" for details on how to use messages. </remarks>
	/// <param name="serialNo"> The controller serial no. </param>
	/// <param name="channel">  The channel (1 to n). </param>
	/// <param name="messageType"> Address of the WORD to receive the message type. </param>
	/// <param name="messageID"> Address of the WORD to receive themessage ID. </param>
	/// <param name="messageData"> Address of the DWORD to receive the messageData. </param>
	/// <returns> <c>true</c> if successful, false if not. </returns>
	BRUSHLESSMOTOR_API bool __cdecl BMC_WaitForMessage(char const * serialNo, short channel, WORD * messageType, WORD * messageID, DWORD *messageData);

	/// <summary> Requests the homing parameters. </summary>
	/// <remarks> see \ref C_MOTOR_sec10 "Homing" for more detail.<remarks>
	/// <param name="serialNo">	The controller serial no. </param>
	/// <param name="channel">  The channel (1 to n). </param>
	/// <returns> The error code (see \ref C_DLL_ERRORCODES_page "Error Codes") or zero if successful. </returns>
	/// <seealso cref="BMC_GetHomingVelocity(char const * serialNo, short channel)" />
	/// <seealso cref="BMC_SetHomingVelocity(char const * serialNo, short channel, unsigned int velocity)" />
	/// <seealso cref="BMC_GetHomingParamsBlock(char const * serialNo, short channel, MOT_HomingParameters *homingParams)" />
	/// <seealso cref="BMC_SetHomingParamsBlock(char const * serialNo, short channel, MOT_HomingParameters *homingParams)" />
	BRUSHLESSMOTOR_API short __cdecl BMC_RequestHomingParams(char const * serialNo, short channel);

	/// <summary> Gets the homing velocity. </summary>
	/// <remarks> see \ref C_MOTOR_sec10 "Homing" for more detail.<remarks>
	/// <param name="serialNo">	The controller serial no. </param>
	/// <param name="channel">  The channel (1 to n). </param>
	/// <returns> The homing velocity in \ref DeviceUnits_page. </returns>
	/// <seealso cref="BMC_RequestHomingParams(char const * serialNo, short channel)" />
	/// <seealso cref="BMC_SetHomingVelocity(char const * serialNo, short channel, unsigned int velocity)" />
	/// <seealso cref="BMC_GetHomingParamsBlock(char const * serialNo, short channel, MOT_HomingParameters *homingParams)" />
	/// <seealso cref="BMC_SetHomingParamsBlock(char const * serialNo, short channel, MOT_HomingParameters *homingParams)" />
	BRUSHLESSMOTOR_API unsigned int __cdecl BMC_GetHomingVelocity(char const * serialNo, short channel);

	/// <summary> Sets the homing velocity. </summary>
	/// <remarks> see \ref C_MOTOR_sec10 "Homing" for more detail.<remarks>
	/// <param name="serialNo">	The controller serial no. </param>
	/// <param name="channel">  The channel (1 to n). </param>
	/// <param name="velocity"> The homing velocity in \ref DeviceUnits_page. </param>
	/// <returns> The error code (see \ref C_DLL_ERRORCODES_page "Error Codes") or zero if successful. </returns>
	/// <seealso cref="BMC_RequestHomingParams(char const * serialNo, short channel)" />
	/// <seealso cref="BMC_GetHomingVelocity(char const * serialNo, short channel)" />
	/// <seealso cref="BMC_GetHomingParamsBlock(char const * serialNo, short channel, MOT_HomingParameters *homingParams)" />
	/// <seealso cref="BMC_SetHomingParamsBlock(char const * serialNo, short channel, MOT_HomingParameters *homingParams)" />
	BRUSHLESSMOTOR_API short __cdecl BMC_SetHomingVelocity(char const * serialNo, short channel, unsigned int velocity);

	/// <summary> Requests the jog parameters. </summary>
	/// <remarks> see \ref C_MOTOR_sec12 "Jogging" for more detail.<remarks>
	/// <param name="serialNo"> The device serial no. </param>
	/// <param name="channel"> The channel (1 to n). </param>
	/// <returns> The error code (see \ref C_DLL_ERRORCODES_page "Error Codes") or zero if successful. </returns>
	/// <seealso cref="BMC_GetJogMode(char const * serialNo, short channel, MOT_JogModes * mode, MOT_StopModes * stopMode)" />
	/// <seealso cref="BMC_GetJogStepSize(char const * serialNo, short channel)" />
	/// <seealso cref="BMC_GetJogVelParams(char const * serialNo, short channel, int * acceleration, int * maxVelocity)" />
	/// <seealso cref="BMC_GetJogParamsBlock(char const * serialNo, short channel, MOT_JogParameters *jogParams)" />
	/// 		  \include CodeSnippet_jogpars.cpp
	BRUSHLESSMOTOR_API short __cdecl BMC_RequestJogParams(char const * serialNo, short channel);

	/// <summary> Gets the jog mode. </summary>
	/// <remarks> see \ref C_MOTOR_sec12 "Jogging" for more detail.<remarks>
	/// <param name="serialNo">	The controller serial no. </param>
	/// <param name="channel"> The channel (1 to n). </param>
	/// <param name="mode"> The address of the short mode to recieve the Mode.
	/// 					 <list type=table>
	///							<item><term>Jog step</term><term>1</term></item>
	///							<item><term>Continuous</term><term>2</term></item>
	/// 					 </list> </param>
	/// <param name="stopMode"> The address of the short stopMode to recieve the StopMode.
	/// 					<list type=table>
	///							<item><term>Immediate Stop</term><term>1</term></item>
	///							<item><term>Profiled Stop</term><term>2</term></item>
	/// 					 </list> </param>
	/// <returns> The error code (see \ref C_DLL_ERRORCODES_page "Error Codes") or zero if successful. </returns>
	/// <seealso cref="BMC_RequestJogParams(char const * serialNo, short channel)" />
	/// <seealso cref="BMC_SetJogMode(char const * serialNo, short channel, MOT_JogModes mode, MOT_StopModes stopMode)" />
	/// <seealso cref="BMC_GetJogStepSize(char const * serialNo, short channel)" />
	/// <seealso cref="BMC_SetJogStepSize(char const * serialNo, short channel, unsigned int stepSize)" />
	/// <seealso cref="BMC_SetJogVelParams(char const * serialNo, short channel, int acceleration, int maxVelocity)" />
	/// <seealso cref="BMC_GetJogVelParams(char const * serialNo, short channel, int * acceleration, int * maxVelocity)" />
	/// <seealso cref="BMC_GetJogParamsBlock(char const * serialNo, short channel, MOT_JogParameters *jogParams)" />
	/// <seealso cref="BMC_SetJogParamsBlock(char const * serialNo, short channel, MOT_JogParameters *jogParams)" />
	/// <seealso cref="BMC_MoveJog(char const * serialNo, short channel, MOT_TravelDirection jogDirection)" />
	/// 		  \include CodeSnippet_jogpars.cpp
	BRUSHLESSMOTOR_API short __cdecl BMC_GetJogMode(char const * serialNo, short channel, MOT_JogModes * mode, MOT_StopModes * stopMode);

	/// <summary> Sets the jog mode. </summary>
	/// <remarks> see \ref C_MOTOR_sec12 "Jogging" for more detail.<remarks>
	/// <param name="serialNo">	The controller serial no. </param>
	/// <param name="channel"> The channel (1 to n). </param>
	/// <param name="mode"> The jog mode.
	/// 					 <list type=table>
	///							<item><term>Jog step</term><term>1</term></item>
	///							<item><term>Continuous</term><term>2</term></item>
	/// 					 </list> </param>
	/// <param name="stopMode"> The StopMode.
	/// 					<list type=table>
	///							<item><term>Immediate Stop</term><term>1</term></item>
	///							<item><term>Profiled Stop</term><term>2</term></item>
	/// 					 </list>  </param>
	/// <returns> The error code (see \ref C_DLL_ERRORCODES_page "Error Codes") or zero if successful. </returns>
	/// <seealso cref="BMC_GetJogMode(char const * serialNo, short channel, MOT_JogModes * mode, MOT_StopModes * stopMode)" />
	/// <seealso cref="BMC_GetJogStepSize(char const * serialNo, short channel)" />
	/// <seealso cref="BMC_SetJogStepSize(char const * serialNo, short channel, unsigned int stepSize)" />
	/// <seealso cref="BMC_SetJogVelParams(char const * serialNo, short channel, int acceleration, int maxVelocity)" />
	/// <seealso cref="BMC_GetJogVelParams(char const * serialNo, short channel, int * acceleration, int * maxVelocity)" />
	/// <seealso cref="BMC_GetJogParamsBlock(char const * serialNo, short channel, MOT_JogParameters *jogParams)" />
	/// <seealso cref="BMC_SetJogParamsBlock(char const * serialNo, short channel, MOT_JogParameters *jogParams)" />
	/// <seealso cref="BMC_MoveJog(char const * serialNo, short channel, MOT_TravelDirection jogDirection)" />
	/// 		  \include CodeSnippet_jogpars.cpp
	BRUSHLESSMOTOR_API short __cdecl BMC_SetJogMode(char const * serialNo, short channel, MOT_JogModes mode, MOT_StopModes stopMode);

	/// <summary> Gets the distance to move when jogging. </summary>
	/// <remarks> see \ref C_MOTOR_sec12 "Jogging" for more detail.<remarks>
	/// <param name="serialNo">	The controller serial no. </param>
	/// <param name="channel"> The channel (1 to n). </param>
	/// <returns> The step in \ref DeviceUnits_page. </returns>
	/// <seealso cref="BMC_RequestJogParams(char const * serialNo, short channel)" />
	/// <seealso cref="BMC_GetJogMode(char const * serialNo, short channel, MOT_JogModes * mode, MOT_StopModes * stopMode)" />
	/// <seealso cref="BMC_SetJogMode(char const * serialNo, short channel, MOT_JogModes mode, MOT_StopModes stopMode)" />
	/// <seealso cref="BMC_SetJogStepSize(char const * serialNo, short channel, unsigned int stepSize)" />
	/// <seealso cref="BMC_SetJogVelParams(char const * serialNo, short channel, int acceleration, int maxVelocity)" />
	/// <seealso cref="BMC_GetJogVelParams(char const * serialNo, short channel, int * acceleration, int * maxVelocity)" />
	/// <seealso cref="BMC_GetJogParamsBlock(char const * serialNo, short channel, MOT_JogParameters *jogParams)" />
	/// <seealso cref="BMC_SetJogParamsBlock(char const * serialNo, short channel, MOT_JogParameters *jogParams)" />
	/// <seealso cref="BMC_MoveJog(char const * serialNo, short channel, MOT_TravelDirection jogDirection)" />
	/// 		  \include CodeSnippet_jogpars.cpp
	BRUSHLESSMOTOR_API unsigned int __cdecl BMC_GetJogStepSize(char const * serialNo, short channel);

	/// <summary> Sets the distance to move on jogging. </summary>
	/// <remarks> see \ref C_MOTOR_sec12 "Jogging" for more detail.<remarks>
	/// <param name="serialNo">	The controller serial no. </param>
	/// <param name="channel"> The channel (1 to n). </param>
	/// <param name="stepSize"> The step in \ref DeviceUnits_page. </param>
	/// <returns> The error code (see \ref C_DLL_ERRORCODES_page "Error Codes") or zero if successful. </returns>
	/// <seealso cref="BMC_GetJogMode(char const * serialNo, short channel, MOT_JogModes * mode, MOT_StopModes * stopMode)" />
	/// <seealso cref="BMC_SetJogMode(char const * serialNo, short channel, MOT_JogModes mode, MOT_StopModes stopMode)" />
	/// <seealso cref="BMC_GetJogStepSize(char const * serialNo, short channel)" />
	/// <seealso cref="BMC_SetJogVelParams(char const * serialNo, short channel, int acceleration, int maxVelocity)" />
	/// <seealso cref="BMC_GetJogVelParams(char const * serialNo, short channel, int * acceleration, int * maxVelocity)" />
	/// <seealso cref="BMC_GetJogParamsBlock(char const * serialNo, short channel, MOT_JogParameters *jogParams)" />
	/// <seealso cref="BMC_SetJogParamsBlock(char const * serialNo, short channel, MOT_JogParameters *jogParams)" />
	/// <seealso cref="BMC_MoveJog(char const * serialNo, short channel, MOT_TravelDirection jogDirection)" />
	/// 		  \include CodeSnippet_jogpars.cpp
	BRUSHLESSMOTOR_API short __cdecl BMC_SetJogStepSize(char const * serialNo, short channel, unsigned int stepSize);

	/// <summary> Gets the jog velocity parameters. </summary>
	/// <remarks> see \ref C_MOTOR_sec12 "Jogging" for more detail.<remarks>
	/// <param name="serialNo">	The controller serial no. </param>
	/// <param name="channel"> The channel (1 to n). </param>
	/// <param name="acceleration"> Address of the parameter to receive the acceleration in \ref DeviceUnits_page. </param>
	/// <param name="maxVelocity"> Address of the parameter to receive the velocity in \ref DeviceUnits_page. </param>
	/// <returns> The error code (see \ref C_DLL_ERRORCODES_page "Error Codes") or zero if successful. </returns>
	/// <seealso cref="BMC_RequestJogParams(char const * serialNo, short channel)" />
	/// <seealso cref="BMC_GetJogMode(char const * serialNo, short channel, MOT_JogModes * mode, MOT_StopModes * stopMode)" />
	/// <seealso cref="BMC_SetJogMode(char const * serialNo, short channel, MOT_JogModes mode, MOT_StopModes stopMode)" />
	/// <seealso cref="BMC_GetJogStepSize(char const * serialNo, short channel)" />
	/// <seealso cref="BMC_SetJogStepSize(char const * serialNo, short channel, unsigned int stepSize)" />
	/// <seealso cref="BMC_SetJogVelParams(char const * serialNo, short channel, int acceleration, int maxVelocity)" />
	/// <seealso cref="BMC_GetJogParamsBlock(char const * serialNo, short channel, MOT_JogParameters *jogParams)" />
	/// <seealso cref="BMC_SetJogParamsBlock(char const * serialNo, short channel, MOT_JogParameters *jogParams)" />
	/// <seealso cref="BMC_MoveJog(char const * serialNo, short channel, MOT_TravelDirection jogDirection)" />
	/// 		  \include CodeSnippet_jogpars.cpp
	BRUSHLESSMOTOR_API short __cdecl BMC_GetJogVelParams(char const * serialNo, short channel, int * acceleration, int * maxVelocity);

	/// <summary> Sets jog velocity parameters. </summary>
	/// <remarks> see \ref C_MOTOR_sec12 "Jogging" for more detail.<remarks>
	/// <param name="serialNo">	The controller serial no. </param>
	/// <param name="channel"> The channel (1 to n). </param>
	/// <param name="acceleration">   The acceleration in \ref DeviceUnits_page. </param>
	/// <param name="maxVelocity"> The maximum velocity in \ref DeviceUnits_page. </param>
	/// <returns> The error code (see \ref C_DLL_ERRORCODES_page "Error Codes") or zero if successful. </returns>
	/// <seealso cref="BMC_GetJogMode(char const * serialNo, short channel, MOT_JogModes * mode, MOT_StopModes * stopMode)" />
	/// <seealso cref="BMC_SetJogMode(char const * serialNo, short channel, MOT_JogModes mode, MOT_StopModes stopMode)" />
	/// <seealso cref="BMC_GetJogStepSize(char const * serialNo, short channel)" />
	/// <seealso cref="BMC_SetJogStepSize(char const * serialNo, short channel, unsigned int stepSize)" />
	/// <seealso cref="BMC_GetJogVelParams(char const * serialNo, short channel, int * acceleration, int * maxVelocity)" />
	/// <seealso cref="BMC_GetJogParamsBlock(char const * serialNo, short channel, MOT_JogParameters *jogParams)" />
	/// <seealso cref="BMC_SetJogParamsBlock(char const * serialNo, short channel, MOT_JogParameters *jogParams)" />
	/// <seealso cref="BMC_MoveJog(char const * serialNo, short channel, MOT_TravelDirection jogDirection)" />
	/// 		  \include CodeSnippet_jogpars.cpp
	BRUSHLESSMOTOR_API short __cdecl BMC_SetJogVelParams(char const * serialNo, short channel, int acceleration, int maxVelocity);

	/// <summary> Perform a jog. </summary>
	/// <remarks> see \ref C_MOTOR_sec12 "Jogging" for more detail.<remarks>
	/// <param name="serialNo">	The controller serial no. </param>
	/// <param name="channel"> The channel (1 to n). </param>
	/// <param name="jogDirection"> The jog direction
	/// 					 <list type=table>
	///							<item><term>Forwards</term><term>1</term></item>
	///							<item><term>Backwards</term><term>2</term></item>
	/// 					 </list> </param>
	/// <returns> The error code (see \ref C_DLL_ERRORCODES_page "Error Codes") or zero if successful. </returns>
	/// <seealso cref="BMC_GetJogMode(char const * serialNo, short channel, MOT_JogModes * mode, MOT_StopModes * stopMode)" />
	/// <seealso cref="BMC_SetJogMode(char const * serialNo, short channel, MOT_JogModes mode, MOT_StopModes stopMode)" />
	/// <seealso cref="BMC_GetJogStepSize(char const * serialNo, short channel)" />
	/// <seealso cref="BMC_SetJogStepSize(char const * serialNo, short channel, unsigned int stepSize)" />
	/// <seealso cref="BMC_SetJogVelParams(char const * serialNo, short channel, int acceleration, int maxVelocity)" />
	/// <seealso cref="BMC_GetJogVelParams(char const * serialNo, short channel, int * acceleration, int * maxVelocity)" />
	/// <seealso cref="BMC_GetJogParamsBlock(char const * serialNo, short channel, MOT_JogParameters *jogParams)" />
	/// <seealso cref="BMC_SetJogParamsBlock(char const * serialNo, short channel, MOT_JogParameters *jogParams)" />
	/// 		  \include CodeSnippet_jog.cpp
	BRUSHLESSMOTOR_API short __cdecl BMC_MoveJog(char const * serialNo, short channel, MOT_TravelDirection jogDirection);

	/// <summary> Requests the velocity parameters. </summary>
	/// <remarks> see \ref C_MOTOR_sec11 "Positioning" for more detail.<remarks>
	/// <param name="serialNo"> The controller serial no. </param>
	/// <param name="channel"> The channel (1 to n). </param>
	/// <returns> The error code (see \ref C_DLL_ERRORCODES_page "Error Codes") or zero if successful. </returns>
	/// <seealso cref="BMC_GetVelParams(char const * serialNo, short channel, int * acceleration, int * maxVelocity)" />
	/// <seealso cref="BMC_GetVelParamsBlock(char const * serialNo, short channel, MOT_VelocityParameters  *velocityParams)" />
	BRUSHLESSMOTOR_API short __cdecl BMC_RequestVelParams(char const * serialNo, short channel);

	/// <summary> Gets the move velocity parameters. </summary>
	/// <remarks> see \ref C_MOTOR_sec11 "Positioning" for more detail.<remarks>
	/// <param name="serialNo">	The controller serial no. </param>
	/// <param name="channel"> The channel (1 to n). </param>
	/// <param name="acceleration"> Address of the parameter to receive the acceleration value in \ref DeviceUnits_page. </param>
	/// <param name="maxVelocity"> Address of the parameter to receive the maximum velocity value in \ref DeviceUnits_page. </param>
	/// <returns> The error code (see \ref C_DLL_ERRORCODES_page "Error Codes") or zero if successful. </returns>
	/// <seealso cref="BMC_RequestVelParams(char const * serialNo, short channel)" />
	/// <seealso cref="BMC_SetVelParams(char const * serialNo, short channel, int acceleration, int maxVelocity)" />
	/// <seealso cref="BMC_GetVelParamsBlock(char const * serialNo, short channel, MOT_VelocityParameters  *velocityParams)" />
	/// <seealso cref="BMC_SetVelParamsBlock(char const * serialNo, short channel, MOT_VelocityParameters *velocityParams)" />
	/// <seealso cref="BMC_MoveToPosition(char const * serialNo, short channel, int index)" />
	/// <seealso cref="BMC_MoveRelative(char const * serialNo, short channel, int displacement)" />
	/// <seealso cref="BMC_MoveAtVelocity(char const * serialNo, short channel, MOT_TravelDirection direction)" />
	/// 		  \include CodeSnippet_movepars.cpp
	BRUSHLESSMOTOR_API short __cdecl BMC_GetVelParams(char const * serialNo, short channel, int * acceleration, int * maxVelocity);

	/// <summary> Sets the move velocity parameters. </summary>
	/// <remarks> see \ref C_MOTOR_sec11 "Positioning" for more detail.<remarks>
	/// <param name="serialNo">	The controller serial no. </param>
	/// <param name="channel"> The channel (1 to n). </param>
	/// <param name="acceleration"> The new acceleration value in \ref DeviceUnits_page. </param>
	/// <param name="maxVelocity"> The new maximum velocity value in \ref DeviceUnits_page. </param>
	/// <returns> The error code (see \ref C_DLL_ERRORCODES_page "Error Codes") or zero if successful. </returns>
	/// <seealso cref="BMC_GetVelParams(char const * serialNo, short channel, int * acceleration, int * maxVelocity)" />
	/// <seealso cref="BMC_GetVelParamsBlock(char const * serialNo, short channel, MOT_VelocityParameters  *velocityParams)" />
	/// <seealso cref="BMC_SetVelParamsBlock(char const * serialNo, short channel, MOT_VelocityParameters *velocityParams)" />
	/// <seealso cref="BMC_MoveToPosition(char const * serialNo, short channel, int index)" />
	/// <seealso cref="BMC_MoveRelative(char const * serialNo, short channel, int displacement)" />
	/// <seealso cref="BMC_MoveAtVelocity(char const * serialNo, short channel, MOT_TravelDirection direction)" />
	/// 		  \include CodeSnippet_movepars.cpp
	BRUSHLESSMOTOR_API short __cdecl BMC_SetVelParams(char const * serialNo, short channel, int acceleration, int maxVelocity);

	/// <summary> Move the device to the specified position (index). </summary>
	/// <remarks> The motor may need to be \ref C_MOTOR_sec10 "Homed" before a position can be set<br />
	/// 		  see \ref C_MOTOR_sec11 "Positioning" for more detail. </remarks>
	/// <param name="serialNo">	The controller serial no. </param>
	/// <param name="channel">  The channel (1 to n). </param>
	/// <param name="index">   	The position in \ref DeviceUnits_page. </param>
	/// <returns> The error code (see \ref C_DLL_ERRORCODES_page "Error Codes") or zero if move successfully started. </returns>
	/// <seealso cref="BMC_GetNumberPositions(char const * serialNo, short channel)" />
	/// <seealso cref="BMC_SetVelParams(char const * serialNo, short channel, int acceleration, int maxVelocity)" />
	/// <seealso cref="BMC_GetPosition(char const * serialNo, short channel)" />
	/// <seealso cref="BMC_GetVelParams(char const * serialNo, short channel, int * acceleration, int * maxVelocity)" />
	/// <seealso cref="BMC_GetVelParamsBlock(char const * serialNo, short channel, MOT_VelocityParameters  *velocityParams)" />
	/// <seealso cref="BMC_SetVelParamsBlock(char const * serialNo, short channel, MOT_VelocityParameters *velocityParams)" />
	/// <seealso cref="BMC_MoveRelative(char const * serialNo, short channel, int displacement)" />
	/// <seealso cref="BMC_MoveAtVelocity(char const * serialNo, short channel, MOT_TravelDirection direction)" />
	/// 		  \include CodeSnippet_move.cpp
	BRUSHLESSMOTOR_API short __cdecl BMC_MoveToPosition(char const * serialNo, short channel, int index);

	/// <summary> Move the motor by a relative amount. </summary>
	/// <param name="serialNo">	The controller serial no. </param>
	/// <param name="channel">  The channel (1 to n). </param>
	/// <param name="displacement"> Signed displacement in \ref DeviceUnits_page.</param>
	/// <returns> The error code (see \ref C_DLL_ERRORCODES_page "Error Codes") or zero if successful. </returns>
	/// <seealso cref="BMC_GetNumberPositions(char const * serialNo, short channel)" />
	/// <seealso cref="BMC_GetVelParams(char const * serialNo, short channel, int * acceleration, int * maxVelocity)" />
	/// <seealso cref="BMC_SetVelParams(char const * serialNo, short channel, int acceleration, int maxVelocity)" />
	/// <seealso cref="BMC_GetVelParamsBlock(char const * serialNo, short channel, MOT_VelocityParameters  *velocityParams)" />
	/// <seealso cref="BMC_SetVelParamsBlock(char const * serialNo, short channel, MOT_VelocityParameters *velocityParams)" />
	/// <seealso cref="BMC_MoveToPosition(char const * serialNo, short channel, int index)" />
	/// <seealso cref="BMC_MoveAtVelocity(char const * serialNo, short channel, MOT_TravelDirection direction)" />
	/// 		  \include CodeSnippet_move.cpp
	BRUSHLESSMOTOR_API short __cdecl BMC_MoveRelative(char const * serialNo, short channel, int displacement);

	/// <summary> Start moving at the current velocity in the specified direction. </summary>
	/// <remarks> see \ref C_MOTOR_sec11 "Positioning" for more detail.<remarks>
	/// <param name="serialNo">	The controller serial no. </param>
	/// <param name="channel"> The channel (1 to n). </param>
	/// <param name="direction"> The required direction of travel.
	/// 					 <list type=table>
	///							<item><term>Forwards</term><term>1</term></item>
	///							<item><term>Backwards</term><term>2</term></item>
	/// 					 </list> </param>
	/// <returns> The error code (see \ref C_DLL_ERRORCODES_page "Error Codes") or zero if successful. </returns>
	/// <seealso cref="BMC_GetVelParams(char const * serialNo, short channel, int * acceleration, int * maxVelocity)" />
	/// <seealso cref="BMC_SetVelParams(char const * serialNo, short channel, int acceleration, int maxVelocity)" />
	/// <seealso cref="BMC_GetVelParamsBlock(char const * serialNo, short channel, MOT_VelocityParameters  *velocityParams)" />
	/// <seealso cref="BMC_SetVelParamsBlock(char const * serialNo, short channel, MOT_VelocityParameters *velocityParams)" />
	/// <seealso cref="BMC_MoveToPosition(char const * serialNo, short channel, int index)" />
	/// <seealso cref="BMC_MoveRelative(char const * serialNo, short channel, int displacement)" />
	/// 		  \include CodeSnippet_move.cpp
	BRUSHLESSMOTOR_API short __cdecl BMC_MoveAtVelocity(char const * serialNo, short channel, MOT_TravelDirection direction);

	/// <summary> Sets the motor direction sense. </summary>
	/// <remarks> This function is used because some actuators use have directions of motion reversed.<br />
	/// 		  This parameter will tell the system to reverse the direction sense whnd moving, jogging etc. </remarks>
	/// <param name="serialNo">	The controller serial no. </param>
	/// <param name="channel">  The channel (1 to n). </param>
	/// <param name="reverse"> if  <c>true</c> then directions will be swapped on these moves. </param>
	BRUSHLESSMOTOR_API short __cdecl BMC_SetDirection(char const * serialNo, short channel, bool reverse);


	/// <summary> Stop the current move immediately (with risk of losing track of position). </summary>
	/// <param name="serialNo">	The controller serial no. </param>
	/// <param name="channel">  The channel (1 to n). </param>
	/// <returns> The error code (see \ref C_DLL_ERRORCODES_page "Error Codes") or zero if successful. </returns>
	/// <seealso cref="BMC_StopProfiled(char const * serialNo, short channel)" />
	BRUSHLESSMOTOR_API short __cdecl BMC_StopImmediate(char const * serialNo, short channel);

	/// <summary> Stop the current move using the current velocity profile. </summary>
	/// <param name="serialNo">	The controller serial no. </param>
	/// <param name="channel">  The channel (1 to n). </param>
	/// <returns> The error code (see \ref C_DLL_ERRORCODES_page "Error Codes") or zero if successful. </returns>
	/// <seealso cref="BMC_StopImmediate(char const * serialNo, short channel)" />
	BRUSHLESSMOTOR_API short __cdecl BMC_StopProfiled(char const * serialNo, short channel);

	/// <summary> Requests the backlash. </summary>
	/// <param name="serialNo"> The controller serial no. </param>
	/// <param name="channel"> The channel (1 to n). </param>
	/// <returns> The error code (see \ref C_DLL_ERRORCODES_page "Error Codes") or zero if successful. </returns>
	/// <seealso cref="BMC_GetBacklash(char const * serialNo, short channel)" />
	/// <seealso cref="BMC_SetBacklash(char const * serialNo, short channel, long distance)" />
	BRUSHLESSMOTOR_API short __cdecl BMC_RequestBacklash(char const * serialNo, short channel);

	/// <summary> Get the backlash distance setting (used to control hysteresis). </summary>
	/// <param name="serialNo"> The controller serial no. </param>
	/// <param name="channel"> The channel (1 to n). </param>
	/// <returns> The backlash distance in \ref DeviceUnits_page. </returns>
	/// <seealso cref="BMC_RequestBacklash(char const * serialNo, short channel)" />
	/// <seealso cref="BMC_SetBacklash(char const * serialNo, short channel, long distance)" />
	BRUSHLESSMOTOR_API long __cdecl BMC_GetBacklash(char const * serialNo, short channel);

	/// <summary> Sets the backlash distance (used to control hysteresis). </summary>
	/// <param name="serialNo">  The controller serial no. </param>
	/// <param name="channel"> The channel (1 to n). </param>
	/// <param name="distance"> The distance in \ref DeviceUnits_page. </param>
	/// <returns> The error code (see \ref C_DLL_ERRORCODES_page "Error Codes") or zero if successful. </returns>
	/// <seealso cref="BMC_RequestBacklash(char const * serialNo, short channel)" />
	/// <seealso cref="BMC_GetBacklash(char const * serialNo, short channel)" />
	BRUSHLESSMOTOR_API short __cdecl BMC_SetBacklash(char const * serialNo, short channel, long distance);

	/// <summary> Get the Position Counter. </summary>
	/// <remarks> The position counter is identical to the position parameter.<br />
	/// 		  The position counter is set to zero when homing is complete.<br />
	/// 		  The position counter can also be set using <see cref="BMC_SetPositionCounter(char const * serialNo, short channel, long count)" /> <br />
	/// 		  if homing is not to be perforned</remarks>
	/// <param name="serialNo">	The controller serial no. </param>
	/// <param name="channel">  The channel (1 to n). </param>
	/// <returns> Position count in \ref DeviceUnits_page. </returns>
	/// <seealso cref="BMC_GetPosition(char const * serialNo, short channel)" />
	/// <seealso cref="BMC_SetPositionCounter(char const * serialNo, short channel, long count)" />
	BRUSHLESSMOTOR_API long __cdecl BMC_GetPositionCounter(char const * serialNo, short channel);

	/// <summary> Set the Position Counter. </summary>
	/// <remarks> Setting the position counter will locate the current position. <br />
	/// 		  Setting the position counter will effectively define the home position of a motor. </remarks>
	/// <param name="serialNo">	The controller serial no. </param>
	/// <param name="channel">  The channel (1 to n). </param>
	/// <param name="count"> Position count in \ref DeviceUnits_page. </param>
	/// <returns> The error code (see \ref C_DLL_ERRORCODES_page "Error Codes") or zero if successful. </returns>
	/// <seealso cref="BMC_GetPositionCounter(char const * serialNo, short channel)" />
	/// <seealso cref="BMC_GetPosition(char const * serialNo, short channel)" />
	BRUSHLESSMOTOR_API short __cdecl BMC_SetPositionCounter(char const * serialNo, short channel, long count);

	/// <summary> Requests the encoder counter. </summary>
	/// <remarks> For devices that have an encoder, the current encoder position can be read. </remarks>
	/// <param name="serialNo"> The controller serial no. </param>
	/// <param name="channel"> The channel (1 to n). </param>
	/// <returns> The error code (see \ref C_DLL_ERRORCODES_page "Error Codes") or zero if successful. </returns>
	/// <seealso cref="BMC_GetEncoderCounter(char const * serialNo, short channel)" />
	/// <seealso cref="BMC_SetEncoderCounter(char const * serialNo, short channel, long count)" />
	BRUSHLESSMOTOR_API short __cdecl BMC_RequestEncoderCounter(char const * serialNo, short channel);

	/// <summary> Get the Encoder Counter. </summary>
	/// <remarks> For devices that have an encoder, the current encoder position can be read. </remarks>
	/// <param name="channel">  The channel (1 to n). </param>
	/// <param name="serialNo">	The controller serial no. </param>
	/// <returns> Encoder count of encoder units. </returns>
	/// <seealso cref="BMC_RequestEncoderCounter(char const * serialNo, short channel)" />
	/// <seealso cref="BMC_SetEncoderCounter(char const * serialNo, short channel, long count)" />
	BRUSHLESSMOTOR_API long __cdecl BMC_GetEncoderCounter(char const * serialNo, short channel);

	/// <summary> Set the Encoder Counter values. </summary>
	/// <remarks> setting the encoder counter to zero, effectively defines a home position on the encoder strip.<br />
	/// 		  NOTE, setting this value does not move the device.</remarks>
	/// <param name="serialNo">	The controller serial no. </param>
	/// <param name="channel"> The channel (1 to n). </param>
	/// <param name="count"> The encoder count in encoder units. </param>
	/// <returns> The error code (see \ref C_DLL_ERRORCODES_page "Error Codes") or zero if successful. </returns>
	/// <seealso cref="BMC_RequestEncoderCounter(char const * serialNo, short channel)" />
	/// <seealso cref="BMC_GetEncoderCounter(char const * serialNo, short channel)" />
	BRUSHLESSMOTOR_API short __cdecl BMC_SetEncoderCounter(char const * serialNo, short channel, long count);

	/// <summary> Get the move velocity parameters. </summary>
	/// <remarks> see \ref C_MOTOR_sec11 "Positioning" for more detail.<remarks>
	/// <param name="serialNo">	The controller serial no. </param>
	/// <param name="channel"> The channel (1 to n). </param>
	/// <param name="velocityParams"> Address of the MOT_VelocityParameters to recieve the velocity parameters. </param>
	/// <returns> The error code (see \ref C_DLL_ERRORCODES_page "Error Codes") or zero if successful. </returns>
	/// <seealso cref="BMC_RequestVelParams(char const * serialNo, short channel)" />
	/// <seealso cref="BMC_GetVelParams(char const * serialNo, short channel, int * acceleration, int * maxVelocity)" />
	/// <seealso cref="BMC_SetVelParams(char const * serialNo, short channel, int acceleration, int maxVelocity)" />
	/// <seealso cref="BMC_SetVelParamsBlock(char const * serialNo, short channel, MOT_VelocityParameters *velocityParams)" />
	/// <seealso cref="BMC_MoveToPosition(char const * serialNo, short channel, int index)" />
	/// <seealso cref="BMC_MoveRelative(char const * serialNo, short channel, int displacement)" />
	/// <seealso cref="BMC_MoveAtVelocity(char const * serialNo, short channel, MOT_TravelDirection direction)" />
	/// 		  \include CodeSnippet_movepars.cpp
	BRUSHLESSMOTOR_API short __cdecl BMC_GetVelParamsBlock(char const * serialNo, short channel, MOT_VelocityParameters  *velocityParams);

	/// <summary> Set the move velocity parameters. </summary>
	/// <remarks> see \ref C_MOTOR_sec11 "Positioning" for more detail.<remarks>
	/// <param name="serialNo">	The controller serial no. </param>
	/// <param name="channel"> The channel (1 to n). </param>
	/// <param name="velocityParams"> The address of the MOT_VelocityParameters holding the new velocity parameters. </param>
	/// <returns> The error code (see \ref C_DLL_ERRORCODES_page "Error Codes") or zero if successful. </returns>
	/// <seealso cref="BMC_GetVelParams(char const * serialNo, short channel, int * acceleration, int * maxVelocity)" />
	/// <seealso cref="BMC_SetVelParams(char const * serialNo, short channel, int acceleration, int maxVelocity)" />
	/// <seealso cref="BMC_GetVelParamsBlock(char const * serialNo, short channel, MOT_VelocityParameters  *velocityParams)" />
	/// <seealso cref="BMC_MoveToPosition(char const * serialNo, short channel, int index)" />
	/// <seealso cref="BMC_MoveRelative(char const * serialNo, short channel, int displacement)" />
	/// <seealso cref="BMC_MoveAtVelocity(char const * serialNo, short channel, MOT_TravelDirection direction)" />
	/// 		  \include CodeSnippet_movepars.cpp
	BRUSHLESSMOTOR_API short __cdecl BMC_SetVelParamsBlock(char const * serialNo, short channel, MOT_VelocityParameters *velocityParams);

	/// <summary> Sets the move absolute position. </summary>
	/// <param name="serialNo">	The controller serial no. </param>
	/// <param name="channel"> The channel (1 to n). </param>
	/// <param name="position"> The absolute position in \ref DeviceUnits_page. </param>
	/// <returns> The error code (see \ref C_DLL_ERRORCODES_page "Error Codes") or zero if successful. </returns>
	/// <seealso cref="BMC_RequestMoveAbsolutePosition(char const * serialNo, short channel)" />
	/// <seealso cref="BMC_GetMoveAbsolutePosition(const char * serialNo, short channel)" />
	/// <seealso cref="BMC_MoveAbsolute(const char * serialNo, short channel)" />
	BRUSHLESSMOTOR_API short __cdecl BMC_SetMoveAbsolutePosition(const char * serialNo, short channel, int position);

	/// <summary> Requests the position of next absolute move. </summary>
	/// <param name="serialNo"> The controller serial no. </param>
	/// <param name="channel"> The channel (1 to n). </param>
	/// <returns> The error code (see \ref C_DLL_ERRORCODES_page "Error Codes") or zero if successful. </returns>
	/// <seealso cref="BMC_GetMoveAbsolutePosition(char const * serialNo, short channel)" />
	/// <seealso cref="BMC_SetMoveAbsolutePosition(char const * serialNo, short channel, int position)" />
	/// <seealso cref="BMC_MoveAbsolute(char const * serialNo, short channel)" />
	BRUSHLESSMOTOR_API short __cdecl BMC_RequestMoveAbsolutePosition(char const * serialNo, short channel);

	/// <summary> Gets the move absolute position. </summary>
	/// <param name="serialNo">	The controller serial no. </param>
	/// <param name="channel"> The channel (1 to n). </param>
	/// <returns> The move absolute position in \ref DeviceUnits_page. </returns>
	/// <seealso cref="BMC_RequestMoveAbsolutePosition(char const * serialNo, short channel)" />
	/// <seealso cref="BMC_SetMoveAbsolutePosition(const char * serialNo, short channel, int position)" />
	/// <seealso cref="BMC_MoveAbsolute(const char * serialNo, short channel)" />
	BRUSHLESSMOTOR_API int __cdecl BMC_GetMoveAbsolutePosition(const char * serialNo, short channel);

	/// <summary> Moves the device to the position defined in the SetMoveAbsolute command. </summary>
	/// <param name="serialNo">	The controller serial no. </param>
	/// <param name="channel"> The channel (1 to n). </param>
	/// <returns> The error code (see \ref C_DLL_ERRORCODES_page "Error Codes") or zero if successful. </returns>
	/// <seealso cref="BMC_SetMoveAbsolutePosition(const char * serialNo, short channel, int position)" />
	/// <seealso cref="BMC_RequestMoveAbsolutePosition(char const * serialNo, short channel)" />
	/// <seealso cref="BMC_GetMoveAbsolutePosition(const char * serialNo, short channel)" />
	BRUSHLESSMOTOR_API short __cdecl BMC_MoveAbsolute(const char * serialNo, short channel);

	/// <summary> Sets the move relative distance. </summary>
	/// <param name="serialNo">	The controller serial no. </param>
	/// <param name="channel"> The channel (1 to n). </param>
	/// <param name="distance"> The relative distance in \ref DeviceUnits_page. </param>
	/// <returns> The error code (see \ref C_DLL_ERRORCODES_page "Error Codes") or zero if successful. </returns>
	/// <seealso cref="BMC_RequestMoveRelativeDistance(char const * serialNo, short channel)" />
	/// <seealso cref="BMC_GetMoveRelativeDistance(const char * serialNo, short channel)" />
	/// <seealso cref="BMC_MoveRelativeDistance(const char * serialNo, short channel)" />
	BRUSHLESSMOTOR_API short __cdecl BMC_SetMoveRelativeDistance(const char * serialNo, short channel, int distance);

	/// <summary> Requests the relative move distance. </summary>
	/// <param name="serialNo"> The controller serial no. </param>
	/// <param name="channel"> The channel (1 to n). </param>
	/// <returns> The error code (see \ref C_DLL_ERRORCODES_page "Error Codes") or zero if successful. </returns>
	/// <seealso cref="BMC_GetMoveRelativeDistance(char const * serialNo, short channel)" />
	/// <seealso cref="BMC_SetMoveRelativeDistance(char const * serialNo, short channel, int distance)" />
	/// <seealso cref="BMC_MoveRelativeDistance(char const * serialNo, short channel)" />
	BRUSHLESSMOTOR_API short __cdecl BMC_RequestMoveRelativeDistance(char const * serialNo, short channel);

	/// <summary> Gets the move relative distance. </summary>
	/// <param name="serialNo">	The controller serial no. </param>
	/// <param name="channel"> The channel (1 to n). </param>
	/// <returns> The move relative distance in \ref DeviceUnits_page. </returns>
	/// <seealso cref="BMC_RequestMoveRelativeDistance(char const * serialNo, short channel)" />
	/// <seealso cref="BMC_SetMoveRelativeDistance(const char * serialNo, short channel, int distance)" />
	/// <seealso cref="BMC_MoveRelativeDistance(const char * serialNo, short channel)" />
	BRUSHLESSMOTOR_API int __cdecl BMC_GetMoveRelativeDistance(const char * serialNo, short channel);

	/// <summary> Moves the device by a relative distancce defined by SetMoveRelativeDistance. </summary>
	/// <param name="serialNo">	The controller serial no. </param>
	/// <param name="channel"> The channel (1 to n). </param>
	/// <returns> The error code (see \ref C_DLL_ERRORCODES_page "Error Codes") or zero if successful. </returns>
	/// <seealso cref="BMC_SetMoveRelativeDistance(const char * serialNo, short channel, int distance)" />
	/// <seealso cref="BMC_RequestMoveRelativeDistance(char const * serialNo, short channel)" />
	/// <seealso cref="BMC_GetMoveRelativeDistance(const char * serialNo, short channel)" />
	BRUSHLESSMOTOR_API short __cdecl BMC_MoveRelativeDistance(const char * serialNo, short channel);

	/// <summary> Get the homing parameters. </summary>
	/// <remarks> see \ref C_MOTOR_sec10 "Homing" for more detail.<remarks>
	/// <param name="serialNo"> The controller serial no. </param>
	/// <param name="channel"> The channel (1 to n). </param>
	/// <param name="homingParams"> Address of the MOT_HomingParameters to recieve the homing parameters. </param>
	/// <returns> The error code (see \ref C_DLL_ERRORCODES_page "Error Codes") or zero if successful. </returns>
	/// <seealso cref="BMC_RequestHomingParams(char const * serialNo, short channel)" />
	/// <seealso cref="BMC_GetHomingVelocity(char const * serialNo, short channel)" />
	/// <seealso cref="BMC_SetHomingVelocity(char const * serialNo, short channel, unsigned int velocity)" />
	/// <seealso cref="BMC_SetHomingParamsBlock(char const * serialNo, short channel, MOT_HomingParameters *homingParams)" />
	BRUSHLESSMOTOR_API short __cdecl BMC_GetHomingParamsBlock(char const * serialNo, short channel, MOT_HomingParameters *homingParams);

	/// <summary> Set the homing parameters. </summary>
	/// <remarks> see \ref C_MOTOR_sec10 "Homing" for more detail.<remarks>
	/// <param name="serialNo"> The controller serial no. </param>
	/// <param name="channel"> The channel (1 to n). </param>
	/// <param name="homingParams"> Address of the new homing parameters. </param>
	/// <returns> The error code (see \ref C_DLL_ERRORCODES_page "Error Codes") or zero if successful. </returns>
	/// <seealso cref="BMC_RequestHomingParams(char const * serialNo, short channel)" />
	/// <seealso cref="BMC_GetHomingVelocity(char const * serialNo, short channel)" />
	/// <seealso cref="BMC_SetHomingVelocity(char const * serialNo, short channel, unsigned int velocity)" />
	/// <seealso cref="BMC_GetHomingParamsBlock(char const * serialNo, short channel, MOT_HomingParameters *homingParams)" />
	BRUSHLESSMOTOR_API short __cdecl BMC_SetHomingParamsBlock(char const * serialNo, short channel, MOT_HomingParameters *homingParams);

	/// <summary> Get the jog parameters. </summary>
	/// <remarks> see \ref C_MOTOR_sec12 "Jogging" for more detail.<remarks>
	/// <param name="serialNo">  The controller serial no. </param>
	/// <param name="channel"> The channel (1 to n). </param>
	/// <param name="jogParams"> The address of the MOT_JogParameters block to recieve the jog parameters </param>
	/// <returns> The error code (see \ref C_DLL_ERRORCODES_page "Error Codes") or zero if successful. </returns>
	/// <seealso cref="BMC_RequestJogParams(char const * serialNo, short channel)" />
	/// <seealso cref="BMC_GetJogMode(char const * serialNo, short channel, MOT_JogModes * mode, MOT_StopModes * stopMode)" />
	/// <seealso cref="BMC_SetJogMode(char const * serialNo, short channel, MOT_JogModes mode, MOT_StopModes stopMode)" />
	/// <seealso cref="BMC_GetJogStepSize(char const * serialNo, short channel)" />
	/// <seealso cref="BMC_SetJogStepSize(char const * serialNo, short channel, unsigned int stepSize)" />
	/// <seealso cref="BMC_SetJogVelParams(char const * serialNo, short channel, int acceleration, int maxVelocity)" />
	/// <seealso cref="BMC_GetJogVelParams(char const * serialNo, short channel, int * acceleration, int * maxVelocity)" />
	/// <seealso cref="BMC_SetJogParamsBlock(char const * serialNo, short channel, MOT_JogParameters *jogParams)" />
	/// <seealso cref="BMC_MoveJog(char const * serialNo, short channel, MOT_TravelDirection jogDirection)" />
	/// 		  \include CodeSnippet_jogpars.cpp
	BRUSHLESSMOTOR_API short __cdecl BMC_GetJogParamsBlock(char const * serialNo, short channel, MOT_JogParameters *jogParams);

	/// <summary> Set the jog parameters. </summary>
	/// <remarks> see \ref C_MOTOR_sec12 "Jogging" for more detail.<remarks>
	/// <param name="serialNo"> The controller serial no. </param>
	/// <param name="channel"> The channel (1 to n). </param>
	/// <param name="jogParams"> The address of the new MOT_JogParameters block. </param>
	/// <returns> The error code (see \ref C_DLL_ERRORCODES_page "Error Codes") or zero if successful. </returns>
	/// <seealso cref="BMC_GetJogMode(char const * serialNo, short channel, MOT_JogModes * mode, MOT_StopModes * stopMode)" />
	/// <seealso cref="BMC_SetJogMode(char const * serialNo, short channel, MOT_JogModes mode, MOT_StopModes stopMode)" />
	/// <seealso cref="BMC_GetJogStepSize(char const * serialNo, short channel)" />
	/// <seealso cref="BMC_SetJogStepSize(char const * serialNo, short channel, unsigned int stepSize)" />
	/// <seealso cref="BMC_SetJogVelParams(char const * serialNo, short channel, int acceleration, int maxVelocity)" />
	/// <seealso cref="BMC_GetJogVelParams(char const * serialNo, short channel, int * acceleration, int * maxVelocity)" />
	/// <seealso cref="BMC_GetJogParamsBlock(char const * serialNo, short channel, MOT_JogParameters *jogParams)" />
	/// <seealso cref="BMC_MoveJog(char const * serialNo, short channel, MOT_TravelDirection jogDirection)" />
	/// 		  \include CodeSnippet_jogpars.cpp
	BRUSHLESSMOTOR_API short __cdecl BMC_SetJogParamsBlock(char const * serialNo, short channel, MOT_JogParameters *jogParams);

	// Advanced Motion Functions

	/// <summary> Requests the velocity profile parameters. </summary>
	/// <param name="serialNo"> The controller serial no. </param>
	/// <param name="channel">  The channel (1 to n). </param>
	/// <returns> The error code (see \ref C_DLL_ERRORCODES_page "Error Codes") or zero if successful. </returns>
	/// <seealso cref="BMC_GetVelocityProfileParams(char const * serialNo, short channel, MOT_VelocityProfileParameters *velocityProfileParams)" />
	/// <seealso cref="BMC_SetVelocityProfileParams(char const * serialNo, short channel, MOT_VelocityProfileParameters *velocityProfileParams)" />
	BRUSHLESSMOTOR_API short __cdecl BMC_RequestVelocityProfileParams(char const * serialNo, short channel);

	/// <summary> Gets the velocity profile parameters. </summary>
	/// <param name="serialNo"> The controller serial no. </param>
	/// <param name="channel">  The channel (1 to n). </param>
	/// <param name="velocityProfileParams"> The address of the MOT_VelocityProfileParameters parameter to receive the velocity profile options. </param>
	/// <returns> The error code (see \ref C_DLL_ERRORCODES_page "Error Codes") or zero if successful. </returns>
	/// <seealso cref="BMC_RequestVelocityProfileParams(char const * serialNo, short channel)" />
	/// <seealso cref="BMC_SetVelocityProfileParams(char const * serialNo, short channel, MOT_VelocityProfileParameters *velocityProfileParams)" />
	BRUSHLESSMOTOR_API short __cdecl BMC_GetVelocityProfileParams(char const * serialNo, short channel, MOT_VelocityProfileParameters *velocityProfileParams);

	/// <summary> Sets the velocity profile parameters. </summary>
	/// <param name="serialNo"> The controller serial no. </param>
	/// <param name="channel">  The channel (1 to n). </param>
	/// <param name="velocityProfileParams"> The address of the MOT_VelocityProfileParameters containing the new velocity profile options. </param>
	/// <returns> The error code (see \ref C_DLL_ERRORCODES_page "Error Codes") or zero if successful. </returns>
	/// <seealso cref="BMC_RequestVelocityProfileParams(char const * serialNo, short channel)" />
	/// <seealso cref="BMC_GetVelocityProfileParams(char const * serialNo, short channel, MOT_VelocityProfileParameters *velocityProfileParams)" />
	BRUSHLESSMOTOR_API short __cdecl BMC_SetVelocityProfileParams(char const * serialNo, short channel, MOT_VelocityProfileParameters *velocityProfileParams);

	/// <summary> Requests the stage axis parameters. </summary>
	/// <param name="serialNo"> The controller serial no. </param>
	/// <param name="channel">  The channel (1 to n). </param>
	/// <returns> The error code (see \ref C_DLL_ERRORCODES_page "Error Codes") or zero if successful. </returns>
	/// <seealso cref="BMC_GetStageAxisParams(char const * serialNo, short channel, WORD *stageID, WORD *axisID, char * partNumber, DWORD size, DWORD *serialNumber, DWORD *countsPerUnit, int *minPosition, int *maxPosition, int *maxAcceleration, int *maxDecceleration, int *maxVelocity)" />
	/// <seealso cref="BMC_GetStageAxisMinPos(char const * serialNo, short channel)" />
	/// <seealso cref="BMC_GetStageAxisMaxPos(char const * serialNo, short channel)" />
	/// <seealso cref="BMC_GetStageAxisParamsBlock(char const * serialNo, short channel, MOT_StageAxisParameters *stageAxisParams)" />
	BRUSHLESSMOTOR_API short __cdecl BMC_RequestStageAxisParams(char const * serialNo, short channel);

	/// <summary> Gets the Brushless Motor stage axis parameters. </summary>
	/// <param name="serialNo"> The controller serial no. </param>
	/// <param name="channel">  The channel (1 to n). </param>
	/// <param name="stageAxisParams"> The address of the MOT_StageAxisParameters to receive the velocity stage axis parameters. </param>
	/// <returns> The error code (see \ref C_DLL_ERRORCODES_page "Error Codes") or zero if successful. </returns>
	/// <seealso cref="BMC_RequestStageAxisParams(char const * serialNo, short channel)" />
	/// <seealso cref="BMC_GetStageAxisParams(char const * serialNo, short channel, WORD *stageID, WORD *axisID, char * partNumber, DWORD size, DWORD *serialNumber, DWORD *countsPerUnit, int *minPosition, int *maxPosition, int *maxAcceleration, int *maxDecceleration, int *maxVelocity)" />
	/// <seealso cref="BMC_GetStageAxisMinPos(char const * serialNo, short channel)" />
	/// <seealso cref="BMC_GetStageAxisMaxPos(char const * serialNo, short channel)" />
	BRUSHLESSMOTOR_API short __cdecl BMC_GetStageAxisParamsBlock(char const * serialNo, short channel, MOT_StageAxisParameters *stageAxisParams);

	/// <summary> Gets the Brushless Motor stage axis parameters. </summary>
	/// <param name="serialNo">			 The controller serial no. </param>
	/// <param name="channel">			 The channel (1 to n). </param>
	/// <param name="stageID">			 Address of the parameter to recieve the stage ID. </param>
	/// <param name="axisID">			 Address of the parameter to recieve the axis ID. </param>
	/// <param name="partNumber">		 Address of the parameter to recieve the part number. </param>
	/// <param name="size">				 Address of the parameter to recieve the size of part number string. </param>
	/// <param name="serialNumber">	 Address of the parameter to recieve the serial number. </param>
	/// <param name="countsPerUnit">    Address of the parameter to recieve the encoder counts per mm or degree. </param>
	/// <param name="minPosition">			 Address of the parameter to recieve the minimum position in encoder counts. </param>
	/// <param name="maxPosition">			 Address of the parameter to recieve the maximum position in encoder counts. </param>
	/// <param name="maxAcceleration">  Address of the parameter to recieve the maximum acceleration in encoder counts per cycle per cycle. </param>
	/// <param name="maxDecceleration"> Address of the parameter to recieve the maximum decceleration in encoder counts per cycle per cycle. </param>
	/// <param name="maxVelocity">		 Address of the parameter to recieve the maximum velocity in encoder counts per cycle. </param>
	/// <returns> The error code (see \ref C_DLL_ERRORCODES_page "Error Codes") or zero if successful. </returns>
	/// <seealso cref="BMC_RequestStageAxisParams(char const * serialNo, short channel)" />
	/// <seealso cref="BMC_GetStageAxisParamsBlock(char const * serialNo, short channel, MOT_StageAxisParameters *stageAxisParams)" />
	/// <seealso cref="BMC_GetStageAxisMinPos(char const * serialNo, short channel)" />
	/// <seealso cref="BMC_GetStageAxisMaxPos(char const * serialNo, short channel)" />
	BRUSHLESSMOTOR_API short __cdecl BMC_GetStageAxisParams(char const * serialNo, short channel, WORD *stageID, WORD *axisID, char * partNumber, DWORD size, DWORD *serialNumber,
		DWORD *countsPerUnit, int *minPosition, int *maxPosition, int *maxAcceleration, int *maxDecceleration, int *maxVelocity);

	/// <summary> Gets the Brushless Motor stage axis minimum position. </summary>
	/// <param name="serialNo">	The controller serial no. </param>
	/// <param name="channel">  The channel (1 to n). </param>
	/// <returns> The Minimum position in \ref DeviceUnits_page. </returns>
	/// <seealso cref="BMC_RequestStageAxisParams(char const * serialNo, short channel)" />
	/// <seealso cref="BMC_GetStageAxisParamsBlock(char const * serialNo, short channel, MOT_StageAxisParameters *stageAxisParams)" />
	/// <seealso cref="BMC_GetStageAxisParams(char const * serialNo, short channel, WORD *stageID, WORD *axisID, char * partNumber, DWORD size, DWORD *serialNumber, DWORD *countsPerUnit, int *minPosition, int *maxPosition, int *maxAcceleration, int *maxDecceleration, int *maxVelocity)" />
	/// <seealso cref="BMC_GetStageAxisMaxPos(char const * serialNo, short channel)" />
	/// <seealso cref="BMC_SetStageAxisLimits(char const * serialNo, short channel, int minPosition, int maxPosition)" />
	BRUSHLESSMOTOR_API int __cdecl BMC_GetStageAxisMinPos(char const * serialNo, short channel);

	/// <summary> Gets the Brushless Motor stage axis maximum position. </summary>
	/// <param name="serialNo">	The controller serial no. </param>
	/// <param name="channel">  The channel (1 to n). </param>
	/// <returns> The Maximum position in \ref DeviceUnits_page. </returns>
	/// <seealso cref="BMC_RequestStageAxisParams(char const * serialNo, short channel)" />
	/// <seealso cref="BMC_GetStageAxisParamsBlock(char const * serialNo, short channel, MOT_StageAxisParameters *stageAxisParams)" />
	/// <seealso cref="BMC_GetStageAxisParams(char const * serialNo, short channel, WORD *stageID, WORD *axisID, char * partNumber, DWORD size, DWORD *serialNumber, DWORD *countsPerUnit, int *minPosition, int *maxPosition, int *maxAcceleration, int *maxDecceleration, int *maxVelocity)" />
	/// <seealso cref="BMC_GetStageAxisMinPos(char const * serialNo, short channel)" />
	/// <seealso cref="BMC_SetStageAxisLimits(char const * serialNo, short channel, int minPosition, int maxPosition)" />
	BRUSHLESSMOTOR_API int __cdecl BMC_GetStageAxisMaxPos(char const * serialNo, short channel);

	/// <summary> Overrides the stage axis position limits. </summary>
	/// <param name="serialNo">	The controller serial no. </param>
	/// <param name="channel">  The channel (1 to n). </param>
	/// <param name="minPosition"> Minimum position in \ref DeviceUnits_page. </param>
	/// <param name="maxPosition"> Maximum position in \ref DeviceUnits_page. </param>
	/// <returns> The error code (see \ref C_DLL_ERRORCODES_page "Error Codes") or zero if successful. </returns>
	/// <seealso cref="BMC_GetStageAxisMinPos(char const * serialNo, short channel)" />
	/// <seealso cref="BMC_GetStageAxisMaxPos(char const * serialNo, short channel)" />
	BRUSHLESSMOTOR_API short __cdecl BMC_SetStageAxisLimits(char const * serialNo, short channel, int minPosition, int maxPosition);

	/// <summary> Gets the software limits mode. </summary>
	/// <param name="serialNo">	The controller serial no. </param>
	/// <param name="channel"> The channel (1 to n). </param>
	/// <returns>	The software limits mode <list type=table>
	///							<item><term> Disable any move outside travel range. </term><term>0</term></item>
	///							<item><term> Disable any move outside travel range, but allow moves 'just beyond limit' to be truncated to limit. </term><term>1</term></item>
	///							<item><term> Truncate all moves beyond limit to the current limit. </term><term>2</term></item>
	///							<item><term> Allow all moves, illegal or not. </term><term>3</term></item>
	/// 		  </list>. </returns>
	/// <returns> The software limits mode. </returns>
	/// <seealso cref="BMC_SetLimitsSoftwareApproachPolicy(const char * serialNo, MOT_LimitsSoftwareApproachPolicy limitsSoftwareApproachPolicy)" />
	BRUSHLESSMOTOR_API MOT_LimitsSoftwareApproachPolicy __cdecl BMC_GetSoftLimitMode(char const * serialNo, short channel);

	/// <summary> Sets the software limits mode. </summary>
	/// <param name="serialNo">	The controller serial no. </param>
	/// <param name="channel"> The channel (1 to n). </param>
	/// <param name="limitsSoftwareApproachPolicy"> The soft limit mode
	/// 					 <list type=table>
	///							<item><term> Disable any move outside travel range. </term><term>0</term></item>
	///							<item><term> Disable any move outside travel range, but allow moves 'just beyond limit' to be truncated to limit. </term><term>1</term></item>
	///							<item><term> Truncate all moves beyond limit to the current limit. </term><term>2</term></item>
	///							<item><term> Allow all moves, illegal or not. </term><term>3</term></item>
	/// 					 </list> <remarks> If these are bitwise-ORed with 0x0080 then the limits are swapped. </remarks> </param>
	/// <seealso cref="BMC_GetSoftLimitMode(const char * serialNo)" />
	BRUSHLESSMOTOR_API void __cdecl BMC_SetLimitsSoftwareApproachPolicy(char const * serialNo, short channel, MOT_LimitsSoftwareApproachPolicy limitsSoftwareApproachPolicy);

	/// <summary> Set the motor travel mode. </summary>
	/// <param name="serialNo"> The controller serial no. </param>
	/// <param name="channel">    The channel (1 to n). </param>
	/// <param name="travelMode"> The travel mode.
	/// 			<list type=table>
	///					<item><term>Linear</term><term>1</term></item>
	///					<item><term>Rotational</term><term>2</term></item>
	/// 			</list> </param>
	/// <returns> The error code (see \ref C_DLL_ERRORCODES_page "Error Codes") or zero if successful. </returns>
	/// <seealso cref="BMC_GetMotorTravelMode(char const * serialNo, short channel)" />
	BRUSHLESSMOTOR_API short __cdecl BMC_SetMotorTravelMode(char const * serialNo, short channel, MOT_TravelModes travelMode);

	/// <summary> Get motor travel mode. </summary>
	/// <param name="serialNo"> The controller serial no. </param>
	/// <param name="channel">  The channel (1 to n). </param>
	/// <returns> The travel mode.
	/// 			<list type=table>
	///					<item><term>Linear</term><term>1</term></item>
	///					<item><term>Rotational</term><term>2</term></item>
	/// 			</list> </returns>
	/// <seealso cref="BMC_SetMotorTravelMode(char const * serialNo, short channel, int travelMode)" />
	BRUSHLESSMOTOR_API MOT_TravelModes __cdecl BMC_GetMotorTravelMode(char const * serialNo, short channel);

	/// <summary> Set the motor parameters for the Brushless Votor. </summary>
	/// <remarks> @deprecated superceded by <see cref="BMC_SetMotorParamsExt(char const * serialNo, short channel, long countsPerUnit)"/> </remarks>
	/// <param name="serialNo">		 The controller serial no. </param>
	/// <param name="channel">		 The channel (1 to n). </param>
	/// <param name="countsPerUnit"> The counts per unit.<br/>
	/// 							 The counts per unit is the conversion factor that converts \ref DeviceUnits_page to real units.<br />
	/// 							 For example with a counts per unit of 1000, 1 device unit = 0.0001mm. </param>
	/// <returns> The error code (see \ref C_DLL_ERRORCODES_page "Error Codes") or zero if successful. </returns>
	/// <seealso cref="BMC_GetMotorParams(char const * serialNo, short channel, long *countsPerUnit)" />
	BRUSHLESSMOTOR_API short __cdecl BMC_SetMotorParams(char const * serialNo, short channel, long countsPerUnit);

	/// <summary> Get the motor parameters for the Brushless Votor. </summary>
	/// <remarks> @deprecated superceded by <see cref="BMC_GetMotorParamsExt(char const * serialNo, double *countsPerUnit)"/> </remarks>
	/// <param name="serialNo">		 The controller serial no. </param>
	/// <param name="channel">		 The channel (1 to n). </param>
	/// <param name="countsPerUnit"> The Address of the parameter to receive the counts per unit value.<br/>
	/// 							 The counts per unit is the conversion factor that converts \ref DeviceUnits_page to real units.<br />
	/// 							 For example with a counts per unit of 1000, 1 device unit = 0.0001mm. </param>
	/// <returns> The error code (see \ref C_DLL_ERRORCODES_page "Error Codes") or zero if successful. </returns>
	/// <seealso cref="BMC_SetMotorParams(char const * serialNo, short channel, long countsPerUnit)" />
	BRUSHLESSMOTOR_API short __cdecl BMC_GetMotorParams(char const * serialNo, short channel, long *countsPerUnit);

	/// <summary> Set the motor parameters for the Brushless Votor. </summary>
	/// <param name="serialNo">		 The controller serial no. </param>
	/// <param name="channel">		 The channel (1 to n). </param>
	/// <param name="countsPerUnit"> The counts per unit.<br/>
	/// 							 The counts per unit is the conversion factor that converts \ref DeviceUnits_page to real units.<br />
	/// 							 For example with a counts per unit of 1000, 1 device unit = 0.0001mm. </param>
	/// <returns> The error code (see \ref C_DLL_ERRORCODES_page "Error Codes") or zero if successful. </returns>
	/// <seealso cref="BMC_GetMotorParamsExt(char const * serialNo, short channel, long *countsPerUnit)" />
	BRUSHLESSMOTOR_API short __cdecl BMC_SetMotorParamsExt(char const * serialNo, short channel, double countsPerUnit);

	/// <summary> Get the motor parameters for the Brushless Votor. </summary>
	/// <param name="serialNo">		 The controller serial no. </param>
	/// <param name="channel">		 The channel (1 to n). </param>
	/// <param name="countsPerUnit"> The Address of the parameter to receive the counts per unit value.<br/>
	/// 							 The counts per unit is the conversion factor that converts \ref DeviceUnits_page to real units.<br />
	/// 							 For example with a counts per unit of 1000, 1 device unit = 0.0001mm. </param>
	/// <returns> The error code (see \ref C_DLL_ERRORCODES_page "Error Codes") or zero if successful. </returns>
	/// <seealso cref="BMC_SetMotorParamsExt(char const * serialNo, short channel, long countsPerUnit)" />
	BRUSHLESSMOTOR_API short __cdecl BMC_GetMotorParamsExt(char const * serialNo, short channel, double *countsPerUnit);

	/// <summary> Sets the motor stage maximum velocity and acceleration. </summary>
	/// <param name="serialNo"> The device serial no. </param>
	/// <param name="channel">		 The channel. </param>
	/// <param name="maxVelocity">  The maximum velocity in real world units. </param>
	/// <param name="maxAcceleration"> The maximum acceleration in real world units. </param>
	/// <returns> The error code (see \ref C_DLL_ERRORCODES_page "Error Codes") or zero if successful. </returns>
	/// <seealso cref="BMC_GetMotorTravelLimits(char const * serialNo, short channel, double *minPosition, double *maxPosition)" />
	BRUSHLESSMOTOR_API short __cdecl BMC_SetMotorVelocityLimits(char const * serialNo, short channel, double maxVelocity, double maxAcceleration);

	/// <summary> Gets the motor stage maximum velocity and acceleration. </summary>
	/// <param name="serialNo"> The device serial no. </param>
	/// <param name="channel">		 The channel. </param>
	/// <param name="maxVelocity">  Address of the parameter to receive the maximum velocity in real world units. </param>
	/// <param name="maxAcceleration"> Address of the parameter to receive the maximum acceleration in real world units. </param>
	/// <returns> The error code (see \ref C_DLL_ERRORCODES_page "Error Codes") or zero if successful. </returns>
	/// <seealso cref="BMC_SetMotorTravelLimits(char const * serialNo, short channel, double minPosition, double maxPosition)" />
	BRUSHLESSMOTOR_API short __cdecl BMC_GetMotorVelocityLimits(char const * serialNo, short channel, double *maxVelocity, double *maxAcceleration);

	/// <summary>	Reset the rotation modes for a rotational device. </summary>
	/// <param name="serialNo"> The device serial no. </param>
	/// <param name="channel">		 The channel. </param>
	/// <returns> The error code (see \ref C_DLL_ERRORCODES_page "Error Codes") or zero if successful. </returns>
	/// <seealso cref="BMC_SetRotationModes(char const * serialNo, MOT_MovementModes mode, MOT_MovementDirections direction)" />
	BRUSHLESSMOTOR_API short __cdecl BMC_ResetRotationModes(char const * serialNo, short channel);

	/// <summary>	Set the rotation modes for a rotational device. </summary>
	/// <param name="serialNo"> The device serial no. </param>
	/// <param name="channel">		 The channel. </param>
	/// <param name="mode">	The rotation mode.<list type=table>
	///								<item><term>Linear Range (Fixed Limit, cannot rotate)</term><term>0</term></item>
	///								<item><term>RotationalUnlimited (Ranges between +/- Infinity)</term><term>1</term></item>
	///								<item><term>Rotational Wrapping (Ranges between 0 to 360 with wrapping)</term><term>2</term></item>
	/// 						  </list> </param>
	/// <param name="direction"> The rotation direction when moving between two angles.<list type=table>
	///								<item><term>Quickets (Always takes the shortedt path)</term><term>0</term></item>
	///								<item><term>Forwards (Always moves forwards)</term><term>1</term></item>
	///								<item><term>Backwards (Always moves backwards)</term><term>2</term></item>
	/// 						  </list> </param>
	/// <returns> The error code (see \ref C_DLL_ERRORCODES_page "Error Codes") or zero if successful. </returns>
	/// <seealso cref="BMC_ResetRotationModes(char const * serialNo)" />
	BRUSHLESSMOTOR_API short __cdecl BMC_SetRotationModes(char const * serialNo, short channel, MOT_MovementModes mode, MOT_MovementDirections direction);

	/// <summary> Sets the motor stage min and max position. </summary>
	/// <remarks> These define the range of travel for the stage.</remarks>
	/// <param name="serialNo"> The device serial no. </param>
	/// <param name="channel">		 The channel. </param>
	/// <param name="minPosition">  The minimum position in real world units. </param>
	/// <param name="maxPosition"> The maximum position in real world units. </param>
	/// <returns> The error code (see \ref C_DLL_ERRORCODES_page "Error Codes") or zero if successful. </returns>
	/// <seealso cref="BMC_GetMotorTravelLimits(char const * serialNo, short channel, double *minPosition, double *maxPosition)" />
	BRUSHLESSMOTOR_API short __cdecl BMC_SetMotorTravelLimits(char const * serialNo, short channel, double minPosition, double maxPosition);

	/// <summary> Gets the motor stage min and max position. </summary>
	/// <remarks> These define the range of travel for the stage.</remarks>
	/// <param name="serialNo"> The device serial no. </param>
	/// <param name="channel">		 The channel. </param>
	/// <param name="minPosition">  Address of the parameter to receive the minimum position in real world units. </param>
	/// <param name="maxPosition"> Address of the parameter to receive the maximum position in real world units. </param>
	/// <returns> The error code (see \ref C_DLL_ERRORCODES_page "Error Codes") or zero if successful. </returns>
	/// <seealso cref="BMC_SetMotorTravelLimits(char const * serialNo, short channel, double minPosition, double maxPosition)" />
	BRUSHLESSMOTOR_API short __cdecl BMC_GetMotorTravelLimits(char const * serialNo, short channel, double *minPosition, double *maxPosition);

	/// <summary>	Converts a devic unit to a real worl unit. </summary>
	/// <param name="serialNo">   	The serial no. </param>
	/// <param name="channel">		 The channel. </param>
	/// <param name="device_unit">	The device unit. </param>
	/// <param name="real_unit">  	The real unit. </param>
	/// <param name="unitType">   	Type of the unit.<list type=table>
	///								<item><term>Distance</term><term>0</term></item>
	///								<item><term>Velocity</term><term>1</term></item>
	///								<item><term>Acceleration</term><term>2</term></item>
	/// 						  </list> </param>
	/// <returns> The error code (see \ref C_DLL_ERRORCODES_page "Error Codes") or zero if successful. </returns>
	/// <seealso cref="BMC_GetDeviceUnitFromRealValue(char const * serialNo, short channel, double real_unit, int *device_unit, int unitType)" />
	BRUSHLESSMOTOR_API short __cdecl BMC_GetRealValueFromDeviceUnit(char const * serialNo, short channel, int device_unit, double *real_unit, int unitType);

	/// <summary>	Converts a devic unit to a real worl unit. </summary>
	/// <param name="serialNo">   	The serial no. </param>
	/// <param name="channel">		 The channel. </param>
	/// <param name="device_unit">	The device unit. </param>
	/// <param name="real_unit">  	The real unit. </param>
	/// <param name="unitType">   	Type of the unit.<list type=table>
	///								<item><term>Distance</term><term>0</term></item>
	///								<item><term>Velocity</term><term>1</term></item>
	///								<item><term>Acceleration</term><term>2</term></item>
	/// 						  </list> </param>
	/// <returns>	Success. </returns>
	/// <seealso cref="BMC_GetRealValueFromDeviceUnit(char const * serialNo, short channel, int device_unit, double *real_unit, int unitType)" />
	BRUSHLESSMOTOR_API short __cdecl BMC_GetDeviceUnitFromRealValue(char const * serialNo, short channel, double real_unit, int *device_unit, int unitType);

	/// <summary> Requests the joystick parameters. </summary>
	/// <param name="serialNo"> The controller serial no. </param>
	/// <param name="channel">  The channel (1 to n). </param>
	/// <returns> The error code (see \ref C_DLL_ERRORCODES_page "Error Codes") or zero if successful. </returns>
	/// <seealso cref="BMC_GetJoystickParams(char const * serialNo, short channel, MOT_JoystickParameters *JoystickParams)" />
	/// <seealso cref="BMC_SetJoystickParams(char const * serialNo, short channel, MOT_JoystickParameters *JoystickParams)" />
	BRUSHLESSMOTOR_API short __cdecl BMC_RequestJoystickParams(char const * serialNo, short channel);

	/// <summary> Gets the joystick parameters. </summary>
	/// <param name="serialNo"> The controller serial no. </param>
	/// <param name="channel">  The channel (1 to n). </param>
	/// <param name="joystickParams"> The address of the MOT_JoystickParameters parameter to receive the joystick parammeters. </param>
	/// <returns> The error code (see \ref C_DLL_ERRORCODES_page "Error Codes") or zero if successful. </returns>
	/// <seealso cref="BMC_RequestJoystickParams(char const * serialNo, short channel)" />
	/// <seealso cref="BMC_SetJoystickParams(char const * serialNo, short channel, MOT_JoystickParameters *joystickParams)" />
	BRUSHLESSMOTOR_API short __cdecl BMC_GetJoystickParams(char const * serialNo, short channel, MOT_JoystickParameters *joystickParams);

	/// <summary> Sets the joystick parameters. </summary>
	/// <param name="serialNo"> The controller serial no. </param>
	/// <param name="channel">  The channel (1 to n). </param>
	/// <param name="joystickParams"> The address of the MOT_JoystickParameters containing the new joystick options. </param>
	/// <returns> The error code (see \ref C_DLL_ERRORCODES_page "Error Codes") or zero if successful. </returns>
	/// <seealso cref="BMC_RequestJoystickParams(char const * serialNo, short channel)" />
	/// <seealso cref="BMC_GetJoystickParams(char const * serialNo, short channel, MOT_JoystickParameters *joystickParams)" />
	BRUSHLESSMOTOR_API short __cdecl BMC_SetJoystickParams(char const * serialNo, short channel, MOT_JoystickParameters *joystickParams);

	/// <summary> Requests the position feedback loop parameters. </summary>
	/// <param name="serialNo"> The controller serial no. </param>
	/// <param name="channel">  The channel (1 to n). </param>
	/// <returns> The error code (see \ref C_DLL_ERRORCODES_page "Error Codes") or zero if successful. </returns>
	/// <seealso cref="BMC_GetPosLoopParams(char const * serialNo, short channel, MOT_PosLoopParameters *PosLoopParams)" />
	/// <seealso cref="BMC_SetPosLoopParams(char const * serialNo, short channel, MOT_PosLoopParameters *PosLoopParams)" />
	BRUSHLESSMOTOR_API short __cdecl BMC_RequestPosLoopParams(char const * serialNo, short channel);

	/// <summary> Gets the position feedback loop parameters. </summary>
	/// <param name="serialNo"> The controller serial no. </param>
	/// <param name="channel">  The channel (1 to n). </param>
	/// <param name="positionLoopParams"> The address of the MOT_BrushlessPositionLoopParameters parameter to receive the  position feedback options. </param>
	/// <returns> The error code (see \ref C_DLL_ERRORCODES_page "Error Codes") or zero if successful. </returns>
	/// <seealso cref="BMC_RequestPosLoopParams(char const * serialNo, short channel)" />
	/// <seealso cref="BMC_SetPosLoopParams(char const * serialNo, short channel, MOT_BrushlessPositionLoopParameters *positionLoopParams)" />
	BRUSHLESSMOTOR_API short __cdecl BMC_GetPosLoopParams(char const * serialNo, short channel, MOT_BrushlessPositionLoopParameters *positionLoopParams);
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
