jiaruiyang123/SD-OCT/Software/Thorlabs.MotionControl.IntegratedStepperMotors.h

// summary:	Declares the functions class
// The following ifdef block is the standard way of creating macros which make exporting 
// from a DLL simpler. All files within this DLL are compiled with the ISC_EXPORTS
// symbol defined on the command line. This symbol should not be defined on any project
// that uses this DLL. This way any other project whose source files include this file see 
// ISC_API functions as being imported from a DLL, whereas this DLL sees symbols
// defined with this macro as being exported.

#pragma once

#ifdef ISCDLL_EXPORTS
#define ISC_API __declspec(dllexport)
#else
#define ISC_API __declspec(dllimport)
#endif

#include <OaIdl.h>

/** @defgroup IntegratedStepperMotors Integrated Stepper Motors
 *  This section details the Structures and Functions relavent to the  @ref ISC000_page "Integrated Stepper Motors"<br />
 *  For an example of how to connect to the device and perform simple operations use the following links:
 *  <list type=bullet>
 *    <item> \ref namespaces_mff_ex_1 "Example of using the Thorlabs.MotionControl.IntegratedStepperMotors.DLL from a C or C++ project."<br />
 *									  This requires the DLL to be dynamical linked. </item>
 *    <item> \ref namespaces_mff_ex_2 "Example of using the Thorlabs.MotionControl.IntegratedStepperMotors.DLL from a C# project"<br />
 *									  This uses Marshalling to load and access the C DLL. </item>
 *  </list>
 *  The Thorlabs.MotionControl.IntegratedStepperMotors.DLL requires the following DLLs
 *  <list type=bullet>
 *    <item> Thorlabs.MotionControl.DeviceManager. </item>
 *  </list>
 *  @{
 */

extern "C"
{
	/// \cond NOT_MASTER

	/// <summary> Values that represent FT_Status. </summary>
	typedef enum FT_Status : short
	{
		FT_OK = 0x00, /// <OK - no error.
		FT_InvalidHandle = 0x01, ///<Invalid handle.
		FT_DeviceNotFound = 0x02, ///<Device not found.
		FT_DeviceNotOpened = 0x03, ///<Device not opened.
		FT_IOError = 0x04, ///<I/O error.
		FT_InsufficientResources = 0x05, ///<Insufficient resources.
		FT_InvalidParameter = 0x06, ///<Invalid parameter.
		FT_DeviceNotPresent = 0x07, ///<Device not present.
		FT_IncorrectDevice = 0x08 ///<Incorrect device.
	 } FT_Status;

	/// <summary> Values that represent THORLABSDEVICE_API. </summary>
	typedef enum MOT_MotorTypes
	{
		MOT_NotMotor = 0,
		MOT_DCMotor = 1,
		MOT_StepperMotor = 2,
		MOT_BrushlessMotor = 3,
		MOT_CustomMotor = 100,
	} MOT_MotorTypes;

	/// <summary> Values that represent Travel Modes. </summary>
	typedef enum MOT_TravelModes : int
	{
		MOT_TravelModeUndefined,///<Undefined
		MOT_Linear = 0x01,///<Linear travel, default units are millimeters
		MOT_Rotational = 0x02,///<Rotational travel, default units are degrees
	} MOT_TravelModes;

	/// <summary> Values that represent Travel Modes. </summary>
	typedef enum MOT_TravelDirection : short
	{
		MOT_TravelDirectionUndefined,///<Undefined
		MOT_Forwards = 0x01,///<Move in a Forward direction
		MOT_Reverse = 0x02,///<Move in a Backward / Reverse direction
	} MOT_TravelDirection;

	/// <summary> Values that represent Limit Switch Directions. </summary>
	typedef enum MOT_HomeLimitSwitchDirection : short
	{
		MOT_LimitSwitchDirectionUndefined,///<Undefined
		MOT_ReverseLimitSwitch = 0x01,///<Limit switch in forward direction
		MOT_ForwardLimitSwitch = 0x04,///<Limit switch in reverse direction
	} MOT_HomeLimitSwitchDirection;

	/// <summary> Values that represent Direction Type. </summary>
	typedef enum MOT_DirectionSense : short
	{
		MOT_Normal = 0x00,///<Move / Jog direction is normal (clockwise).
		MOT_Backwards = 0x01,///<Move / Jog direction is reversed (anti clockwise).
	} MOT_DirectionSense;

	/// <summary> Values that represent the motor Jog Modes. </summary>
	typedef enum MOT_JogModes : short
	{
		MOT_JogModeUndefined = 0x00,///<Undefined
		MOT_Continuous = 0x01,///<Continuous jogging
		MOT_SingleStep = 0x02,///<Jog 1 step at a time
	} MOT_JogModes;

	/// <summary> Values that represent the motor Jog Modes. </summary>
	typedef enum MOT_StopModes : short
	{
		MOT_StopModeUndefined = 0x00,///<Undefined
		MOT_Immediate = 0x01,///<Stops immediate
		MOT_Profiled = 0x02,///<Stops using a velocity profile
	} MOT_StopModes;

	/// <summary> Values that represent the motor Button Modes. </summary>
	typedef enum MOT_ButtonModes : WORD
	{
		MOT_ButtonModeUndefined = 0x00,///<Undefined
		MOT_JogMode = 0x01,///<Jog motor in correct direction for button
		MOT_Preset = 0x02,///<Move to preset position
	} MOT_ButtonModes;

	/// <summary> Value that represent action to be taken when motor hits a limit switch. </summary>
	typedef enum MOT_LimitSwitchModes : WORD
	{
		MOT_LimitSwitchModeUndefined = 0x00,///<Undefined
		MOT_LimitSwitchIgnoreSwitch=0x01,///<Ignore limit switch
		MOT_LimitSwitchMakeOnContact=0x02,///<Switch makes on contact
		MOT_LimitSwitchBreakOnContact=0x03,///<Switch breaks on contact
		MOT_LimitSwitchMakeOnHome=0x04,///<Switch makes on contact when homing
		MOT_LimitSwitchBreakOnHome=0x05,///<Switch breaks on contact when homing
		MOT_PMD_Reserved=0x06,///<Reserved for PMD brushless servo controllers
		MOT_LimitSwitchIgnoreSwitchSwapped = 0x81,///<Ignore limit switch (swapped)
		MOT_LimitSwitchMakeOnContactSwapped = 0x82,///<Switch makes on contact (swapped)
		MOT_LimitSwitchBreakOnContactSwapped = 0x83,///<Switch breaks on contact (swapped)
		MOT_LimitSwitchMakeOnHomeSwapped = 0x84,///<Switch makes on contact when homing (swapped)
		MOT_LimitSwitchBreakOnHomeSwapped = 0x85,///<Switch breaks on contact when homing (swapped)
	} MOT_LimitSwitchModes;

	/// <summary> Value that represent action to be taken when motor hits a limit switch. </summary>
	typedef enum MOT_LimitSwitchSWModes : WORD
	{
		MOT_LimitSwitchSWModeUndefined = 0x00,///<Undefined
		MOT_LimitSwitchIgnored=0x01,///<Ignore limit switch
		MOT_LimitSwitchStopImmediate=0x02,///<Stop immediately when hitting limit switch
		MOT_LimitSwitchStopProfiled=0x03,///<Stop profiled when hitting limit switch
		MOT_LimitSwitchIgnored_Rotational=0x81,///<Ignore limit switch (rotational stage)
		MOT_LimitSwitchStopImmediate_Rotational=0x82,///<Stop immediately when hitting limit switch (rotational stage)
		MOT_LimitSwitchStopProfiled_Rotational=0x83,///<Stop profiled when hitting limit switch (rotational stage)
	} MOT_LimitSwitchSWModes;

	/// <summary> Values that represent MOT_LimitsSoftwareApproachPolicy. </summary>
	typedef enum MOT_LimitsSoftwareApproachPolicy : __int16
	{
		DisallowIllegalMoves = 0,///<Disable any move outside travel range
		AllowPartialMoves,///<Truncate all moves beyond limit to limit.
		AllowAllMoves,///<Allow all moves, illegal or not
	} MOT_LimitsSoftwareApproachPolicy;

	/// <summary> Values that represent DeviceMessageClass message types. </summary>
	typedef enum MOT_MovementModes
	{
		LinearRange = 0x00,///< Fixed Angular Range defined by MinPosition and MaxPosition
		RotationalUnlimited = 0x01,///< Unlimited angle
		RotationalWrapping = 0x02,///< Angular Range 0 to 360 with wrap around
	} MOT_MovementModes;

	/// <summary> Values that represent DeviceMessageClass message types. </summary>
	typedef enum MOT_MovementDirections
	{
		Quickest = 0x00,///< Uses the shortest travel between two angles
		Forwards = 0x01,///< Only rotate in a forward direction
		Reverse = 0x02,///< Only rotate in a backward direction
	} MOT_MovementDirections;
	/// \endcond

	/// <summary> Information about the device generated from serial number. </summary>
	#pragma pack(1)
	typedef struct TLI_DeviceInfo
	{
		/// <summary> The device Type ID, see \ref C_DEVICEID_page "Device serial numbers". </summary>
		DWORD typeID;
		/// <summary> The device description. </summary>
		char description[65];
		/// <summary> The device serial number. </summary>
		char serialNo[9];
		/// <summary> The USB PID number. </summary>
		DWORD PID;

		/// <summary> <c>true</c> if this object is a type known to the Motion Control software. </summary>
		bool isKnownType;
		/// <summary> The motor type (if a motor).
		/// 		  <list type=table>
		///				<item><term>MOT_NotMotor</term><term>0</term></item>
		///				<item><term>MOT_DCMotor</term><term>1</term></item>
		///				<item><term>MOT_StepperMotor</term><term>2</term></item>
		///				<item><term>MOT_BrushlessMotor</term><term>3</term></item>
		///				<item><term>MOT_CustomMotor</term><term>100</term></item>
		/// 		  </list> </summary>
		MOT_MotorTypes motorType;

		/// <summary> <c>true</c> if the device is a piezo device. </summary>
		bool isPiezoDevice;
		/// <summary> <c>true</c> if the device is a laser. </summary>
		bool isLaser;
		/// <summary> <c>true</c> if the device is a custom type. </summary>
		bool isCustomType;
		/// <summary> <c>true</c> if the device is a rack. </summary>
		bool isRack;
		/// <summary> Defines the number of channels available in this device. </summary>
		short maxChannels;
	} TLI_DeviceInfo;

	/// <summary> Structure containing the Hardware Information. </summary>
	typedef struct TLI_HardwareInformation
	{
		/// <summary> The device serial number. </summary>
		/// <remarks> The device serial number is a serial number,<br />starting with 2 digits representing the device type<br /> and a 6 digit unique value.</remarks>
		DWORD serialNumber;
		/// <summary> The device model number. </summary>
		/// <remarks> The model number uniquely identifies the device type as a string. </remarks>
		char modelNumber[8];
		/// <summary> The device type. </summary>
		/// <remarks> Each device type has a unique Type ID: see \ref C_DEVICEID_page "Device serial numbers" </remarks>
		WORD type;
		/// <summary> The device firmware version. </summary>
		DWORD firmwareVersion;
		/// <summary> The device notes read from the device. </summary>
		char notes[48];
		/// <summary> The device dependant data. </summary>
		BYTE deviceDependantData[12];
		/// <summary> The device hardware version. </summary>
		WORD hardwareVersion;
		/// <summary> The device modification state. </summary>
		WORD modificationState;
		/// <summary> The number of channels the device provides. </summary>
		short numChannels;
	} TLI_HardwareInformation;

	/// <summary> Structure containing the velocity parameters. </summary>
	/// <remarks> Moves are performed using a velocity profile.<br />
	/// 		  The move starts at the Minimum Velocity (always 0 at present) and accelerated to the Maximum Velocity using the defined Acceleration.<br/>
	/// 		  The move is usually completed using a similar deceleration.<br/>
	/// 		  For further information see \ref C_MOTOR_sec11 "Positioning" </remarks>
	/// <seealso cref="MOT_JogParameters"/>
	/// <seealso cref="MOT_HomingParameters"/>
	typedef struct MOT_VelocityParameters
	{
		/// <summary> The minimum velocity in \ref DeviceUnits_page usually 0. </summary>
		int minVelocity;
		/// <summary> The acceleration in \ref DeviceUnits_page. </summary>
		int acceleration;
		/// <summary> The maximum velocity in \ref DeviceUnits_page. </summary>
		int maxVelocity;
	} MOT_VelocityParameters;

	/// <summary> Structure containing the jog parameters. </summary>
	/// <remarks> Jogs are performed using a velocity profile over small fixed distances.<br />
	/// 		  The move starts at the Minimum Velocity (always 0 at present) and accelerated to the Maximum Velocity using the defined Acceleration.<br/>
	/// 		  The move is usually completed using a similar deceleration.<br/>
	/// 		  For further information see \ref C_MOTOR_sec12 "Jogging" </remarks>
	/// <seealso cref="MOT_VelocityParameters"/>
	/// <seealso cref="MOT_HomingParameters"/>
	typedef struct MOT_JogParameters
	{
		/// <summary> The jogging mode. </summary>
		/// <remarks> The mode can be one of the following:
		/// 		  <list type=table>
		///				<item><term>1</term><term>Continuous Jogging<br />The device will continue moving until the end stop is reached or the device button is raised</term></item>
		///				<item><term>2</term><term>Step Jogbr />The device will move by a fixed amount as defined in this structure.</term></item>
		/// 		  </list></remarks>
		MOT_JogModes mode;
		/// <summary> The step size in \ref DeviceUnits_page. </summary>
		unsigned int stepSize;
		/// <summary> The MOT_VelocityParameters for the jog. </summary>
		MOT_VelocityParameters velParams;
		/// <summary> The Stop Mode</summary>
		/// <remarks> The Stop Mode determines how the jog should stop.
		/// 		  <list type=table>
		///				<item><term>1</term><term>Immediate</term></item>
		///				<item><term>2</term><term>Profiled.</term></item>
		/// 		  </list> </remarks>
		MOT_StopModes stopMode;
	} MOT_JogParameters;

	/// <summary> Structure containing the homing parameters. </summary>
	/// <remarks> Homing is performed using a constant velocity.<br />
	/// 		  The home starts moving the motor in the defined direction until the limit switch is detected.<br/>
	/// 		  The device will then vback off from the limit switch by  the defined offset distance.<br />
	/// 		  For further information see \ref C_MOTOR_sec10 "Homing" </remarks>
	/// <seealso cref="MOT_VelocityParameters"/>
	/// <seealso cref="MOT_JogParameters"/>
	typedef struct MOT_HomingParameters
	{
		/// <summary> The Homing direction sense </summary>
		/// <remarks> The Homing Operation will always move in a decreasing position sense, but the actuator gearing may change the actual physical sense<br/>
		/// 		  Therefore the homing direction can correct the physical sense.
		/// 		 <list type=table>
		///				<item><term>1</term><term>Forwards</term></item>
		///				<item><term>2</term><term>Backwards.</term></item>
		/// 		  </list></remarks>
		MOT_TravelDirection direction;
		/// <summary> The limit switch direction. </summary>
		/// <remarks> The limit switch which will be hit when homing completes.
		/// 		 <list type=table>
		///				<item><term>1</term><term>Forward Limit Switch</term></item>
		///				<item><term>2</term><term>Reverse Limit Switch.</term></item>
		/// 		  </list</remarks>
		MOT_HomeLimitSwitchDirection limitSwitch;
		/// <summary> The velocity in small indivisible units. </summary>
		/// <remarks> As the homing operation is performed at a much lower velocity, to achieve accuracy, a profile is not required.</remarks>
		unsigned int velocity;
		/// <summary> Distance of home from limit in small indivisible units. </summary>
		unsigned int offsetDistance;
	} MOT_HomingParameters;

	/// <summary> Structure containing the limit switch parameters. </summary>
	typedef struct MOT_LimitSwitchParameters
	{
		/// <summary> Defines the clockwise hardware limit. </summary>
		/// <remarks> The clockwise hardware limit
		/// 		 <list type=table>
		///				<item><term>0x01</term><term>Ignore limit switch</term></item>
		///				<item><term>0x02</term><term>Make on contact.</term></item>
		///				<item><term>0x03</term><term>Break on contact.</term></item>
		///				<item><term>0x04</term><term>Makes on contact when homing</term></item>
		///				<item><term>0x05</term><term>Break on contact when homing.</term></item>
		///				<item><term>0x06</term><term>Reserved for PMD brushless servo controllers.</term></item>
		///				<item><term>0x80</term><term>Switch mode when using a rotational stage.</term></item>
		/// 		  </list> </remarks>
		MOT_LimitSwitchModes clockwiseHardwareLimit;
		/// <summary> Defines the anticlockwise hardware limit. </summary>
		/// <remarks> The anticlockwise hardware limit
		/// 		 <list type=table>
		///				<item><term>0x01</term><term>Ignore limit switch</term></item>
		///				<item><term>0x02</term><term>Make on contact.</term></item>
		///				<item><term>0x03</term><term>Break on contact.</term></item>
		///				<item><term>0x04</term><term>Makes on contact when homing</term></item>
		///				<item><term>0x05</term><term>Break on contact when homing.</term></item>
		///				<item><term>0x06</term><term>Reserved for PMD brushless servo controllers.</term></item>
		///				<item><term>0x80</term><term>Switch mode when using a rotational stage.</term></item>
		/// 		  </list> </remarks>
		MOT_LimitSwitchModes anticlockwiseHardwareLimit;
		/// <summary> poition of clockwise software limit in \ref DeviceUnits_page. </summary>
		DWORD clockwisePosition;
		/// <summary> poition of anticlockwise software limit in \ref DeviceUnits_page. </summary>
		DWORD anticlockwisePosition;
		/// <summary> Actions to take when software limit is detected. </summary>
		/// <remarks> The anticlockwise hardware limit
		/// 		 <list type=table>
		///				<item><term>0x01</term><term>Ignore limit switche.</term></item>
		///				<item><term>0x02</term><term>Stop Immediate.</term></item>
		///				<item><term>0x03</term><term>Profiled stop.</term></item>
		///				<item><term>0x82</term><term>Stop Immediate (rotational stage).</term></item>
		///				<item><term>0x83</term><term>Profiled stop (rotational stage).</term></item>
		/// 		  </list> </remarks>
		MOT_LimitSwitchSWModes softLimitMode;
	} MOT_LimitSwitchParameters;

	/// <summary> Structure containing power settings for the stepper controllers. </summary>
	typedef struct MOT_PowerParameters
	{
		/// <summary> Percentage of full power to give while not moving (0 - 100). </summary>
		WORD restPercentage;
		/// <summary> Percentage of full power to give while moving (0 - 100). </summary>
		WORD movePercentage;
	} MOT_PowerParameters;

	/// <summary> Structure containing the button action definition parameters. </summary>
	typedef struct MOT_ButtonParameters
	{
		/// <summary> Defines the mode of operation of the device buttons </summary>
		/// <remarks> The buttons on a Device can be defined to either jog or move to a preset position.
		/// 		 <list type=table>
		///				<item><term>1</term><term>Jog the device according to the MOT_JogParameters</term></item>
		///				<item><term>2</term><term>Move to the preset button positions.</term></item>
		/// 		  </list></remarks>
		MOT_ButtonModes buttonMode;
		/// <summary> Position in encoder counts to go to when left button is pressed. </summary>
		int leftButtonPosition;
		/// <summary> Position in encoder counts to go to when right button is pressed. </summary>
		int rightButtonPosition;
		/// <summary> The Time a button needs to be held down for to record the position as a preset. </summary>
		/// <remarks> For information only - cannot be set. </remarks>
		WORD timeout;
		/// <summary> Not Used. </summary>
		WORD unused;
	} MOT_ButtonParameters;

	/// <summary> Structure containing the Potentiometer step parameters. </summary>
	/// <remarks> MOT_PotentiometerStep define steps in the MOT_PotentiometerSteps structure as a look up table.</remarks>
	typedef struct MOT_PotentiometerStep
	{
		/// <summary> Deflection of potentiometer 0 - 127 from center point which defines step range. </summary>
		WORD thresholdDeflection;
		/// <summary> The velocity for the defined range. </summary>
		DWORD velocity;
	} MOT_PotentiometerStep;

	/// <summary> Structure containing the Potentiometer step look up table. </summary>
	/// <remarks> The structure defines a lookup table with 4 discrete steps</remarks>
	typedef struct MOT_PotentiometerSteps
	{
		/// <summary> The 4 defined MOT_PotentiometerStep positions. </summary>
		MOT_PotentiometerStep potentiometerStepParameters[4];
	} MOT_PotentiometerSteps;

	#pragma pack()

    /// <summary> Build the DeviceList. </summary>
    /// <remarks> This function builds an internal collection of all devices found on the USB that are not currently open. <br />
    /// 		  NOTE, if a device is open, it will not appear in the list until the device has been closed. </remarks>
	/// <returns> The error code (see \ref C_DLL_ERRORCODES_page "Error Codes") or zero if successful. </returns>
    /// 		  \include CodeSnippet_identification.cpp
	/// <seealso cref="TLI_GetDeviceListSize()" />
	/// <seealso cref="TLI_GetDeviceList(SAFEARRAY** stringsReceiver)" />
	/// <seealso cref="TLI_GetDeviceListByType(SAFEARRAY** stringsReceiver, int typeID)" />
	/// <seealso cref="TLI_GetDeviceListByTypes(SAFEARRAY** stringsReceiver, int * typeIDs, int length)" />
	/// <seealso cref="TLI_GetDeviceListExt(char *receiveBuffer, DWORD sizeOfBuffer)" />
	/// <seealso cref="TLI_GetDeviceListByTypeExt(char *receiveBuffer, DWORD sizeOfBuffer, int typeID)" />
	/// <seealso cref="TLI_GetDeviceListByTypesExt(char *receiveBuffer, DWORD sizeOfBuffer, int * typeIDs, int length)" />
	ISC_API short __cdecl TLI_BuildDeviceList(void);

	/// <summary> Gets the device list size. </summary>
	/// 		  \include CodeSnippet_identification.cpp
	/// <returns> Number of devices in device list. </returns>
	/// <seealso cref="TLI_BuildDeviceList()" />
	/// <seealso cref="TLI_GetDeviceList(SAFEARRAY** stringsReceiver)" />
	/// <seealso cref="TLI_GetDeviceListByType(SAFEARRAY** stringsReceiver, int typeID)" />
	/// <seealso cref="TLI_GetDeviceListByTypes(SAFEARRAY** stringsReceiver, int * typeIDs, int length)" />
	/// <seealso cref="TLI_GetDeviceListExt(char *receiveBuffer, DWORD sizeOfBuffer)" />
	/// <seealso cref="TLI_GetDeviceListByTypeExt(char *receiveBuffer, DWORD sizeOfBuffer, int typeID)" />
	/// <seealso cref="TLI_GetDeviceListByTypesExt(char *receiveBuffer, DWORD sizeOfBuffer, int * typeIDs, int length)" />
	ISC_API short __cdecl TLI_GetDeviceListSize();

	/// <summary> Get the entire contents of the device list. </summary>
	/// <param name="stringsReceiver"> Outputs a SAFEARRAY of strings holding device serial numbers. </param>
	/// <returns> The error code (see \ref C_DLL_ERRORCODES_page "Error Codes") or zero if successful. </returns>
    /// 		  \include CodeSnippet_identification.cpp
	/// <seealso cref="TLI_GetDeviceListSize()" />
	/// <seealso cref="TLI_BuildDeviceList()" />
	/// <seealso cref="TLI_GetDeviceListByType(SAFEARRAY** stringsReceiver, int typeID)" />
	/// <seealso cref="TLI_GetDeviceListByTypes(SAFEARRAY** stringsReceiver, int * typeIDs, int length)" />
	/// <seealso cref="TLI_GetDeviceListExt(char *receiveBuffer, DWORD sizeOfBuffer)" />
	/// <seealso cref="TLI_GetDeviceListByTypeExt(char *receiveBuffer, DWORD sizeOfBuffer, int typeID)" />
	/// <seealso cref="TLI_GetDeviceListByTypesExt(char *receiveBuffer, DWORD sizeOfBuffer, int * typeIDs, int length)" />
	ISC_API short __cdecl TLI_GetDeviceList(SAFEARRAY** stringsReceiver);

	/// <summary> Get the contents of the device list which match the supplied typeID. </summary>
	/// <param name="stringsReceiver"> Outputs a SAFEARRAY of strings holding device serial numbers. </param>
	/// <param name="typeID">The typeID of devices to match, see \ref C_DEVICEID_page "Device serial numbers". </param>
	/// <returns> The error code (see \ref C_DLL_ERRORCODES_page "Error Codes") or zero if successful. </returns>
    /// 		  \include CodeSnippet_identification.cpp
	/// <seealso cref="TLI_GetDeviceListSize()" />
	/// <seealso cref="TLI_BuildDeviceList()" />
	/// <seealso cref="TLI_GetDeviceList(SAFEARRAY** stringsReceiver)" />
	/// <seealso cref="TLI_GetDeviceListByTypes(SAFEARRAY** stringsReceiver, int * typeIDs, int length)" />
	/// <seealso cref="TLI_GetDeviceListExt(char *receiveBuffer, DWORD sizeOfBuffer)" />
	/// <seealso cref="TLI_GetDeviceListByTypeExt(char *receiveBuffer, DWORD sizeOfBuffer, int typeID)" />
	/// <seealso cref="TLI_GetDeviceListByTypesExt(char *receiveBuffer, DWORD sizeOfBuffer, int * typeIDs, int length)" />
	ISC_API short __cdecl TLI_GetDeviceListByType(SAFEARRAY** stringsReceiver, int typeID);

	/// <summary> Get the contents of the device list which match the supplied typeIDs. </summary>
	/// <param name="stringsReceiver"> Outputs a SAFEARRAY of strings holding device serial numbers. </param>
	/// <param name="typeIDs"> list of typeIDs of devices to be matched, see \ref C_DEVICEID_page "Device serial numbers"</param>
	/// <param name="length"> length of type list</param>
	/// <returns> The error code (see \ref C_DLL_ERRORCODES_page "Error Codes") or zero if successful. </returns>
    /// 		  \include CodeSnippet_identification.cpp
	/// <seealso cref="TLI_GetDeviceListSize()" />
	/// <seealso cref="TLI_BuildDeviceList()" />
	/// <seealso cref="TLI_GetDeviceList(SAFEARRAY** stringsReceiver)" />
	/// <seealso cref="TLI_GetDeviceListByType(SAFEARRAY** stringsReceiver, int typeID)" />
	/// <seealso cref="TLI_GetDeviceListExt(char *receiveBuffer, DWORD sizeOfBuffer)" />
	/// <seealso cref="TLI_GetDeviceListByTypeExt(char *receiveBuffer, DWORD sizeOfBuffer, int typeID)" />
	/// <seealso cref="TLI_GetDeviceListByTypesExt(char *receiveBuffer, DWORD sizeOfBuffer, int * typeIDs, int length)" />
	ISC_API short __cdecl TLI_GetDeviceListByTypes(SAFEARRAY** stringsReceiver, int * typeIDs, int length);

	/// <summary> Get the entire contents of the device list. </summary>
	/// <param name="receiveBuffer"> a buffer in which to receive the list as a comma separated string. </param>
	/// <param name="sizeOfBuffer">	The size of the output string buffer. </param>
	/// <returns> The error code (see \ref C_DLL_ERRORCODES_page "Error Codes") or zero if successful. </returns>
    /// 		  \include CodeSnippet_identification.cpp
	/// <seealso cref="TLI_GetDeviceListSize()" />
	/// <seealso cref="TLI_BuildDeviceList()" />
	/// <seealso cref="TLI_GetDeviceList(SAFEARRAY** stringsReceiver)" />
	/// <seealso cref="TLI_GetDeviceListByType(SAFEARRAY** stringsReceiver, int typeID)" />
	/// <seealso cref="TLI_GetDeviceListByTypes(SAFEARRAY** stringsReceiver, int * typeIDs, int length)" />
	/// <seealso cref="TLI_GetDeviceListByTypeExt(char *receiveBuffer, DWORD sizeOfBuffer, int typeID)" />
	/// <seealso cref="TLI_GetDeviceListByTypesExt(char *receiveBuffer, DWORD sizeOfBuffer, int * typeIDs, int length)" />
	ISC_API short __cdecl TLI_GetDeviceListExt(char *receiveBuffer, DWORD sizeOfBuffer);

	/// <summary> Get the contents of the device list which match the supplied typeID. </summary>
	/// <param name="receiveBuffer"> a buffer in which to receive the list as a comma separated string. </param>
	/// <param name="sizeOfBuffer">	The size of the output string buffer. </param>
	/// <param name="typeID"> The typeID of devices to be matched, see \ref C_DEVICEID_page "Device serial numbers"</param>
	/// <returns> The error code (see \ref C_DLL_ERRORCODES_page "Error Codes") or zero if successful. </returns>
    /// 		  \include CodeSnippet_identification.cpp
	/// <seealso cref="TLI_GetDeviceListSize()" />
	/// <seealso cref="TLI_BuildDeviceList()" />
	/// <seealso cref="TLI_GetDeviceList(SAFEARRAY** stringsReceiver)" />
	/// <seealso cref="TLI_GetDeviceListByType(SAFEARRAY** stringsReceiver, int typeID)" />
	/// <seealso cref="TLI_GetDeviceListByTypes(SAFEARRAY** stringsReceiver, int * typeIDs, int length)" />
	/// <seealso cref="TLI_GetDeviceListExt(char *receiveBuffer, DWORD sizeOfBuffer)" />
	/// <seealso cref="TLI_GetDeviceListByTypesExt(char *receiveBuffer, DWORD sizeOfBuffer, int * typeIDs, int length)" />
	ISC_API short __cdecl TLI_GetDeviceListByTypeExt(char *receiveBuffer, DWORD sizeOfBuffer, int typeID);

	/// <summary> Get the contents of the device list which match the supplied typeIDs. </summary>
	/// <param name="receiveBuffer"> a buffer in which to receive the list as a comma separated string. </param>
	/// <param name="sizeOfBuffer">	The size of the output string buffer. </param>
	/// <param name="typeIDs"> list of typeIDs of devices to be matched, see \ref C_DEVICEID_page "Device serial numbers"</param>
	/// <param name="length"> length of type list</param>
	/// <returns> The error code (see \ref C_DLL_ERRORCODES_page "Error Codes") or zero if successful. </returns>
    /// 		  \include CodeSnippet_identification.cpp
	/// <seealso cref="TLI_GetDeviceListSize()" />
	/// <seealso cref="TLI_BuildDeviceList()" />
	/// <seealso cref="TLI_GetDeviceList(SAFEARRAY** stringsReceiver)" />
	/// <seealso cref="TLI_GetDeviceListByType(SAFEARRAY** stringsReceiver, int typeID)" />
	/// <seealso cref="TLI_GetDeviceListByTypes(SAFEARRAY** stringsReceiver, int * typeIDs, int length)" />
	/// <seealso cref="TLI_GetDeviceListExt(char *receiveBuffer, DWORD sizeOfBuffer)" />
	/// <seealso cref="TLI_GetDeviceListByTypeExt(char *receiveBuffer, DWORD sizeOfBuffer, int typeID)" />
	ISC_API short __cdecl TLI_GetDeviceListByTypesExt(char *receiveBuffer, DWORD sizeOfBuffer, int * typeIDs, int length);

	/// <summary> Get the device information from the USB port. </summary>
	/// <remarks> The Device Info is read from the USB port not from the device itself.<remarks>
	/// <param name="serialNo"> The serial number of the device. </param>
	/// <param name="info">    The <see cref="TLI_DeviceInfo"/> device information. </param>
	/// <returns> 1 if successful, 0 if not. </returns>
    /// 		  \include CodeSnippet_identification.cpp
	/// <seealso cref="TLI_GetDeviceListSize()" />
	/// <seealso cref="TLI_BuildDeviceList()" />
	/// <seealso cref="TLI_GetDeviceList(SAFEARRAY** stringsReceiver)" />
	/// <seealso cref="TLI_GetDeviceListByType(SAFEARRAY** stringsReceiver, int typeID)" />
	/// <seealso cref="TLI_GetDeviceListByTypes(SAFEARRAY** stringsReceiver, int * typeIDs, int length)" />
	/// <seealso cref="TLI_GetDeviceListExt(char *receiveBuffer, DWORD sizeOfBuffer)" />
	/// <seealso cref="TLI_GetDeviceListByTypeExt(char *receiveBuffer, DWORD sizeOfBuffer, int typeID)" />
	/// <seealso cref="TLI_GetDeviceListByTypesExt(char *receiveBuffer, DWORD sizeOfBuffer, int * typeIDs, int length)" />
	ISC_API short __cdecl TLI_GetDeviceInfo(char const * serialNo, TLI_DeviceInfo *info);

	/// <summary> Open the device for communications. </summary>
	/// <param name="serialNo">	The serial no of the device to be connected. </param>
	/// <returns> The error code (see \ref C_DLL_ERRORCODES_page "Error Codes") or zero if successful. </returns>
    /// 		  \include CodeSnippet_connection1.cpp
	/// <seealso cref="ISC_Close(char const * serialNo)" />
	ISC_API short __cdecl ISC_Open(char const * serialNo);

	/// <summary> Disconnect and close the device. </summary>
	/// <param name="serialNo">	The serial no of the device to be disconnected. </param>
    /// 		  \include CodeSnippet_connection1.cpp
	/// <seealso cref="ISC_Open(char const * serialNo)" />
	ISC_API void __cdecl ISC_Close(char const * serialNo);

	/// <summary>	Check connection. </summary>
	/// <param name="serialNo">	The device serial no. </param>
	/// <returns> true if the USB is listed by the ftdi controller</returns>
	/// \include CodeSnippet_CheckConnection.cpp
	ISC_API bool __cdecl ISC_CheckConnection(char const * serialNo);

	/// <summary> Sends a command to the device to make it identify iteself. </summary>
	/// <param name="serialNo">	The device serial no. </param>
	ISC_API void __cdecl ISC_Identify(char const * serialNo);

	/// <summary> Get the LED indicator bits on device. </summary>
	/// <param name="serialNo">	The device serial no. </param>
	/// <returns> Sum of: 8 to indicate moving 2 to indicate end of track and 1 to flash on identify command. </returns>
	/// <seealso cref="ISC_SetLEDswitches(char const * serialNo, WORD LEDswitches)" />
	ISC_API WORD __cdecl ISC_GetLEDswitches(char const * serialNo);

	/// <summary> Set the LED indicator bits on device. </summary>
	/// <param name="serialNo">	The device serial no. </param>
	/// <param name="LEDswitches"> Sum of: 8 to indicate moving 2 to indicate end of track and 1 to flash on identify command. </param>
	/// <returns> The error code (see \ref C_DLL_ERRORCODES_page "Error Codes") or zero if successful. </returns>
	/// <seealso cref="ISC_GetLEDswitches(char const * serialNo)" />
	ISC_API short __cdecl ISC_SetLEDswitches(char const * serialNo, WORD LEDswitches);

	/// <summary> Gets the hardware information from the device. </summary>
	/// <param name="serialNo">		    The device serial no. </param>
	/// <param name="modelNo">		    Address of a buffer to receive the model number string. Minimum 8 characters </param>
	/// <param name="sizeOfModelNo">	    The size of the model number buffer, minimum of 8 characters. </param>
	/// <param name="type">		    Address of a WORD to receive the hardware type number. </param>
	/// <param name="numChannels">	    Address of a short to receive the  number of channels. </param>
	/// <param name="notes">		    Address of a buffer to receive the notes describing the device. </param>
	/// <param name="sizeOfNotes">		    The size of the notes buffer, minimum of 48 characters. </param>
	/// <param name="firmwareVersion"> Address of a DWORD to receive the  firmware version number made up of 4 byte parts. </param>
	/// <param name="hardwareVersion"> Address of a WORD to receive the  hardware version number. </param>
	/// <param name="modificationState">	    Address of a WORD to receive the hardware modification state number. </param>
	/// <returns> The error code (see \ref C_DLL_ERRORCODES_page "Error Codes") or zero if successful. </returns>
    /// 		  \include CodeSnippet_identify.cpp
	ISC_API short __cdecl ISC_GetHardwareInfo(char const * serialNo, char * modelNo, DWORD sizeOfModelNo, WORD * type, WORD * numChannels, 
													   char * notes, DWORD sizeOfNotes, DWORD * firmwareVersion, WORD * hardwareVersion, WORD * modificationState);

	/// <summary> Gets the hardware information in a block. </summary>
	/// <param name="serialNo">	The device serial no. </param>
	/// <param name="hardwareInfo"> Address of a TLI_HardwareInformation structure to receive the hardware information. </param>
	/// <returns> The error code (see \ref C_DLL_ERRORCODES_page "Error Codes") or zero if successful. </returns>
    /// 		  \include CodeSnippet_identify.cpp
	ISC_API short __cdecl ISC_GetHardwareInfoBlock(char const * serialNo, TLI_HardwareInformation *hardwareInfo);

	/// <summary> Gets version number of the device firmware. </summary>
	/// <param name="serialNo">	The device serial no. </param>
	/// <returns> The device firmware version number made up of 4 byte parts. </returns>
    /// 		  \include CodeSnippet_identify.cpp
	ISC_API DWORD __cdecl ISC_GetFirmwareVersion(char const * serialNo);

	/// <summary> Gets version number of the device software. </summary>
	/// <param name="serialNo">	The device serial no. </param>
	/// <returns> The device software version number made up of 4 byte parts. </returns>
    /// 		  \include CodeSnippet_identify.cpp
	ISC_API DWORD __cdecl ISC_GetSoftwareVersion(char const * serialNo);

	/// <summary> Set the calibration file for this motor. </summary>
	/// <param name="serialNo"> The device serial no. </param>
	/// <param name="filename"> Filename of the calibration file to load. </param>
	/// <param name="enabled">  <c>true</c> to enable,  <c>false</c> to disable. </param>
	/// <seealso cref="ISC_IsCalibrationActive(char const * serialNo)" />
	/// <seealso cref="ISC_GetCalibrationFile(char const * serialNo, char * filename, short sizeOfBuffer)" />
	ISC_API void __cdecl ISC_SetCalibrationFile(char const * serialNo, char const *filename, bool enabled);

	/// <summary> Is a calibration file active for this motor. </summary>
	/// <param name="serialNo"> The device serial no. </param>
	/// <returns> <c>true</c> if A calibration file is active. </returns>
	/// <seealso cref="ISC_GetCalibrationFile(char const * serialNo, char * filename, short sizeOfBuffer)" />
	/// <seealso cref="ISC_SetCalibrationFile(char const * serialNo, char const *filename, bool enabled)" />
	ISC_API bool __cdecl ISC_IsCalibrationActive(char const * serialNo);

	/// <summary> Get calibration file for this motor. </summary>
	/// <param name="serialNo"> The device serial no. </param>
	/// <param name="filename"> Address of an output buffer to receive the filename. </param>
	/// <param name="sizeOfBuffer"> The size of the filename output buffer. </param>
	/// <returns> <c>true</c> if successful, false if not. </returns>
	/// <seealso cref="ISC_IsCalibrationActive(char const * serialNo)" />
	/// <seealso cref="ISC_SetCalibrationFile(char const * serialNo, char const *filename, bool enabled)" />
	ISC_API bool __cdecl ISC_GetCalibrationFile(char const * serialNo, char * filename, short sizeOfBuffer);

	/// <summary> Update device with stored settings. </summary>
	/// <param name="serialNo"> The device serial no. </param>
	/// <returns> <c>true</c> if successful, false if not. </returns>
    /// 		  \include CodeSnippet_connection1.cpp
	ISC_API bool __cdecl ISC_LoadSettings(char const * serialNo);

	/// <summary> Update device with named settings. </summary>
	/// <param name="serialNo"> The device serial no. </param>
	/// <param name="settingsName"> Name of settings stored away from device. </param>
	/// <returns> <c>true</c> if successful, false if not. </returns>
	///             \include CodeSnippet_connection1.cpp
	ISC_API bool __cdecl ISC_LoadNamedSettings(char const * serialNo, char const *settingsName);

	/// <summary> persist the devices current settings. </summary>
	/// <param name="serialNo">	The device serial no. </param>
	/// <returns> <c>true</c> if successful, false if not. </returns>
	ISC_API bool __cdecl ISC_PersistSettings(char const * serialNo);

	/// <summary> Reset the stage settings to defaults. </summary>
	/// <param name="serialNo"> The device serial no. </param>
	/// <returns> <c>true</c> if successful, false if not. </returns>
	ISC_API short __cdecl ISC_ResetStageToDefaults(char const * serialNo);

	/// <summary> Disable the channel so that motor can be moved by hand. </summary>
	/// <remarks> When disabled power is removed from the motor and it can be freely moved.</remarks>
	/// <param name="serialNo">	The device serial no. </param>
	/// <returns> The error code (see \ref C_DLL_ERRORCODES_page "Error Codes") or zero if successful. </returns>
	/// <seealso cref="ISC_EnableChannel(char const * serialNo)" />
	ISC_API short __cdecl ISC_DisableChannel(char const * serialNo);

	/// <summary> Enable channel for computer control. </summary>
	/// <remarks> When enabled power is applied to the motor so it is fixed in position.</remarks>
	/// <param name="serialNo">	The device serial no. </param>
	/// <returns> The error code (see \ref C_DLL_ERRORCODES_page "Error Codes") or zero if successful. </returns>
	/// <seealso cref="ISC_DisableChannel(char const * serialNo)" />
	ISC_API short __cdecl ISC_EnableChannel(char const * serialNo);

	/// <summary> Get number of positions. </summary>
	/// <remarks> The GetNumberPositions function will get the maximum position reachable by the device.<br />
	/// 		  The motor may need to be \ref C_MOTOR_sec10 "Homed" before this parameter can be used. </remarks>
	/// <param name="serialNo">	The device serial no. </param>
	/// <returns> The number of positions. </returns>
	/// <seealso cref="ISC_MoveToPosition(char const * serialNo, int index)" />
	/// <seealso cref="ISC_GetPosition(char const * serialNo)" />
	/// <seealso cref="ISC_Home(char const * serialNo)" />
    /// 		  \include CodeSnippet_move.cpp
	ISC_API int __cdecl ISC_GetNumberPositions(char const * serialNo);

	/// <summary> Move the device to the specified position (index). </summary>
	/// <remarks> The motor may need to be \ref C_MOTOR_sec10 "Homed" before a position can be set<br />
	/// 		  see \ref C_MOTOR_sec11 "Positioning" for more detail. </remarks>
	/// <param name="serialNo">	The device serial no. </param>
	/// <param name="index">   	The position in \ref DeviceUnits_page. </param>
	/// <returns> The error code (see \ref C_DLL_ERRORCODES_page "Error Codes") or zero if move successfully started. </returns>
	/// <seealso cref="ISC_GetNumberPositions(char const * serialNo)" />
	/// <seealso cref="ISC_SetVelParams(char const * serialNo, int acceleration, int maxVelocity)" />
	/// <seealso cref="ISC_GetPosition(char const * serialNo)" />
	/// <seealso cref="ISC_GetVelParams(char const * serialNo, int * acceleration, int * maxVelocity)" />
	/// <seealso cref="ISC_GetVelParamsBlock(char const * serialNo, MOT_VelocityParameters  *velocityParams)" />
	/// <seealso cref="ISC_SetVelParamsBlock(char const * serialNo, MOT_VelocityParameters *velocityParams)" />
	/// <seealso cref="ISC_MoveRelative(char const * serialNo, int displacement)" />
	/// <seealso cref="ISC_MoveAtVelocity(char const * serialNo, MOT_TravelDirection direction)" />
    /// 		  \include CodeSnippet_move.cpp
	ISC_API short __cdecl ISC_MoveToPosition(char const * serialNo, int index);

	/// <summary> Get the current position. </summary>
	/// <remarks> The current position is the last recorded position.<br />
	/// 		  The current position is updated either by the polling mechanism or<br />
	/// 		  by calling <see cref="RequestPosition" /> or <see cref="RequestStatus" />.</remarks>
	/// <param name="serialNo">	The device serial no. </param>
	/// <returns> The current position in \ref DeviceUnits_page. </returns>
	/// <seealso cref="ISC_GetNumberPositions(char const * serialNo)" />
	/// <seealso cref="ISC_MoveToPosition(char const * serialNo, int index)" />
	/// <seealso cref="ISC_Home(char const * serialNo)" />
    /// 		  \include CodeSnippet_move.cpp
	ISC_API int __cdecl ISC_GetPosition(char const * serialNo);

	/// <summary> Can the device perform a Home. </summary>
	/// <param name="serialNo"> The serial no. </param>
	/// <returns> <c>true</c> if the device can home. </returns>
	ISC_API bool __cdecl ISC_CanHome(char const * serialNo);

	/// <summary> Does the device need to be Homed before a move can be performed. </summary>
	/// <remarks> @deprecated superceded by <see cref="ISC_CanMoveWithoutHomingFirst(char const * serialNo)"/> </remarks>
	/// <param name="serialNo"> The serial no. </param>
	/// <returns> <c>true</c> if the device needs homing. </returns>
	ISC_API bool __cdecl ISC_NeedsHoming(char const * serialNo);

	/// <summary> Can this device be moved without Homing. </summary>
	/// <param name="serialNo"> The serial no. </param>
	/// <returns> <c>true</c> if the device does not need to be homed before a move can be commanded. </returns>
	ISC_API bool __cdecl ISC_CanMoveWithoutHomingFirst(char const * serialNo);

	/// <summary> Home the device. </summary>
	/// <remarks> Homing the device will set the device to a known state and determine the home position,<br />
	/// 		  see \ref C_MOTOR_sec10 "Homing" for more detail. </remarks>
	/// <param name="serialNo">	The device serial no. </param>
	/// <returns> The error code (see \ref C_DLL_ERRORCODES_page "Error Codes") or zero if move successfully started. </returns>
	/// <seealso cref="ISC_GetNumberPositions(char const * serialNo)" />
	/// <seealso cref="ISC_MoveToPosition(char const * serialNo, int index)" />
	/// <seealso cref="ISC_GetPosition(char const * serialNo)" />
    /// 		  \include CodeSnippet_move.cpp
	ISC_API short __cdecl ISC_Home(char const * serialNo);

	/// <summary> Clears the device message queue. </summary>
	/// <remarks> see \ref C_MESSAGES_page "Device Messages" for details on how to use messages. </remarks>
	/// <param name="serialNo"> The device serial no. </param>
	ISC_API void __cdecl ISC_ClearMessageQueue(char const * serialNo);

	/// <summary> Registers a callback on the message queue. </summary>
	/// <remarks> see \ref C_MESSAGES_page "Device Messages" for details on how to use messages. </remarks>
	/// <param name="serialNo"> The device serial no. </param>
	/// <param name="functionPointer"> A function pointer to be called whenever messages are received. </param>
	/// <seealso cref="ISC_MessageQueueSize(char const * serialNo)" />
	/// <seealso cref="ISC_GetNextMessage(char const * serialNo, WORD * messageType, WORD * messageID, DWORD *messageData)" />
	/// <seealso cref="ISC_WaitForMessage(char const * serialNo, WORD * messageType, WORD * messageID, DWORD *messageData)" />
	ISC_API void __cdecl ISC_RegisterMessageCallback(char const * serialNo, void (* functionPointer)());

	/// <summary> Gets the MessageQueue size. </summary>
	/// <remarks> see \ref C_MESSAGES_page "Device Messages" for details on how to use messages. </remarks>
	/// <param name="serialNo"> The device serial no. </param>
	/// <returns> number of messages in the queue. </returns>
	/// <seealso cref="ISC_RegisterMessageCallback(char const * serialNo, void (* functionPointer)())" />
	/// <seealso cref="ISC_GetNextMessage(char const * serialNo, WORD * messageType, WORD * messageID, DWORD *messageData)" />
	/// <seealso cref="ISC_WaitForMessage(char const * serialNo, WORD * messageType, WORD * messageID, DWORD *messageData)" />
	ISC_API int __cdecl ISC_MessageQueueSize(char const * serialNo);

	/// <summary> Get the next MessageQueue item. </summary>
	/// <remarks> see \ref C_MESSAGES_page "Device Messages" for details on how to use messages. </remarks>
	/// <param name="serialNo"> The device serial no. </param>
	/// <param name="messageType"> The address of the parameter to receive the message Type. </param>
	/// <param name="messageID">   The address of the parameter to receive the message id. </param>
	/// <param name="messageData"> The address of the parameter to receive the message data. </param>
	/// <returns> <c>true</c> if successful, false if not. </returns>
	/// <seealso cref="ISC_RegisterMessageCallback(char const * serialNo, void (* functionPointer)())" />
	/// <seealso cref="ISC_MessageQueueSize(char const * serialNo)" />
	/// <seealso cref="ISC_WaitForMessage(char const * serialNo, WORD * messageType, WORD * messageID, DWORD *messageData)" />
	ISC_API bool __cdecl ISC_GetNextMessage(char const * serialNo, WORD * messageType, WORD * messageID, DWORD *messageData);

	/// <summary> Wait for next MessageQueue item. </summary>
	/// <remarks> see \ref C_MESSAGES_page "Device Messages" for details on how to use messages. </remarks>
	/// <param name="serialNo"> The device serial no. </param>
	/// <param name="messageType"> The address of the parameter to receive the message Type. </param>
	/// <param name="messageID">   The address of the parameter to receive the message id. </param>
	/// <param name="messageData"> The address of the parameter to receive the message data. </param>
	/// <returns> <c>true</c> if successful, false if not. </returns>
	/// <seealso cref="ISC_RegisterMessageCallback(char const * serialNo, void (* functionPointer)())" />
	/// <seealso cref="ISC_MessageQueueSize(char const * serialNo)" />
	/// <seealso cref="ISC_GetNextMessage(char const * serialNo, WORD * messageType, WORD * messageID, DWORD *messageData)" />
	ISC_API bool __cdecl ISC_WaitForMessage(char const * serialNo, WORD * messageType, WORD * messageID, DWORD *messageData);

	/// <summary> Requests the homing parameters. </summary>
	/// <param name="serialNo"> The serial no. </param>
	/// <returns> The error code (see \ref C_DLL_ERRORCODES_page "Error Codes") or zero if successful. </returns>
	/// <seealso cref="ISC_GetHomingVelocity(char const * serialNo)" />
	/// <seealso cref="ISC_GetHomingParamsBlock(char const * serialNo, MOT_HomingParameters *homingParams)" />
	ISC_API short __cdecl ISC_RequestHomingParams(char const * serialNo);

	/// <summary> Gets the homing velocity. </summary>
	/// <param name="serialNo">	The device serial no. </param>
	/// <returns> The homing velocity in \ref DeviceUnits_page. </returns>
	/// <seealso cref="ISC_SetHomingVelocity(char const * serialNo, unsigned int velocity)" />
	/// <seealso cref="ISC_RequestHomingParams(char const * serialNo)" />
	/// <seealso cref="ISC_GetHomingParamsBlock(char const * serialNo, MOT_HomingParameters *homingParams)" />
	/// <seealso cref="ISC_SetHomingParamsBlock(char const * serialNo, MOT_HomingParameters *homingParams)" />
	ISC_API unsigned int __cdecl ISC_GetHomingVelocity(char const * serialNo);

	/// <summary> Sets the homing velocity. </summary>
	/// <param name="serialNo">	The device serial no. </param>
	/// <param name="velocity"> The homing velocity in \ref DeviceUnits_page. </param>
	/// <returns> The error code (see \ref C_DLL_ERRORCODES_page "Error Codes") or zero if successful. </returns>
	/// <seealso cref="ISC_RequestHomingParams(char const * serialNo)" />
	/// <seealso cref="ISC_GetHomingVelocity(char const * serialNo)" />
	/// <seealso cref="ISC_GetHomingParamsBlock(char const * serialNo, MOT_HomingParameters *homingParams)" />
	/// <seealso cref="ISC_SetHomingParamsBlock(char const * serialNo, MOT_HomingParameters *homingParams)" />
	ISC_API short __cdecl ISC_SetHomingVelocity(char const * serialNo, unsigned int velocity);

	/// <summary> Move the motor by a relative amount. </summary>
	/// <param name="serialNo">	The device serial no. </param>
	/// <param name="displacement"> Signed displacement in \ref DeviceUnits_page.</param>
	/// <returns> The error code (see \ref C_DLL_ERRORCODES_page "Error Codes") or zero if successful. </returns>
	/// <seealso cref="ISC_GetNumberPositions(char const * serialNo)" />
	/// <seealso cref="ISC_GetVelParams(char const * serialNo, int * acceleration, int * maxVelocity)" />
	/// <seealso cref="ISC_SetVelParams(char const * serialNo, int acceleration, int maxVelocity)" />
	/// <seealso cref="ISC_GetVelParamsBlock(char const * serialNo, MOT_VelocityParameters  *velocityParams)" />
	/// <seealso cref="ISC_SetVelParamsBlock(char const * serialNo, MOT_VelocityParameters *velocityParams)" />
	/// <seealso cref="ISC_MoveToPosition(char const * serialNo, int index)" />
	/// <seealso cref="ISC_MoveAtVelocity(char const * serialNo, MOT_TravelDirection direction)" />
    /// 		  \include CodeSnippet_move.cpp
	ISC_API short __cdecl ISC_MoveRelative(char const * serialNo, int displacement);

	/// <summary> Requests the jog parameters. </summary>
	/// <remarks> see \ref C_MOTOR_sec12 "Jogging" for more detail.<remarks>
	/// <param name="serialNo"> The device serial no. </param>
	/// <returns> The error code (see \ref C_DLL_ERRORCODES_page "Error Codes") or zero if successful. </returns>
	/// <seealso cref="SCC_GetJogMode(char const * serialNo, MOT_JogModes * mode, MOT_StopModes * stopMode)" />
	/// <seealso cref="SCC_GetJogStepSize(char const * serialNo)" />
	/// <seealso cref="SCC_GetJogVelParams(char const * serialNo, int * acceleration, int * maxVelocity)" />
	/// <seealso cref="SCC_GetJogParamsBlock(char const * serialNo, MOT_JogParameters *jogParams)" />
	/// 		  \include CodeSnippet_jogpars.cpp
	ISC_API short __cdecl ISC_RequestJogParams(const char * serialNo);

	/// <summary> Gets the jog mode. </summary>
	/// <remarks> see \ref C_MOTOR_sec12 "Jogging" for more detail.<remarks>
	/// <param name="serialNo">	The device serial no. </param>
	/// <param name="mode"> The address of the short mode to recieve the Mode.
	/// 					 <list type=table>
	///							<item><term>Jog step</term><term>1</term></item>
	///							<item><term>Continuous</term><term>2</term></item>
	/// 					 </list> </param>
	/// <param name="stopMode"> The address of the short stopMode to recieve the StopMode.
	/// 					<list type=table>
	///							<item><term>Immediate Stop</term><term>1</term></item>
	///							<item><term>Profiled Stop</term><term>2</term></item>
	/// 					 </list> </param>
	/// <returns> The error code (see \ref C_DLL_ERRORCODES_page "Error Codes") or zero if successful. </returns>
	/// <seealso cref="ISC_SetJogMode(char const * serialNo, MOT_JogModes mode, MOT_StopModes stopMode)" />
	/// <seealso cref="ISC_RequestJogParams(char const * serialNo)" />
	/// <seealso cref="ISC_GetJogStepSize(char const * serialNo)" />
	/// <seealso cref="ISC_SetJogStepSize(char const * serialNo, unsigned int stepSize)" />
	/// <seealso cref="ISC_SetJogVelParams(char const * serialNo, int acceleration, int maxVelocity)" />
	/// <seealso cref="ISC_GetJogVelParams(char const * serialNo, int * acceleration, int * maxVelocity)" />
	/// <seealso cref="ISC_GetJogParamsBlock(char const * serialNo, MOT_JogParameters *jogParams)" />
	/// <seealso cref="ISC_SetJogParamsBlock(char const * serialNo, MOT_JogParameters *jogParams)" />
	/// <seealso cref="ISC_MoveJog(char const * serialNo, MOT_TravelDirection jogDirection)" />
    /// 		  \include CodeSnippet_jogpars.cpp
	ISC_API short __cdecl ISC_GetJogMode(char const * serialNo, MOT_JogModes * mode, MOT_StopModes * stopMode);

	/// <summary> Sets the jog mode. </summary>
	/// <remarks> see \ref C_MOTOR_sec12 "Jogging" for more detail.<remarks>
	/// <param name="serialNo">	The device serial no. </param>
	/// <param name="mode"> The jog mode.
	/// 					 <list type=table>
	///							<item><term>Jog step</term><term>1</term></item>
	///							<item><term>Continuous</term><term>2</term></item>
	/// 					 </list> </param>
	/// <param name="stopMode"> The StopMode.
	/// 					<list type=table>
	///							<item><term>Immediate Stop</term><term>1</term></item>
	///							<item><term>Profiled Stop</term><term>2</term></item>
	/// 					 </list>  </param>
	/// <returns> The error code (see \ref C_DLL_ERRORCODES_page "Error Codes") or zero if successful. </returns>
	/// <seealso cref="ISC_GetJogMode(char const * serialNo, MOT_JogModes * mode, MOT_StopModes * stopMode)" />
	/// <seealso cref="ISC_GetJogStepSize(char const * serialNo)" />
	/// <seealso cref="ISC_SetJogStepSize(char const * serialNo, unsigned int stepSize)" />
	/// <seealso cref="ISC_SetJogVelParams(char const * serialNo, int acceleration, int maxVelocity)" />
	/// <seealso cref="ISC_GetJogVelParams(char const * serialNo, int * acceleration, int * maxVelocity)" />
	/// <seealso cref="ISC_GetJogParamsBlock(char const * serialNo, MOT_JogParameters *jogParams)" />
	/// <seealso cref="ISC_SetJogParamsBlock(char const * serialNo, MOT_JogParameters *jogParams)" />
	/// <seealso cref="ISC_MoveJog(char const * serialNo, MOT_TravelDirection jogDirection)" />
    /// 		  \include CodeSnippet_jogpars.cpp
	ISC_API short __cdecl ISC_SetJogMode(char const * serialNo, MOT_JogModes mode, MOT_StopModes stopMode);

	/// <summary> Gets the distance to move when jogging. </summary>
	/// <remarks> see \ref C_MOTOR_sec12 "Jogging" for more detail.<remarks>
	/// <param name="serialNo">	The device serial no. </param>
	/// <returns> The step in \ref DeviceUnits_page. </returns>
	/// <seealso cref="ISC_RequestJogParams(char const * serialNo)" />
	/// <seealso cref="ISC_GetJogMode(char const * serialNo, MOT_JogModes * mode, MOT_StopModes * stopMode)" />
	/// <seealso cref="ISC_SetJogMode(char const * serialNo, MOT_JogModes mode, MOT_StopModes stopMode)" />
	/// <seealso cref="ISC_SetJogStepSize(char const * serialNo, unsigned int stepSize)" />
	/// <seealso cref="ISC_SetJogVelParams(char const * serialNo, int acceleration, int maxVelocity)" />
	/// <seealso cref="ISC_GetJogVelParams(char const * serialNo, int * acceleration, int * maxVelocity)" />
	/// <seealso cref="ISC_GetJogParamsBlock(char const * serialNo, MOT_JogParameters *jogParams)" />
	/// <seealso cref="ISC_SetJogParamsBlock(char const * serialNo, MOT_JogParameters *jogParams)" />
	/// <seealso cref="ISC_MoveJog(char const * serialNo, MOT_TravelDirection jogDirection)" />
    /// 		  \include CodeSnippet_jogpars.cpp
	ISC_API unsigned int __cdecl ISC_GetJogStepSize(char const * serialNo);

	/// <summary> Sets the distance to move on jogging. </summary>
	/// <remarks> see \ref C_MOTOR_sec12 "Jogging" for more detail.<remarks>
	/// <param name="serialNo">	The device serial no. </param>
	/// <param name="stepSize"> The step in \ref DeviceUnits_page. </param>
	/// <returns> The error code (see \ref C_DLL_ERRORCODES_page "Error Codes") or zero if successful. </returns>
	/// <seealso cref="ISC_GetJogMode(char const * serialNo, MOT_JogModes * mode, MOT_StopModes * stopMode)" />
	/// <seealso cref="ISC_SetJogMode(char const * serialNo, MOT_JogModes mode, MOT_StopModes stopMode)" />
	/// <seealso cref="ISC_GetJogStepSize(char const * serialNo)" />
	/// <seealso cref="ISC_SetJogVelParams(char const * serialNo, int acceleration, int maxVelocity)" />
	/// <seealso cref="ISC_GetJogVelParams(char const * serialNo, int * acceleration, int * maxVelocity)" />
	/// <seealso cref="ISC_GetJogParamsBlock(char const * serialNo, MOT_JogParameters *jogParams)" />
	/// <seealso cref="ISC_SetJogParamsBlock(char const * serialNo, MOT_JogParameters *jogParams)" />
	/// <seealso cref="ISC_MoveJog(char const * serialNo, MOT_TravelDirection jogDirection)" />
    /// 		  \include CodeSnippet_jogpars.cpp
	ISC_API short __cdecl ISC_SetJogStepSize(char const * serialNo, unsigned int stepSize);

	/// <summary> Gets the jog velocity parameters. </summary>
	/// <remarks> see \ref C_MOTOR_sec12 "Jogging" for more detail.<remarks>
	/// <param name="serialNo">	The device serial no. </param>
	/// <param name="acceleration"> Address of the parameter to receive the acceleration in \ref DeviceUnits_page. </param>
	/// <param name="maxVelocity"> Address of the parameter to receive the velocity in \ref DeviceUnits_page. </param>
	/// <returns> The error code (see \ref C_DLL_ERRORCODES_page "Error Codes") or zero if successful. </returns>
	/// <seealso cref="ISC_RequestJogParams(char const * serialNo)" />
	/// <seealso cref="ISC_GetJogMode(char const * serialNo, MOT_JogModes * mode, MOT_StopModes * stopMode)" />
	/// <seealso cref="ISC_SetJogMode(char const * serialNo, MOT_JogModes mode, MOT_StopModes stopMode)" />
	/// <seealso cref="ISC_GetJogStepSize(char const * serialNo)" />
	/// <seealso cref="ISC_SetJogStepSize(char const * serialNo, unsigned int stepSize)" />
	/// <seealso cref="ISC_SetJogVelParams(char const * serialNo, int acceleration, int maxVelocity)" />
	/// <seealso cref="ISC_GetJogParamsBlock(char const * serialNo, MOT_JogParameters *jogParams)" />
	/// <seealso cref="ISC_SetJogParamsBlock(char const * serialNo, MOT_JogParameters *jogParams)" />
	/// <seealso cref="ISC_MoveJog(char const * serialNo, MOT_TravelDirection jogDirection)" />
    /// 		  \include CodeSnippet_jogpars.cpp
	ISC_API short __cdecl ISC_GetJogVelParams(char const * serialNo, int * acceleration, int * maxVelocity);

	/// <summary> Sets jog velocity parameters. </summary>
	/// <remarks> see \ref C_MOTOR_sec12 "Jogging" for more detail.<remarks>
	/// <param name="serialNo">	The device serial no. </param>
	/// <param name="acceleration">   The acceleration in \ref DeviceUnits_page. </param>
	/// <param name="maxVelocity"> The maximum velocity in \ref DeviceUnits_page. </param>
	/// <returns> The error code (see \ref C_DLL_ERRORCODES_page "Error Codes") or zero if successful. </returns>
	/// <seealso cref="ISC_GetJogMode(char const * serialNo, MOT_JogModes * mode, MOT_StopModes * stopMode)" />
	/// <seealso cref="ISC_SetJogMode(char const * serialNo, MOT_JogModes mode, MOT_StopModes stopMode)" />
	/// <seealso cref="ISC_GetJogStepSize(char const * serialNo)" />
	/// <seealso cref="ISC_SetJogStepSize(char const * serialNo, unsigned int stepSize)" />
	/// <seealso cref="ISC_GetJogVelParams(char const * serialNo, int * acceleration, int * maxVelocity)" />
	/// <seealso cref="ISC_GetJogParamsBlock(char const * serialNo, MOT_JogParameters *jogParams)" />
	/// <seealso cref="ISC_SetJogParamsBlock(char const * serialNo, MOT_JogParameters *jogParams)" />
	/// <seealso cref="ISC_MoveJog(char const * serialNo, MOT_TravelDirection jogDirection)" />
    /// 		  \include CodeSnippet_jogpars.cpp
	ISC_API short __cdecl ISC_SetJogVelParams(char const * serialNo, int acceleration, int maxVelocity);

	/// <summary> Perform a jog. </summary>
	/// <remarks> see \ref C_MOTOR_sec12 "Jogging" for more detail.<remarks>
	/// <param name="serialNo">	The device serial no. </param>
	/// <param name="jogDirection"> The jog direction
	/// 					 <list type=table>
	///							<item><term>Forwards</term><term>1</term></item>
	///							<item><term>Backwards</term><term>2</term></item>
	/// 					 </list> </param>
	/// <returns> The error code (see \ref C_DLL_ERRORCODES_page "Error Codes") or zero if successful. </returns>
	/// <seealso cref="ISC_GetJogMode(char const * serialNo, MOT_JogModes * mode, MOT_StopModes * stopMode)" />
	/// <seealso cref="ISC_SetJogMode(char const * serialNo, MOT_JogModes mode, MOT_StopModes stopMode)" />
	/// <seealso cref="ISC_GetJogStepSize(char const * serialNo)" />
	/// <seealso cref="ISC_SetJogStepSize(char const * serialNo, unsigned int stepSize)" />
	/// <seealso cref="ISC_SetJogVelParams(char const * serialNo, int acceleration, int maxVelocity)" />
	/// <seealso cref="ISC_GetJogVelParams(char const * serialNo, int * acceleration, int * maxVelocity)" />
	/// <seealso cref="ISC_GetJogParamsBlock(char const * serialNo, MOT_JogParameters *jogParams)" />
	/// <seealso cref="ISC_SetJogParamsBlock(char const * serialNo, MOT_JogParameters *jogParams)" />
    /// 		  \include CodeSnippet_jog.cpp
	ISC_API short __cdecl ISC_MoveJog(char const * serialNo, MOT_TravelDirection jogDirection);

	/// <summary> Requests the velocity parameters. </summary>
	/// <param name="serialNo"> The serial no. </param>
	/// <returns> The error code (see \ref C_DLL_ERRORCODES_page "Error Codes") or zero if successful. </returns>
	/// <seealso cref="ISC_GetVelParams(char const * serialNo, int * acceleration, int * maxVelocity)" />
	/// <seealso cref="ISC_GetVelParamsBlock(char const * serialNo, MOT_VelocityParameters  *velocityParams)" />
	ISC_API short __cdecl ISC_RequestVelParams(char const * serialNo);

	/// <summary> Gets the move velocity parameters. </summary>
	/// <remarks> see \ref C_MOTOR_sec11 "Positioning" for more detail.<remarks>
	/// <param name="serialNo">	The device serial no. </param>
	/// <param name="acceleration"> Address of the parameter to receive the acceleration value in \ref DeviceUnits_page. </param>
	/// <param name="maxVelocity"> Address of the parameter to receive the maximum velocity value in \ref DeviceUnits_page. </param>
	/// <returns> The error code (see \ref C_DLL_ERRORCODES_page "Error Codes") or zero if successful. </returns>
	/// <seealso cref="ISC_SetVelParams(char const * serialNo, int acceleration, int maxVelocity)" />
	/// <seealso cref="ISC_RequestVelParams(char const * serialNo)" />
	/// <seealso cref="ISC_GetVelParamsBlock(char const * serialNo, MOT_VelocityParameters  *velocityParams)" />
	/// <seealso cref="ISC_SetVelParamsBlock(char const * serialNo, MOT_VelocityParameters *velocityParams)" />
	/// <seealso cref="ISC_MoveToPosition(char const * serialNo, int index)" />
	/// <seealso cref="ISC_MoveRelative(char const * serialNo, int displacement)" />
	/// <seealso cref="ISC_MoveAtVelocity(char const * serialNo, MOT_TravelDirection direction)" />
    /// 		  \include CodeSnippet_movepars.cpp
	ISC_API short __cdecl ISC_GetVelParams(char const * serialNo, int * acceleration, int * maxVelocity);

	/// <summary> Sets the move velocity parameters. </summary>
	/// <remarks> see \ref C_MOTOR_sec11 "Positioning" for more detail.<remarks>
	/// <param name="serialNo">	The device serial no. </param>
	/// <param name="acceleration"> The new acceleration value in \ref DeviceUnits_page. </param>
	/// <param name="maxVelocity"> The new maximum velocity value in \ref DeviceUnits_page. </param>
	/// <returns> The error code (see \ref C_DLL_ERRORCODES_page "Error Codes") or zero if successful. </returns>
	/// <seealso cref="ISC_GetVelParams(char const * serialNo, int * acceleration, int * maxVelocity)" />
	/// <seealso cref="ISC_GetVelParamsBlock(char const * serialNo, MOT_VelocityParameters  *velocityParams)" />
	/// <seealso cref="ISC_SetVelParamsBlock(char const * serialNo, MOT_VelocityParameters *velocityParams)" />
	/// <seealso cref="ISC_MoveToPosition(char const * serialNo, int index)" />
	/// <seealso cref="ISC_MoveRelative(char const * serialNo, int displacement)" />
	/// <seealso cref="ISC_MoveAtVelocity(char const * serialNo, MOT_TravelDirection direction)" />
    /// 		  \include CodeSnippet_movepars.cpp
	ISC_API short __cdecl ISC_SetVelParams(char const * serialNo, int acceleration, int maxVelocity);

	/// <summary> Start moving at the current velocity in the specified direction. </summary>
	/// <remarks> see \ref C_MOTOR_sec11 "Positioning" for more detail.<remarks>
	/// <param name="serialNo">	The device serial no. </param>
	/// <param name="direction"> The required direction of travel.
	/// 					 <list type=table>
	///							<item><term>Forwards</term><term>1</term></item>
	///							<item><term>Backwards</term><term>2</term></item>
	/// 					 </list> </param>
	/// <returns> The error code (see \ref C_DLL_ERRORCODES_page "Error Codes") or zero if successful. </returns>
	/// <seealso cref="ISC_GetVelParams(char const * serialNo, int * acceleration, int * maxVelocity)" />
	/// <seealso cref="ISC_SetVelParams(char const * serialNo, int acceleration, int maxVelocity)" />
	/// <seealso cref="ISC_GetVelParamsBlock(char const * serialNo, MOT_VelocityParameters  *velocityParams)" />
	/// <seealso cref="ISC_SetVelParamsBlock(char const * serialNo, MOT_VelocityParameters *velocityParams)" />
	/// <seealso cref="ISC_MoveToPosition(char const * serialNo, int index)" />
	/// <seealso cref="ISC_MoveRelative(char const * serialNo, int displacement)" />
    /// 		  \include CodeSnippet_move.cpp
	ISC_API short __cdecl ISC_MoveAtVelocity(char const * serialNo, MOT_TravelDirection direction);

	/// <summary> Sets the motor direction sense. </summary>
	/// <remarks> This function is used because some actuators use have directions of motion reversed.<br />
	/// 		  This parameter will tell the system to reverse the direction sense whnd moving, jogging etc. </remarks>
	/// <param name="serialNo">	The device serial no. </param>
	/// <param name="reverse"> if  <c>true</c> then directions will be swapped on these moves. </param>
	ISC_API void __cdecl ISC_SetDirection(char const * serialNo, bool reverse);

	/// <summary> Stop the current move immediately (with risk of losing track of position). </summary>
	/// <param name="serialNo">	The device serial no. </param>
	/// <returns> The error code (see \ref C_DLL_ERRORCODES_page "Error Codes") or zero if successful. </returns>
	/// <seealso cref="ISC_StopProfiled(char const * serialNo)" />
	ISC_API short __cdecl ISC_StopImmediate(char const * serialNo);

	/// <summary> Stop the current move using the current velocity profile. </summary>
	/// <param name="serialNo">	The device serial no. </param>
	/// <returns> The error code (see \ref C_DLL_ERRORCODES_page "Error Codes") or zero if successful. </returns>
	/// <seealso cref="ISC_StopImmediate(char const * serialNo)" />
	ISC_API short __cdecl ISC_StopProfiled(char const * serialNo);

	/// <summary> Requests the backlash. </summary>
	/// <param name="serialNo"> The serial no. </param>
	/// <returns> The error code (see \ref C_DLL_ERRORCODES_page "Error Codes") or zero if successful. </returns>
	/// <seealso cref="ISC_GetBacklash(char const * serialNo)" />
	/// <seealso cref="ISC_SetBacklash(char const * serialNo, long distance)" />
	ISC_API short __cdecl ISC_RequestBacklash(char const * serialNo);

	/// <summary> Get the backlash distance setting (used to control hysteresis). </summary>
	/// <param name="serialNo"> The device serial no. </param>
	/// <returns> The backlash distance in \ref DeviceUnits_page. </returns>
	/// <seealso cref="ISC_RequestBacklash(char const * serialNo)" />
	/// <seealso cref="ISC_SetBacklash(char const * serialNo, long distance)" />
	ISC_API long __cdecl ISC_GetBacklash(char const * serialNo);

	/// <summary> Sets the backlash distance (used to control hysteresis). </summary>
	/// <param name="serialNo">  The serial no. </param>
	/// <param name="distance"> The distance in \ref DeviceUnits_page. </param>
	/// <returns> The error code (see \ref C_DLL_ERRORCODES_page "Error Codes") or zero if successful. </returns>
	/// <seealso cref="ISC_RequestBacklash(char const * serialNo)" />
	/// <seealso cref="ISC_GetBacklash(char const * serialNo)" />
	ISC_API short __cdecl ISC_SetBacklash(char const * serialNo, long distance);

	/// <summary> Get the Position Counter. </summary>
	/// <remarks> The position counter is identical to the position parameter.<br />
	/// 		  The position counter is set to zero when homing is complete.<br />
	/// 		  The position counter can also be set using <see cref="ISC_SetPositionCounter(char const * serialNo, short channel, long count)" /> <br />
	/// 		  if homing is not to be perforned</remarks>
	/// <param name="serialNo">	The device serial no. </param>
	/// <returns> Position Counter in \ref DeviceUnits_page. </returns>
	/// <seealso cref="ISC_GetPosition(char const * serialNo)" />
	/// <seealso cref="ISC_SetPositionCounter(char const * serialNo, long count)" />
	ISC_API long __cdecl ISC_GetPositionCounter(char const * serialNo);

	/// <summary> Set the Position Counter. </summary>
	/// <remarks> Setting the position counter will locate the current position. <br />
	/// 		  Setting the position counter will effectively define the home position of a motor. </remarks>
	/// <param name="serialNo">	The device serial no. </param>
	/// <param name="count"> Position count in \ref DeviceUnits_page. </param>
	/// <returns> The error code (see \ref C_DLL_ERRORCODES_page "Error Codes") or zero if successful. </returns>
	/// <seealso cref="ISC_GetPositionCounter(char const * serialNo)" />
	/// <seealso cref="ISC_GetPosition(char const * serialNo)" />
	ISC_API short __cdecl ISC_SetPositionCounter(char const * serialNo, long count);

	/// <summary> Requests the limit switch parameters. </summary>
	/// <param name="serialNo"> The serial no. </param>
	/// <returns> The error code (see \ref C_DLL_ERRORCODES_page "Error Codes") or zero if successful. </returns>
	/// <seealso cref="ISC_GetLimitSwitchParams(char const * serialNo, MOT_LimitSwitchModes * clockwiseHardwareLimit, MOT_LimitSwitchModes * anticlockwiseHardwareLimit, unsigned int * clockwisePosition, unsigned int * anticlockwisePosition, MOT_LimitSwitchSWModes * softLimitMode)" />
	/// <seealso cref="ISC_GetLimitSwitchParamsBlock(const char * serialNo, MOT_LimitSwitchParameters *limitSwitchParams)" />
	ISC_API short __cdecl ISC_RequestLimitSwitchParams(char const * serialNo);

	/// <summary> Gets the limit switch parameters. </summary>
	/// <param name="serialNo">	The device serial no. </param>
	/// <param name="clockwiseHardwareLimit"> The clockwise hardware limit mode.
	/// 					<list type=table>
	///							<item><term> Ignore switch or switch not present. </term><term>1</term></item>
	///							<item><term> Switch makes on contact. </term><term>2</term></item>
	///							<item><term> Switch breaks on contact. </term><term>3</term></item>
	/// 					 </list> <remarks> If these are bitwise-ORed with 0x0080 then the limits are swapped. </remarks> </param>
	/// <param name="anticlockwiseHardwareLimit"> The anticlockwise hardware limit mode
	/// 					 <list type=table>
	///							<item><term> Ignore switch or switch not present. </term><term>1</term></item>
	///							<item><term> Switch makes on contact. </term><term>2</term></item>
	///							<item><term> Switch breaks on contact. </term><term>3</term></item>
	/// 					 </list> <remarks> If these are bitwise-ORed with 0x0080 then the limits are swapped. </remarks> </param>
	/// 
	/// <param name="clockwisePosition"> The poition of the clockwise software limit in \ref DeviceUnits_page. </param>
	/// <param name="anticlockwisePosition"> The position of the anticlockwise software limit in \ref DeviceUnits_page. </param>
	/// <param name="softLimitMode"> The soft limit mode
	/// 					 <list type=table>
	///							<item><term> Ignore limit. </term><term>1</term></item>
	///							<item><term> Immediate Stop. </term><term>2</term></item>
	///							<item><term> SProfiled stop. </term><term>3</term></item>
	/// 					 </list> <remarks> If these are bitwise-ORed with 0x0080 then the limits are swapped. </remarks> </param>
	/// <returns> The error code (see \ref C_DLL_ERRORCODES_page "Error Codes") or zero if successful. </returns>
	/// <seealso cref="ISC_SetLimitSwitchParams(char const * serialNo, MOT_LimitSwitchModes clockwiseHardwareLimit, MOT_LimitSwitchModes anticlockwiseHardwareLimit, unsigned int clockwisePosition, unsigned int anticlockwisePosition, MOT_LimitSwitchSWModes softLimitMode)" />
	/// <seealso cref="ISC_SetLimitSwitchParamsBlock(const char * serialNo, MOT_LimitSwitchParameters *limitSwitchParams)" />
	/// <seealso cref="ISC_RequestLimitSwitchParams(char const * serialNo)" />
	/// <seealso cref="ISC_GetLimitSwitchParamsBlock(const char * serialNo, MOT_LimitSwitchParameters *limitSwitchParams)" />
	ISC_API short __cdecl ISC_GetLimitSwitchParams(char const * serialNo, MOT_LimitSwitchModes * clockwiseHardwareLimit, MOT_LimitSwitchModes * anticlockwiseHardwareLimit, unsigned int * clockwisePosition, unsigned int * anticlockwisePosition, MOT_LimitSwitchSWModes * softLimitMode);

	/// <summary> Sets the limit switch parameters. </summary>
	/// <param name="serialNo">	The device serial no. </param>
	/// <param name="clockwiseHardwareLimit"> The clockwise hardware limit mode.
	/// 					<list type=table>
	///							<item><term> Ignore switch or switch not present. </term><term>1</term></item>
	///							<item><term> Switch makes on contact. </term><term>2</term></item>
	///							<item><term> Switch breaks on contact. </term><term>3</term></item>
	/// 					 </list> <remarks> If these are bitwise-ORed with 0x0080 then the limits are swapped. </remarks> </param>
	/// <param name="anticlockwiseHardwareLimit"> The anticlockwise hardware limit mode
	/// 					 <list type=table>
	///							<item><term> Ignore switch or switch not present. </term><term>1</term></item>
	///							<item><term> Switch makes on contact. </term><term>2</term></item>
	///							<item><term> Switch breaks on contact. </term><term>3</term></item>
	/// 					 </list> <remarks> If these are bitwise-ORed with 0x0080 then the limits are swapped. </remarks> </param>
	/// 
	/// <param name="clockwisePosition"> The poition of the clockwise software limit in \ref DeviceUnits_page. </param>
	/// <param name="anticlockwisePosition"> The position of the anticlockwise software limit in \ref DeviceUnits_page. </param>
	/// <param name="softLimitMode"> The soft limit mode
	/// 					 <list type=table>
	///							<item><term> Ignore limit. </term><term>1</term></item>
	///							<item><term> Immediate Stop. </term><term>2</term></item>
	///							<item><term> SProfiled stop. </term><term>3</term></item>
	/// 					 </list> <remarks> If these are bitwise-ORed with 0x0080 then the limits are swapped. </remarks> </param>
	/// <returns> The error code (see \ref C_DLL_ERRORCODES_page "Error Codes") or zero if successful. </returns>
	/// <seealso cref="ISC_RequestLimitSwitchParams(char const * serialNo)" />
	/// <seealso cref="ISC_GetLimitSwitchParams(char const * serialNo, MOT_LimitSwitchModes * clockwiseHardwareLimit, MOT_LimitSwitchModes * anticlockwiseHardwareLimit, unsigned int * clockwisePosition, unsigned int * anticlockwisePosition, MOT_LimitSwitchSWModes * softLimitMode)" />
	/// <seealso cref="ISC_SetLimitSwitchParamsBlock(const char * serialNo, MOT_LimitSwitchParameters *limitSwitchParams)" />
	/// <seealso cref="ISC_GetLimitSwitchParamsBlock(const char * serialNo, MOT_LimitSwitchParameters *limitSwitchParams)" />
	ISC_API short __cdecl ISC_SetLimitSwitchParams(char const * serialNo, MOT_LimitSwitchModes clockwiseHardwareLimit, MOT_LimitSwitchModes anticlockwiseHardwareLimit, unsigned int clockwisePosition, unsigned int anticlockwisePosition, MOT_LimitSwitchSWModes softLimitMode);

	/// <summary> Gets the software limits mode. </summary>
	/// <param name="serialNo">	The device serial no. </param>
	/// <returns>	The software limits mode <list type=table>
	///							<item><term> Disable any move outside travel range. </term><term>0</term></item>
	///							<item><term> Disable any move outside travel range, but allow moves 'just beyond limit' to be truncated to limit. </term><term>1</term></item>
	///							<item><term> Truncate all moves beyond limit to the current limit. </term><term>2</term></item>
	///							<item><term> Allow all moves, illegal or not. </term><term>3</term></item>
	/// 		  </list>. </returns>
	/// <returns> The software limits mode. </returns>
	/// <seealso cref="ISC_SetLimitsSoftwareApproachPolicy(const char * serialNo, MOT_LimitsSoftwareApproachPolicy limitsSoftwareApproachPolicy)" />
	ISC_API MOT_LimitsSoftwareApproachPolicy __cdecl ISC_GetSoftLimitMode(char const * serialNo);

	/// <summary> Sets the software limits mode. </summary>
	/// <param name="serialNo">	The device serial no. </param>
	/// <param name="limitsSoftwareApproachPolicy"> The soft limit mode
	/// 					 <list type=table>
	///							<item><term> Disable any move outside travel range. </term><term>0</term></item>
	///							<item><term> Disable any move outside travel range, but allow moves 'just beyond limit' to be truncated to limit. </term><term>1</term></item>
	///							<item><term> Truncate all moves beyond limit to the current limit. </term><term>2</term></item>
	///							<item><term> Allow all moves, illegal or not. </term><term>3</term></item>
	/// 					 </list> <remarks> If these are bitwise-ORed with 0x0080 then the limits are swapped. </remarks> </param>
	/// <seealso cref="ISC_GetSoftLimitMode(const char * serialNo)" />
	ISC_API void __cdecl ISC_SetLimitsSoftwareApproachPolicy(char const * serialNo, MOT_LimitsSoftwareApproachPolicy limitsSoftwareApproachPolicy);

	// Button Parameters

	/// <summary> Requests the LTS button parameters. </summary>
	/// <param name="serialNo"> The serial no. </param>
	/// <returns> The error code (see \ref C_DLL_ERRORCODES_page "Error Codes") or zero if successful. </returns>
	/// <seealso cref="ISC_GetButtonParams(char const * serialNo, MOT_ButtonModes * buttonMode, int * leftButtonPosition, int * rightButtonPosition, short * timeout)" />
	/// <seealso cref="ISC_SetButtonParams(char const * serialNo, MOT_ButtonModes buttonMode, int leftButtonPosition, int rightButtonPosition)" />
	/// <seealso cref="ISC_GetButtonParamsBlock(const char * serialNo, MOT_ButtonParameters *buttonParams)" />
	/// <seealso cref="ISC_SetButtonParamsBlock(const char * serialNo, MOT_ButtonParameters *buttonParams)" />
	ISC_API short __cdecl ISC_RequestButtonParams(char const * serialNo);

	/// <summary> Gets the LTS button parameters. </summary>
	/// <param name="serialNo">	The device serial no. </param>
	/// <param name="buttonMode">	Address of the parameter to receive the button mode.
	/// 					<list type=table>
	///							<item><term> Jogging Mode. </term><term>1</term></item>
	///							<item><term> Preset Mode. </term><term>2</term></item>
	/// 					 </list> </param>
	/// <param name="leftButtonPosition">  Address of the parameter to receive the Preset position in \ref DeviceUnits_page for the left button (when in preset mode). </param>
	/// <param name="rightButtonPosition"> Address of the parameter to receive the Preset position in \ref DeviceUnits_page for the right button (when in preset mode). </param>
	/// <param name="timeout"> The time that buttons need to be pressed in order to go home or to recored a preset buttons defined position. </param>
	/// <returns> The error code (see \ref C_DLL_ERRORCODES_page "Error Codes") or zero if successful. </returns>
	/// <seealso cref="ISC_SetButtonParams(char const * serialNo, MOT_ButtonModes buttonMode, int leftButtonPosition, int rightButtonPosition)" />
	/// <seealso cref="ISC_SetButtonParamsBlock(const char * serialNo, MOT_ButtonParameters *buttonParams)" />
	/// <seealso cref="ISC_RequestButtonParams(char const * serialNo)" />
	/// <seealso cref="ISC_GetButtonParamsBlock(const char * serialNo, MOT_ButtonParameters *buttonParams)" />
	ISC_API short __cdecl ISC_GetButtonParams(char const * serialNo, MOT_ButtonModes * buttonMode, int * leftButtonPosition, int * rightButtonPosition, short * timeout);

	/// <summary> Sets the LTS button parameters. </summary>
	/// <param name="serialNo">	The device serial no. </param>
	/// <param name="buttonMode">	The button mode.
	/// 					<list type=table>
	///							<item><term> Jogging Mode. </term><term>1</term></item>
	///							<item><term> Preset Mode. </term><term>2</term></item>
	/// 					 </list> </param>
	/// <param name="leftButtonPosition">  The Preset position in \ref DeviceUnits_page for the left button (when in preset mode). </param>
	/// <param name="rightButtonPosition"> The Preset position in \ref DeviceUnits_page for the right button (when in preset mode). </param>
	/// <returns> The error code (see \ref C_DLL_ERRORCODES_page "Error Codes") or zero if successful. </returns>
	/// <seealso cref="ISC_RequestButtonParams(char const * serialNo)" />
	/// <seealso cref="ISC_GetButtonParams(char const * serialNo, MOT_ButtonModes * buttonMode, int * leftButtonPosition, int * rightButtonPosition, short * timeout)" />
	/// <seealso cref="ISC_SetButtonParamsBlock(const char * serialNo, MOT_ButtonParameters *buttonParams)" />
	/// <seealso cref="ISC_GetButtonParamsBlock(const char * serialNo, MOT_ButtonParameters *buttonParams)" />
	ISC_API short __cdecl ISC_SetButtonParams(char const * serialNo, MOT_ButtonModes buttonMode, int leftButtonPosition, int rightButtonPosition);

	/// <summary> Requests the potentiometer parameters. </summary>
	/// <param name="serialNo"> The serial no. </param>
	/// <returns> The error code (see \ref C_DLL_ERRORCODES_page "Error Codes") or zero if successful. </returns>
	/// <seealso cref="ISC_GetPotentiometerParams(char const * serialNo, short index, WORD * thresholdDeflection, DWORD * velocity)" />
	/// <seealso cref="ISC_SetPotentiometerParams(char const * serialNo, short index, WORD thresholdDeflection, DWORD velocity)" />
	ISC_API short __cdecl ISC_RequestPotentiometerParams(char const * serialNo);

	/// <summary> Gets the potentiometer parameters for the LTS. </summary>
	/// <param name="serialNo">	The device serial no. </param>
	/// <param name="index">	The potentiometer index to be read. </param>
	/// <param name="thresholdDeflection"> Address of the parameter to recieve the potentiometer threshold, range 0 to 127. </param>
	/// <param name="velocity"> Address of the parameter to recieve the velocity in \ref DeviceUnits_page for the current potentiometer threshold. </param>
	/// <returns> The error code (see \ref C_DLL_ERRORCODES_page "Error Codes") or zero if successful. </returns>
	/// <seealso cref="ISC_RequestPotentiometerParams(char const * serialNo)" />
	/// <seealso cref="ISC_SetPotentiometerParams(char const * serialNo, short index, WORD thresholdDeflection, DWORD velocity)" />
	ISC_API short __cdecl ISC_GetPotentiometerParams(char const * serialNo, short index, WORD * thresholdDeflection, DWORD * velocity);

	/// <summary> Sets the potentiometer parameters for the LTS. </summary>
	/// <param name="serialNo">	The device serial no. </param>
	/// <param name="index">	The potentiometer index to be stored. </param>
	/// <param name="thresholdDeflection"> The potentiometer threshold, range 0 to 127. </param>
	/// <param name="velocity"> The velocity in \ref DeviceUnits_page for the current potentiometer threshold. </param>
	/// <returns> The error code (see \ref C_DLL_ERRORCODES_page "Error Codes") or zero if successful. </returns>
	/// <seealso cref="ISC_RequestPotentiometerParams(char const * serialNo)" />
	/// <seealso cref="ISC_GetPotentiometerParams(char const * serialNo, short index, WORD * thresholdDeflection, DWORD * velocity)" />
	ISC_API short __cdecl ISC_SetPotentiometerParams(char const * serialNo, short index, WORD thresholdDeflection, DWORD velocity);


	/// <summary> Get the move velocity parameters. </summary>
	/// <remarks> see \ref C_MOTOR_sec11 "Positioning" for more detail.<remarks>
	/// <param name="serialNo">	The device serial no. </param>
	/// <param name="velocityParams"> Address of the MOT_VelocityParameters to recieve the velocity parameters. </param>
	/// <returns> The error code (see \ref C_DLL_ERRORCODES_page "Error Codes") or zero if successful. </returns>
	/// <seealso cref="ISC_RequestVelParams(char const * serialNo)" />
	/// <seealso cref="ISC_GetVelParams(char const * serialNo, int * acceleration, int * maxVelocity)" />
	/// <seealso cref="ISC_SetVelParams(char const * serialNo, int acceleration, int maxVelocity)" />
	/// <seealso cref="ISC_SetVelParamsBlock(char const * serialNo, MOT_VelocityParameters *velocityParams)" />
	/// <seealso cref="ISC_MoveToPosition(char const * serialNo, int index)" />
	/// <seealso cref="ISC_MoveRelative(char const * serialNo, int displacement)" />
	/// <seealso cref="ISC_MoveAtVelocity(char const * serialNo, MOT_TravelDirection direction)" />
    /// 		  \include CodeSnippet_movepars.cpp
	ISC_API short __cdecl ISC_GetVelParamsBlock(const char * serialNo, MOT_VelocityParameters  *velocityParams);

	/// <summary> Set the move velocity parameters. </summary>
	/// <remarks> see \ref C_MOTOR_sec11 "Positioning" for more detail.<remarks>
	/// <param name="serialNo">	The device serial no. </param>
	/// <param name="velocityParams"> The address of the MOT_VelocityParameters holding the new velocity parameters. </param>
	/// <returns> The error code (see \ref C_DLL_ERRORCODES_page "Error Codes") or zero if successful. </returns>
	/// <seealso cref="ISC_GetVelParams(char const * serialNo, int * acceleration, int * maxVelocity)" />
	/// <seealso cref="ISC_SetVelParams(char const * serialNo, int acceleration, int maxVelocity)" />
	/// <seealso cref="ISC_GetVelParamsBlock(char const * serialNo, MOT_VelocityParameters  *velocityParams)" />
	/// <seealso cref="ISC_MoveToPosition(char const * serialNo, int index)" />
	/// <seealso cref="ISC_MoveRelative(char const * serialNo, int displacement)" />
	/// <seealso cref="ISC_MoveAtVelocity(char const * serialNo, MOT_TravelDirection direction)" />
    /// 		  \include CodeSnippet_movepars.cpp
	ISC_API short __cdecl ISC_SetVelParamsBlock(const char * serialNo, MOT_VelocityParameters *velocityParams);

	/// <summary> Sets the move absolute position. </summary>
	/// <param name="serialNo">	The device serial no. </param>
	/// <param name="position"> The absolute position in \ref DeviceUnits_page. </param>
	/// <returns> The error code (see \ref C_DLL_ERRORCODES_page "Error Codes") or zero if successful. </returns>
	/// <seealso cref="ISC_RequestMoveAbsolutePosition(char const * serialNo)" />
	/// <seealso cref="ISC_GetMoveAbsolutePosition(const char * serialNo)" />
	/// <seealso cref="ISC_MoveAbsolute(const char * serialNo)" />
	ISC_API short __cdecl ISC_SetMoveAbsolutePosition(const char * serialNo, int position);

	/// <summary> Requests the position of next absolute move. </summary>
	/// <param name="serialNo"> The serial no. </param>
	/// <returns> The error code (see \ref C_DLL_ERRORCODES_page "Error Codes") or zero if successful. </returns>
	/// <seealso cref="ISC_GetMoveAbsolutePosition(const char * serialNo)" />
	/// <seealso cref="ISC_SetMoveAbsolutePosition(const char * serialNo, int position)" />
	/// <seealso cref="ISC_MoveAbsolute(const char * serialNo)" />
	ISC_API short __cdecl ISC_RequestMoveAbsolutePosition(char const * serialNo);

	/// <summary> Gets the move absolute position. </summary>
	/// <param name="serialNo">	The device serial no. </param>
	/// <returns> The move absolute position in \ref DeviceUnits_page. </returns>
	/// <seealso cref="ISC_RequestMoveAbsolutePosition(char const * serialNo)" />
	/// <seealso cref="ISC_SetMoveAbsolutePosition(const char * serialNo, int position)" />
	/// <seealso cref="ISC_MoveAbsolute(const char * serialNo)" />
	ISC_API int __cdecl ISC_GetMoveAbsolutePosition(const char * serialNo);

	/// <summary> Moves the device to the position defined in the SetMoveAbsolute command. </summary>
	/// <param name="serialNo">	The device serial no. </param>
	/// <returns> The error code (see \ref C_DLL_ERRORCODES_page "Error Codes") or zero if successful. </returns>
	/// <seealso cref="ISC_RequestMoveAbsolutePosition(char const * serialNo)" />
	/// <seealso cref="ISC_SetMoveAbsolutePosition(const char * serialNo, int position)" />
	/// <seealso cref="ISC_GetMoveAbsolutePosition(const char * serialNo)" />
	ISC_API short __cdecl ISC_MoveAbsolute(const char * serialNo);

	/// <summary> Sets the move relative distance. </summary>
	/// <param name="serialNo">	The device serial no. </param>
	/// <param name="distance"> The relative distance in \ref DeviceUnits_page. </param>
	/// <returns> The error code (see \ref C_DLL_ERRORCODES_page "Error Codes") or zero if successful. </returns>
	/// <seealso cref="ISC_RequestMoveRelativeDistance(char const * serialNo)" />
	/// <seealso cref="ISC_GetMoveRelativeDistance(const char * serialNo)" />
	/// <seealso cref="ISC_MoveRelativeDistance(const char * serialNo)" />
	ISC_API short __cdecl ISC_SetMoveRelativeDistance(const char * serialNo, int distance);

	/// <summary> Requests the relative move distance. </summary>
	/// <param name="serialNo"> The serial no. </param>
	/// <returns> The error code (see \ref C_DLL_ERRORCODES_page "Error Codes") or zero if successful. </returns>
	/// <seealso cref="ISC_GetMoveRelativeDistance(const char * serialNo)" />
	/// <seealso cref="ISC_SetMoveRelativeDistance(const char * serialNo, int distance)" />
	/// <seealso cref="ISC_MoveRelativeDistance(const char * serialNo)" />
	ISC_API short __cdecl ISC_RequestMoveRelativeDistance(char const * serialNo);

	/// <summary> Gets the move relative distance. </summary>
	/// <param name="serialNo">	The device serial no. </param>
	/// <returns> The move relative distance in \ref DeviceUnits_page. </returns>
	/// <seealso cref="ISC_RequestMoveRelativeDistance(char const * serialNo)" />
	/// <seealso cref="ISC_SetMoveRelativeDistance(const char * serialNo, int distance)" />
	/// <seealso cref="ISC_MoveRelativeDistance(const char * serialNo)" />
	ISC_API int __cdecl ISC_GetMoveRelativeDistance(const char * serialNo);

	/// <summary> Moves the device by a relative distancce defined by SetMoveRelativeDistance. </summary>
	/// <param name="serialNo">	The device serial no. </param>
	/// <returns> The error code (see \ref C_DLL_ERRORCODES_page "Error Codes") or zero if successful. </returns>
	/// <seealso cref="ISC_RequestMoveRelativeDistance(char const * serialNo)" />
	/// <seealso cref="ISC_SetMoveRelativeDistance(const char * serialNo, int distance)" />
	/// <seealso cref="ISC_GetMoveRelativeDistance(const char * serialNo)" />
	ISC_API short __cdecl ISC_MoveRelativeDistance(const char * serialNo);

	/// <summary> Get the homing parameters. </summary>
	/// <remarks> see \ref C_MOTOR_sec10 "Homing" for more detail.<remarks>
	/// <param name="serialNo"> The device serial no. </param>
	/// <param name="homingParams"> Address of the MOT_HomingParameters to recieve the homing parameters. </param>
	/// <returns> The error code (see \ref C_DLL_ERRORCODES_page "Error Codes") or zero if successful. </returns>
	/// <seealso cref="ISC_RequestHomingParams(char const * serialNo)" />
	/// <seealso cref="ISC_GetHomingVelocity(char const * serialNo)" />
	/// <seealso cref="ISC_SetHomingVelocity(char const * serialNo, unsigned int velocity)" />
	/// <seealso cref="ISC_SetHomingParamsBlock(char const * serialNo, MOT_HomingParameters *homingParams)" />
	ISC_API short __cdecl ISC_GetHomingParamsBlock(const char * serialNo, MOT_HomingParameters *homingParams);

	/// <summary> Set the homing parameters. </summary>
	/// <remarks> see \ref C_MOTOR_sec10 "Homing" for more detail.<remarks>
	/// <param name="serialNo"> The device serial no. </param>
	/// <param name="homingParams"> Address of the new homing parameters. </param>
	/// <returns> The error code (see \ref C_DLL_ERRORCODES_page "Error Codes") or zero if successful. </returns>
	/// <seealso cref="ISC_RequestHomingParams(char const * serialNo)" />
	/// <seealso cref="ISC_GetHomingVelocity(char const * serialNo)" />
	/// <seealso cref="ISC_SetHomingVelocity(char const * serialNo, unsigned int velocity)" />
	/// <seealso cref="ISC_GetHomingParamsBlock(char const * serialNo, MOT_HomingParameters *homingParams)" />
	ISC_API short __cdecl ISC_SetHomingParamsBlock(const char * serialNo, MOT_HomingParameters *homingParams);

	/// <summary> Get the jog parameters. </summary>
	/// <remarks> see \ref C_MOTOR_sec12 "Jogging" for more detail.<remarks>
	/// <param name="serialNo">  The device serial no. </param>
	/// <param name="jogParams"> The address of the MOT_JogParameters block to recieve the jog parameters </param>
	/// <returns> The error code (see \ref C_DLL_ERRORCODES_page "Error Codes") or zero if successful. </returns>
	/// <seealso cref="ISC_RequestJogParams(char const * serialNo)" />
	/// <seealso cref="ISC_GetJogMode(char const * serialNo, MOT_JogModes * mode, MOT_StopModes * stopMode)" />
	/// <seealso cref="ISC_SetJogMode(char const * serialNo, MOT_JogModes mode, MOT_StopModes stopMode)" />
	/// <seealso cref="ISC_GetJogStepSize(char const * serialNo)" />
	/// <seealso cref="ISC_SetJogStepSize(char const * serialNo, unsigned int stepSize)" />
	/// <seealso cref="ISC_SetJogVelParams(char const * serialNo, int acceleration, int maxVelocity)" />
	/// <seealso cref="ISC_GetJogVelParams(char const * serialNo, int * acceleration, int * maxVelocity)" />
	/// <seealso cref="ISC_SetJogParamsBlock(char const * serialNo, MOT_JogParameters *jogParams)" />
	/// <seealso cref="ISC_MoveJog(char const * serialNo, MOT_TravelDirection jogDirection)" />
    /// 		  \include CodeSnippet_jogpars.cpp
	ISC_API short __cdecl ISC_GetJogParamsBlock(const char * serialNo, MOT_JogParameters *jogParams);

	/// <summary> Set the jog parameters. </summary>
	/// <remarks> see \ref C_MOTOR_sec12 "Jogging" for more detail.<remarks>
	/// <param name="serialNo"> The device serial no. </param>
	/// <param name="jogParams"> The address of the new MOT_JogParameters block. </param>
	/// <returns> The error code (see \ref C_DLL_ERRORCODES_page "Error Codes") or zero if successful. </returns>
	/// <seealso cref="ISC_GetJogMode(char const * serialNo, MOT_JogModes * mode, MOT_StopModes * stopMode)" />
	/// <seealso cref="ISC_SetJogMode(char const * serialNo, MOT_JogModes mode, MOT_StopModes stopMode)" />
	/// <seealso cref="ISC_GetJogStepSize(char const * serialNo)" />
	/// <seealso cref="ISC_SetJogStepSize(char const * serialNo, unsigned int stepSize)" />
	/// <seealso cref="ISC_SetJogVelParams(char const * serialNo, int acceleration, int maxVelocity)" />
	/// <seealso cref="ISC_GetJogVelParams(char const * serialNo, int * acceleration, int * maxVelocity)" />
	/// <seealso cref="ISC_GetJogParamsBlock(char const * serialNo, MOT_JogParameters *jogParams)" />
	/// <seealso cref="ISC_MoveJog(char const * serialNo, MOT_TravelDirection jogDirection)" />
    /// 		  \include CodeSnippet_jogpars.cpp
	ISC_API short __cdecl ISC_SetJogParamsBlock(const char * serialNo, MOT_JogParameters *jogParams);

	/// <summary> Get the limit switch parameters. </summary>
	/// <param name="serialNo"> The device serial no. </param>
	/// <param name="limitSwitchParams"> Address of the MOT_LimitSwitchParameters parameter to recieve the  limit switch parameters. </param>
	/// <returns> The error code (see \ref C_DLL_ERRORCODES_page "Error Codes") or zero if successful. </returns>
	/// <seealso cref="ISC_SetLimitSwitchParams(char const * serialNo, MOT_LimitSwitchModes clockwiseHardwareLimit, MOT_LimitSwitchModes anticlockwiseHardwareLimit, unsigned int clockwisePosition, unsigned int anticlockwisePosition, MOT_LimitSwitchSWModes softLimitMode)" />
	/// <seealso cref="ISC_RequestLimitSwitchParams(char const * serialNo)" />
	/// <seealso cref="ISC_GetLimitSwitchParams(char const * serialNo, MOT_LimitSwitchModes * clockwiseHardwareLimit, MOT_LimitSwitchModes * anticlockwiseHardwareLimit, unsigned int * clockwisePosition, unsigned int * anticlockwisePosition, MOT_LimitSwitchSWModes * softLimitMode)" />
	/// <seealso cref="ISC_SetLimitSwitchParamsBlock(const char * serialNo, MOT_LimitSwitchParameters *limitSwitchParams)" />
	ISC_API short __cdecl ISC_GetLimitSwitchParamsBlock(const char * serialNo, MOT_LimitSwitchParameters *limitSwitchParams);

	/// <summary> Set the limit switch parameters. </summary>
	/// <param name="serialNo"> The device serial no. </param>
	/// <param name="limitSwitchParams"> Address of the MOT_LimitSwitchParameters parameter containing the new limit switch parameters. </param>
	/// <returns> The error code (see \ref C_DLL_ERRORCODES_page "Error Codes") or zero if successful. </returns>
	/// <seealso cref="ISC_RequestLimitSwitchParams(char const * serialNo)" />
	/// <seealso cref="ISC_GetLimitSwitchParams(char const * serialNo, MOT_LimitSwitchModes * clockwiseHardwareLimit, MOT_LimitSwitchModes * anticlockwiseHardwareLimit, unsigned int * clockwisePosition, unsigned int * anticlockwisePosition, MOT_LimitSwitchSWModes * softLimitMode)" />
	/// <seealso cref="ISC_SetLimitSwitchParams(char const * serialNo, MOT_LimitSwitchModes clockwiseHardwareLimit, MOT_LimitSwitchModes anticlockwiseHardwareLimit, unsigned int clockwisePosition, unsigned int anticlockwisePosition, MOT_LimitSwitchSWModes softLimitMode)" />
	/// <seealso cref="ISC_GetLimitSwitchParamsBlock(const char * serialNo, MOT_LimitSwitchParameters *limitSwitchParams)" />
	ISC_API short __cdecl ISC_SetLimitSwitchParamsBlock(const char * serialNo, MOT_LimitSwitchParameters *limitSwitchParams);

	/// <summary> Get the button parameters. </summary>
	/// <param name="serialNo"> The device serial no. </param>
	/// <param name="buttonParams"> Address of the MOT_ButtonParameters parameter to recieve the button parameters. </param>
	/// <returns> The error code (see \ref C_DLL_ERRORCODES_page "Error Codes") or zero if successful. </returns>
	/// <seealso cref="ISC_SetButtonParamsBlock(const char * serialNo, MOT_ButtonParameters *buttonParams)" />
	/// <seealso cref="ISC_SetButtonParams(char const * serialNo, MOT_ButtonModes buttonMode, int leftButtonPosition, int rightButtonPosition)" />
	/// <seealso cref="ISC_RequestButtonParams(char const * serialNo)" />
	/// <seealso cref="ISC_GetButtonParams(char const * serialNo, MOT_ButtonModes * buttonMode, int * leftButtonPosition, int * rightButtonPosition, short * timeout)" />
	ISC_API short __cdecl ISC_GetButtonParamsBlock(const char * serialNo, MOT_ButtonParameters *buttonParams);

	/// <summary> Set the button parameters. </summary>
	/// <param name="serialNo"> The device serial no. </param>
	/// <param name="buttonParams"> Address of the MOT_ButtonParameters parameter containing the new button parameters. </param>
	/// <returns> The error code (see \ref C_DLL_ERRORCODES_page "Error Codes") or zero if successful. </returns>
	/// <seealso cref="ISC_RequestButtonParams(char const * serialNo)" />
	/// <seealso cref="ISC_GetButtonParamsBlock(const char * serialNo, MOT_ButtonParameters *buttonParams)" />
	/// <seealso cref="ISC_GetButtonParams(char const * serialNo, MOT_ButtonModes * buttonMode, int * leftButtonPosition, int * rightButtonPosition, short * timeout)" />
	/// <seealso cref="ISC_SetButtonParams(char const * serialNo, MOT_ButtonModes buttonMode, int leftButtonPosition, int rightButtonPosition)" />
	ISC_API short __cdecl ISC_SetButtonParamsBlock(const char * serialNo, MOT_ButtonParameters *buttonParams);

	/// <summary> Get the potentiometer parameters. </summary>
	/// <param name="serialNo"> The device serial no. </param>
	/// <param name="potentiometerSteps"> Address of the MOT_PotentiometerSteps parameter to recieve the potentiometer parameters. </param>
	/// <returns> The error code (see \ref C_DLL_ERRORCODES_page "Error Codes") or zero if successful. </returns>
	/// <seealso cref="ISC_SetPotentiometerParamsBlock(const char * serialNo, MOT_PotentiometerSteps *potentiometerSteps)" />
	/// <seealso cref="ISC_SetPotentiometerParams(char const * serialNo, short index, WORD thresholdDeflection, DWORD velocity)" />
	/// <seealso cref="ISC_RequestPotentiometerParams(char const * serialNo)" />
	/// <seealso cref="ISC_GetPotentiometerParams(char const * serialNo, short index, WORD * thresholdDeflection, DWORD * velocity)" />
	ISC_API short __cdecl ISC_GetPotentiometerParamsBlock(const char * serialNo, MOT_PotentiometerSteps *potentiometerSteps);

	/// <summary> Set the potentiometer parameters. </summary>
	/// <param name="serialNo"> The device serial no. </param>
	/// <param name="potentiometerSteps"> Address of the MOT_PotentiometerSteps parameter containing the new potentiometer parameters. </param>
	/// <returns> The error code (see \ref C_DLL_ERRORCODES_page "Error Codes") or zero if successful. </returns>
	/// <seealso cref="ISC_RequestPotentiometerParams(char const * serialNo)" />
	/// <seealso cref="ISC_GetPotentiometerParamsBlock(const char * serialNo, MOT_PotentiometerSteps *potentiometerSteps)" />
	/// <seealso cref="ISC_SetPotentiometerParams(char const * serialNo, short index, WORD thresholdDeflection, DWORD velocity)" />
	/// <seealso cref="ISC_GetPotentiometerParams(char const * serialNo, short index, WORD * thresholdDeflection, DWORD * velocity)" />
	ISC_API short __cdecl ISC_SetPotentiometerParamsBlock(const char * serialNo, MOT_PotentiometerSteps *potentiometerSteps);

	/// <summary> Requests the power parameters. </summary>
	/// <param name="serialNo"> The serial no. </param>
	/// <returns> The error code (see \ref C_DLL_ERRORCODES_page "Error Codes") or zero if successful. </returns>
	/// <seealso cref="ISC_GetPowerParams(const char * serialNo, MOT_PowerParameters *powerParams)" />
	/// <seealso cref="ISC_SetPowerParams(const char * serialNo, MOT_PowerParameters *powerParams)" />
	ISC_API short __cdecl ISC_RequestPowerParams(char const * serialNo);

	/// <summary> Gets the power parameters for the stepper motor. </summary>
	/// <param name="serialNo"> The device serial no. </param>
	/// <param name="powerParams"> Address of the MOT_PowerParameters parameter to recieve the power parameters. </param>
	/// <returns> The error code (see \ref C_DLL_ERRORCODES_page "Error Codes") or zero if successful. </returns>
	/// <seealso cref="ISC_RequestPowerParams(char const * serialNo)" />
	/// <seealso cref="ISC_SetPowerParams(const char * serialNo, MOT_PowerParameters *powerParams)" />
	ISC_API short __cdecl ISC_GetPowerParams(const char * serialNo, MOT_PowerParameters *powerParams);

	/// <summary> Sets the power parameters for the stepper motor. </summary>
	/// <param name="serialNo"> The device serial no. </param>
	/// <param name="powerParams"> Address of the MOT_PowerParameters parameter containing the new power parameters. </param>
	/// <returns> The error code (see \ref C_DLL_ERRORCODES_page "Error Codes") or zero if successful. </returns>
	/// <seealso cref="ISC_RequestPowerParams(char const * serialNo)" />
	/// <seealso cref="ISC_GetPowerParams(const char * serialNo, MOT_PowerParameters *powerParams)" />
	ISC_API short __cdecl ISC_SetPowerParams(const char * serialNo, MOT_PowerParameters *powerParams);

	/// <summary> Requests the stepper motor bow index. </summary>
	/// <param name="serialNo"> The serial no. </param>
	/// <returns> The error code (see \ref C_DLL_ERRORCODES_page "Error Codes") or zero if successful. </returns>
	/// <seealso cref="ISC_GetBowIndex(const char * serialNo)" />
	/// <seealso cref="ISC_SetBowIndex(const char * serialNo, short bowIndex)" />
	ISC_API short __cdecl ISC_RequestBowIndex(char const * serialNo);

	/// <summary> Gets the stepper motor bow index. </summary>
	/// <param name="serialNo"> The device serial no. </param>
	/// <returns> The bow index. </returns>
	/// <seealso cref="ISC_RequestBowIndex(char const * serialNo)" />
	/// <seealso cref="ISC_SetBowIndex(const char * serialNo, short bowIndex)" />
	ISC_API short __cdecl ISC_GetBowIndex(const char * serialNo);

	/// <summary> Sets the stepper motor bow index. </summary>
	/// <param name="serialNo"> The device serial no. </param>
	/// <param name="bowIndex"> The bow index. </param>
	/// <returns> The error code (see \ref C_DLL_ERRORCODES_page "Error Codes") or zero if successful. </returns>
	/// <seealso cref="ISC_RequestBowIndex(char const * serialNo)" />
	/// <seealso cref="ISC_GetBowIndex(const char * serialNo)" />
	ISC_API short __cdecl ISC_SetBowIndex(const char * serialNo, short bowIndex);

	/// <summary> Requests, gets or sets trigger switch bits for Cage Rotator only. </summary>

	/// <summary> Requests the trigger switch bits. </summary>
	/// <param name="serialNo"> The serial no. </param>
	/// <returns> The error code (see \ref C_DLL_ERRORCODES_page "Error Codes") or zero if successful. </returns>
	/// <seealso cref="BMC_GetTriggerSwitches(const char * serialNo)" />
	/// <seealso cref="BMC_SetTriggerSwitches(char const * serialNo, byte indicatorBits)" />
	ISC_API short __cdecl ISC_RequestTriggerSwitches(char const * serialNo);

	/// <summary> Gets the trigger switch bits. </summary>
	/// <param name="serialNo">	The controller serial no. </param>
	/// <returns> 8 bits indicating action on trigger input and events to trigger electronic output. </returns>
	/// <seealso cref="ISC_RequestTriggerSwitches(char const * serialNo)" />
	/// <seealso cref="ISC_SetTriggerSwitches(char const * serialNol, byte indicatorBits)" />
	ISC_API byte __cdecl ISC_GetTriggerSwitches(char const * serialNo);

	/// <summary> Sets the trigger switch bits. </summary>
	/// <param name="serialNo">	The controller serial no. </param>
	/// <param name="indicatorBits"> Sets the 8 bits indicating action on trigger input and events to trigger electronic output. </param>
	/// <returns> The error code (see \ref C_DLL_ERRORCODES_page "Error Codes") or zero if successful. </returns>
	/// <seealso cref="ISC_RequestTriggerSwitches(char const * serialNo)" />
	/// <seealso cref="ISC_GetTriggerSwitches(char const * serialNo)" />
	ISC_API short __cdecl ISC_SetTriggerSwitches(char const * serialNo, byte indicatorBits);

	/// <summary> Requests the current position. </summary>
	/// <remarks> This needs to be called to get the device to send it's current position.<br />
	/// 		  NOTE this is called automatically if Polling is enabled for the device using <see cref="ISC_StartPolling(char const * serialNo, int milliseconds)" />. </remarks>
	/// <param name="serialNo"> The device serial no. </param>
	/// <returns> The error code (see \ref C_DLL_ERRORCODES_page "Error Codes") or zero if successfully requested. </returns>
    /// 		  \include CodeSnippet_move.cpp
	/// <seealso cref="ISC_GetPosition(char const * serialNo)" />
	/// <seealso cref="ISC_StartPolling(char const * serialNo, int milliseconds)" />
	ISC_API short __cdecl ISC_RequestPosition(char const * serialNo);
	
	/// <summary> Request the status bits which identify the current motor state. </summary>
	/// <remarks> This needs to be called to get the device to send it's current status bits.<br />
	/// 		  NOTE this is called automatically if Polling is enabled for the device using <see cref="ISC_StartPolling(char const * serialNo, int milliseconds)" />. </remarks>
	/// <param name="serialNo">	The device serial no. </param>
	/// <returns> The error code (see \ref C_DLL_ERRORCODES_page "Error Codes") or zero if successfully requested. </returns>
	/// <seealso cref="ISC_GetStatusBits(char const * serialNo)" />
	/// <seealso cref="ISC_StartPolling(char const * serialNo, int milliseconds)" />
	ISC_API short __cdecl ISC_RequestStatusBits(char const * serialNo);

	/// <summary>	Request position and status bits. </summary>
	/// <remarks> This needs to be called to get the device to send it's current status.<br />
	/// 		  NOTE this is called automatically if Polling is enabled for the device using <see cref="ISC_StartPolling(char const * serialNo, int milliseconds)" />. </remarks>
	/// <param name="serialNo">	The device serial no. </param>
	/// <returns> The error code (see \ref C_DLL_ERRORCODES_page "Error Codes") or zero if successfully requested. </returns>
	/// <seealso cref="ISC_RequestPosition(char const * serialNo)" />
	/// <seealso cref="ISC_RequestStatusBits(char const * serialNo)" />
	/// <seealso cref="ISC_GetPosition(char const * serialNo)" />
	/// <seealso cref="ISC_GetStatusBits(char const * serialNo)" />
	/// <seealso cref="ISC_StartPolling(char const * serialNo, int milliseconds)" />
	ISC_API short __cdecl ISC_RequestStatus(char const * serialNo);

	/// <summary>Get the current status bits. </summary>
	/// <remarks> This returns the latest status bits received from the device.<br />
	/// 		  To get new status bits, use <see cref="ISC_RequestStatusBits(char const * serialNo)" />
	///			  or use <see cref="ISC_RequestStatus(char const * serialNo)" />
	/// 		  or use the polling functions, <see cref="ISC_StartPolling(char const * serialNo, int milliseconds)" />.  </remarks>
	/// <param name="serialNo">	The device serial no. </param>
	/// <returns>	The status bits from the device <list type=table>
	///				<item><term>0x00000001</term><term>CW hardware limit switch (0=No contact, 1=Contact).</term></item>
	///				<item><term>0x00000002</term><term>CCW hardware limit switch (0=No contact, 1=Contact).</term></item>
	///				<item><term>0x00000004</term><term>CW software limit switch (0=No contact, 1=Contact).</term></item>
 	///				<item><term>0x00000008</term><term>CCW software limit switch (0=No contact, 1=Contact).</term></item>
	///				<item><term>0x00000010</term><term>Motor shaft moving clockwise (1=Moving, 0=Stationary).</term></item>
	///				<item><term>0x00000020</term><term>Motor shaft moving counterclockwise (1=Moving, 0=Stationary).</term></item>
	///				<item><term>0x00000040</term><term>Shaft jogging clockwise (1=Moving, 0=Stationary).</term></item>
	///				<item><term>0x00000080</term><term>Shaft jogging counterclockwise (1=Moving, 0=Stationary).</term></item>
	///				<item><term>0x00000100</term><term>Motor connected (1=Connected, 0=Not connected).</term></item>
 	///				<item><term>0x00000200</term><term>Motor homing (1=Homing, 0=Not homing).</term></item>
	///				<item><term>0x00000400</term><term>Motor homed (1=Homed, 0=Not homed).</term></item>
	///				<item><term>0x00000800</term><term>For Future Use.</term></item>
 	///				<item><term>0x00001000</term><term>Not applicable.</term></item>
	///				<item><term>0x00002000</term><term></term></item>
	///				<item><term>...</term><term></term></item>
	///				<item><term>0x00080000</term><term></term></item>
	///				<item><term>0x00100000</term><term>Digital input 1 state (1=Logic high, 0=Logic low).</term></item>
	///				<item><term>0x00200000</term><term>Digital input 2 state (1=Logic high, 0=Logic low).</term></item>
	///				<item><term>0x00400000</term><term>Digital input 3 state (1=Logic high, 0=Logic low).</term></item>
	///				<item><term>0x00800000</term><term>Digital input 4 state (1=Logic high, 0=Logic low).</term></item>
	///				<item><term>0x01000000</term><term>Digital input 5 state (1=Logic high, 0=Logic low).</term></item>
	///				<item><term>0x02000000</term><term>Digital input 6 state (1=Logic high, 0=Logic low).</term></item>
	///				<item><term>0x04000000</term><term>For Future Use.</term></item>
	///				<item><term>0x08000000</term><term>For Future Use.</term></item>
	///				<item><term>0x10000000</term><term>For Future Use.</term></item>
	///				<item><term>0x20000000</term><term>Active (1=Active, 0=Not active).</term></item>
	///				<item><term>0x40000000</term><term>For Future Use.</term></item>
	///				<item><term>0x80000000</term><term>Channel enabled (1=Enabled, 0=Disabled).</term></item>
	/// 		  </list> <remarks> Bits 21 to 26 (Digital Input States) are only applicable if the associated digital input is fitted to your controller - see the relevant handbook for more details. </remarks> </returns>
	/// <seealso cref="ISC_RequestStatusBits(char const * serialNo)" />
	/// <seealso cref="ISC_RequestStatus(char const * serialNo)" />
	/// <seealso cref="ISC_StartPolling(char const * serialNo, int milliseconds)" />
	ISC_API DWORD __cdecl ISC_GetStatusBits(char const * serialNo);

	/// <summary> Starts the internal polling loop which continuously requests position and status. </summary>
	/// <param name="serialNo"> The device serial no. </param>
	/// <param name="milliseconds">The milliseconds polling rate. </param>
	/// <returns> <c>true</c> if successful, false if not. </returns>
	/// <seealso cref="ISC_StopPolling(char const * serialNo)" />
	/// <seealso cref="ISC_PollingDuration(char const * serialNo)" />
	/// <seealso cref="ISC_RequestStatusBits(char const * serialNo)" />
	/// <seealso cref="ISC_RequestPosition(char const * serialNo)" />
	/// \include CodeSnippet_connection1.cpp
	ISC_API bool __cdecl ISC_StartPolling(char const * serialNo, int milliseconds);

	/// <summary> Gets the polling loop duration. </summary>
	/// <param name="serialNo"> The device serial no. </param>
	/// <returns> The time between polls in milliseconds or 0 if polling is not active. </returns>
	/// <seealso cref="ISC_StartPolling(char const * serialNo, int milliseconds)" />
	/// <seealso cref="ISC_StopPolling(char const * serialNo)" />
	/// \include CodeSnippet_connection1.cpp
	ISC_API long __cdecl ISC_PollingDuration(char const * serialNo);

	/// <summary> Stops the internal polling loop. </summary>
	/// <param name="serialNo"> The device serial no. </param>
	/// <seealso cref="ISC_StartPolling(char const * serialNo, int milliseconds)" />
	/// <seealso cref="ISC_PollingDuration(char const * serialNo)" />
	/// \include CodeSnippet_connection1.cpp
	ISC_API void __cdecl ISC_StopPolling(char const * serialNo);

	/// <summary> Gets the time in milliseconds since tha last message was received from the device. </summary>
	/// <remarks> This can be used to determine whether communications with the device is still good</remarks>
	/// <param name="serialNo"> The device serial no. </param>
	/// <param name="lastUpdateTimeMS"> The time since the last message was received in milliseconds. </param>
	/// <returns> True if monitoring is enabled otherwize False. </returns>
	/// <seealso cref="ISC_EnableLastMsgTimer(char const * serialNo, bool enable, __int32 lastMsgTimeout )" />
	/// <seealso cref="ISC_HasLastMsgTimerOverrun(char const * serialNo)" />
	/// \include CodeSnippet_connectionMonitoring.cpp
	ISC_API bool __cdecl ISC_TimeSinceLastMsgReceived(char const * serialNo, __int64 &lastUpdateTimeMS );

	/// <summary> Enables the last message monitoring timer. </summary>
	/// <remarks> This can be used to determine whether communications with the device is still good</remarks>
	/// <param name="serialNo"> The device serial no. </param>
	/// <param name="enable"> True to enable monitoring otherwise False to disable. </param>
	/// <param name="lastMsgTimeout"> The last message error timeout in ms. 0 to disable. </param>
	/// <seealso cref="ISC_TimeSinceLastMsgReceived(char const * serialNo, __int64 &lastUpdateTimeMS )" />
	/// <seealso cref="ISC_HasLastMsgTimerOverrun(char const * serialNo)" />
	/// \include CodeSnippet_connectionMonitoring.cpp
	ISC_API void __cdecl ISC_EnableLastMsgTimer(char const * serialNo, bool enable, __int32 lastMsgTimeout );

	/// <summary> Queries if the time since the last message has exceeded the lastMsgTimeout set by <see cref="ISC_EnableLastMsgTimer(char const * serialNo, bool enable, __int32 lastMsgTimeout )"/>. </summary>
	/// <remarks> This can be used to determine whether communications with the device is still good</remarks>
	/// <param name="serialNo"> The device serial no. </param>
	/// <returns> True if last message timer has elapsed, False if monitoring is not enabled or if time of last message received is less than lastMsgTimeout. </returns>
	/// <seealso cref="ISC_TimeSinceLastMsgReceived(char const * serialNo, __int64 &lastUpdateTimeMS )" />
	/// <seealso cref="ISC_EnableLastMsgTimer(char const * serialNo, bool enable, __int32 lastMsgTimeout )" />
	/// \include CodeSnippet_connectionMonitoring.cpp
	ISC_API bool __cdecl ISC_HasLastMsgTimerOverrun(char const * serialNo);

	/// <summary> Requests that all settings are download from device. </summary>
	/// <remarks> This function requests that the device upload all it's settings to the DLL.</remarks>
	/// <param name="serialNo">	The device serial no. </param>
	/// <returns> The error code (see \ref C_DLL_ERRORCODES_page "Error Codes") or zero if successfully requested. </returns>
	ISC_API short __cdecl ISC_RequestSettings(char const * serialNo);

	/// <summary> Gets the LTS Motor minimum stage position. </summary>
	/// <param name="serialNo">	The device serial no. </param>
	/// <returns> The Minimum position in \ref DeviceUnits_page. </returns>
	/// <seealso cref="ISC_SetStageAxisLimits(char const * serialNo, int minPosition, int maxPosition)" />
	/// <seealso cref="ISC_GetStageAxisMaxPos(char const * serialNo)" />
	ISC_API int __cdecl ISC_GetStageAxisMinPos(char const * serialNo);

	/// <summary> Gets the LTS Motor maximum stage position. </summary>
	/// <param name="serialNo">	The device serial no. </param>
	/// <returns> The Maximum position in \ref DeviceUnits_page. </returns>
	/// <seealso cref="ISC_SetStageAxisLimits(char const * serialNo, int minPosition, int maxPosition)" />
	/// <seealso cref="ISC_GetStageAxisMinPos(char const * serialNo)" />
	ISC_API int __cdecl ISC_GetStageAxisMaxPos(char const * serialNo);

	/// <summary> Sets the stage axis position limits. </summary>
	/// <param name="serialNo">	The device serial no. </param>
	/// <param name="minPosition"> The minimum position in \ref DeviceUnits_page. </param>
	/// <param name="maxPosition"> The maximum position in \ref DeviceUnits_page. </param>
	/// <returns> The error code (see \ref C_DLL_ERRORCODES_page "Error Codes") or zero if successful. </returns>
	/// <seealso cref="ISC_GetStageAxisMinPos(char const * serialNo)" />
	/// <seealso cref="ISC_GetStageAxisMaxPos(char const * serialNo)" />
	ISC_API short __cdecl ISC_SetStageAxisLimits(char const * serialNo, int minPosition, int maxPosition);

	/// <summary> Set the motor travel mode. </summary>
	/// <param name="serialNo"> The device serial no. </param>
	/// <param name="travelMode"> The travel mode.
	/// 						  <list type=table>
	///								<item><term>Linear motion</term><term>1</term></item>
	///								<item><term>Rotational motion</term><term>2</term></item>
	/// 						  </list> </param>
	/// <returns> The error code (see \ref C_DLL_ERRORCODES_page "Error Codes") or zero if successful. </returns>
	/// <seealso cref="ISC_GetMotorTravelMode(char const * serialNo)" />
	ISC_API short __cdecl ISC_SetMotorTravelMode(char const * serialNo, MOT_TravelModes travelMode);

	/// <summary> Get the motor travel mode. </summary>
	/// <param name="serialNo"> The device serial no. </param>
	/// <returns> The travel mode.
	/// 						  <list type=table>
	///								<item><term>Linear motion</term><term>1</term></item>
	///								<item><term>Rotational motion</term><term>2</term></item>
	/// 						  </list> </returns>
	/// <seealso cref="ISC_SetMotorTravelMode(char const * serialNo, int travelMode)" />
	ISC_API MOT_TravelModes __cdecl ISC_GetMotorTravelMode(char const * serialNo);

	/// <summary> Sets the motor stage parameters. </summary>
	/// <remarks> @deprecated superceded by <see cref="ISC_SetMotorParamsExt(char const * serialNo, double stepsPerRevolution, double gearboxRatio, double pitch)"/> </remarks>
	/// <remarks> These parameters, when combined define the stage motion in terms of \ref RealWorldUnits_page. (mm or degrees)<br />
	/// 		  The real world unit is defined from stepsPerRev * gearBoxRatio / pitch.</remarks>
	/// <param name="serialNo"> The device serial no. </param>
	/// <param name="stepsPerRev">  The steps per revolution. </param>
	/// <param name="gearBoxRatio"> The gear box ratio. </param>
	/// <param name="pitch">	    The pitch. </param>
	/// <returns> The error code (see \ref C_DLL_ERRORCODES_page "Error Codes") or zero if successful. </returns>
	/// <seealso cref="ISC_GetMotorParams(char const * serialNo, long *stepsPerRev, long *gearBoxRatio, float *pitch)" />
	ISC_API short __cdecl ISC_SetMotorParams(char const * serialNo, long stepsPerRev, long gearBoxRatio, float pitch);
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
