jiaruiyang123/SD-OCT/Software/Thorlabs.MotionControl.Benchtop.NanoTrak.h

// summary:	Declares the functions class
// The following ifdef block is the standard way of creating macros which make exporting from a
// DLL simpler. All files within this DLL are compiled with the NANOTRAKDLL_EXPORTS
// symbol defined on the command line. This symbol should not be defined on any project that
// uses this DLL. This way any other project whose source files include this file see 
// NANOTRAK_API functions as being imported from a DLL, whereas this DLL sees
// symbols defined with this macro as being exported.

#pragma once

#ifdef NANOTRAKDLL_EXPORTS
#define NANOTRAK_API __declspec(dllexport)
#else
#define NANOTRAK_API __declspec(dllimport)
#endif

#include <OaIdl.h>

/** @defgroup BenchtopNanoTrak Benchtop NanoTrak
 *  This section details the Structures and Functions relavent to the  @ref BNT001_page "Benchtop NanoTrak"<br />
 *  For an example of how to connect to the device and perform simple operations use the following links:
 *  <list type=bullet>
 *    <item> \ref namespaces_bnt_ex_1 "Example of using the Thorlabs.MotionControl.Benchtop.NanoTrak.DLL from a C or C++ project."<br />
 *									  This requires the DLL to be dynamical linked. </item>
 *    <item> \ref namespaces_bnt_ex_2 "Example of using the Thorlabs.MotionControl.Benchtop.NanoTrak.DLL from a C# project"<br />
 *									  This uses Marshalling to load and access the C DLL. </item>
 *  </list>
 *  The Thorlabs.MotionControl.Benchtop.NanoTrak.DLL requires the following DLLs
 *  <list type=bullet>
 *    <item> Thorlabs.MotionControl.DeviceManager. </item>
 *  </list>
 *  @{
 */

extern "C"
{
	/// \cond NOT_MASTER

	/// <summary> Values that represent FT_Status. </summary>
	typedef enum FT_Status : short
	{
		FT_OK = 0x00, /// <OK - no error.
		FT_InvalidHandle = 0x01, ///<Invalid handle.
		FT_DeviceNotFound = 0x02, ///<Device not found.
		FT_DeviceNotOpened = 0x03, ///<Device not opened.
		FT_IOError = 0x04, ///<I/O error.
		FT_InsufficientResources = 0x05, ///<Insufficient resources.
		FT_InvalidParameter = 0x06, ///<Invalid parameter.
		FT_DeviceNotPresent = 0x07, ///<Device not present.
		FT_IncorrectDevice = 0x08 ///<Incorrect device.
	 } FT_Status;

	/// <summary> Values that represent THORLABSDEVICE_API. </summary>
	typedef enum MOT_MotorTypes
	{
		MOT_NotMotor = 0,
		MOT_DCMotor = 1,
		MOT_StepperMotor = 2,
		MOT_BrushlessMotor = 3,
		MOT_CustomMotor = 100,
	} MOT_MotorTypes;
	/// \endcond

	/// <summary> Information about the device generated from serial number. </summary>
	#pragma pack(1)
	typedef struct TLI_DeviceInfo
	{
		/// <summary> The device Type ID, see \ref C_DEVICEID_page "Device serial numbers". </summary>
		DWORD typeID;
		/// <summary> The device description. </summary>
		char description[65];
		/// <summary> The device serial number. </summary>
		char serialNo[9];
		/// <summary> The USB PID number. </summary>
		DWORD PID;

		/// <summary> <c>true</c> if this object is a type known to the Motion Control software. </summary>
		bool isKnownType;
		/// <summary> The motor type (if a motor).
		/// 		  <list type=table>
		///				<item><term>MOT_NotMotor</term><term>0</term></item>
		///				<item><term>MOT_DCMotor</term><term>1</term></item>
		///				<item><term>MOT_StepperMotor</term><term>2</term></item>
		///				<item><term>MOT_BrushlessMotor</term><term>3</term></item>
		///				<item><term>MOT_CustomMotor</term><term>100</term></item>
		/// 		  </list> </summary>
		MOT_MotorTypes motorType;

		/// <summary> <c>true</c> if the device is a piezo device. </summary>
		bool isPiezoDevice;
		/// <summary> <c>true</c> if the device is a laser. </summary>
		bool isLaser;
		/// <summary> <c>true</c> if the device is a custom type. </summary>
		bool isCustomType;
		/// <summary> <c>true</c> if the device is a rack. </summary>
		bool isRack;
		/// <summary> Defines the number of channels available in this device. </summary>
		short maxChannels;
	} TLI_DeviceInfo;

	/// <summary> Structure containing the Hardware Information. </summary>
	/// <value> Hardware Information retrieved from tthe device. </value>
	typedef struct TLI_HardwareInformation
	{
		/// <summary> The device serial number. </summary>
		/// <remarks> The device serial number is a serial number,<br />starting with 2 digits representing the device type<br /> and a 6 digit unique value.</remarks>
		DWORD serialNumber;
		/// <summary> The device model number. </summary>
		/// <remarks> The model number uniquely identifies the device type as a string. </remarks>
		char modelNumber[8];
		/// <summary> The device type. </summary>
		/// <remarks> Each device type has a unique Type ID: see \ref C_DEVICEID_page "Device serial numbers" </remarks>
		WORD type;
		/// <summary> The device firmware version. </summary>
		DWORD firmwareVersion;
		/// <summary> The device notes read from the device. </summary>
		char notes[48];
		/// <summary> The device dependant data. </summary>
		BYTE deviceDependantData[12];
		/// <summary> The device hardware version. </summary>
		WORD hardwareVersion;
		/// <summary> The device modification state. </summary>
		WORD modificationState;
		/// <summary> The number of channels the device provides. </summary>
		short numChannels;
	} TLI_HardwareInformation;

	/// <summary> NanoTrak Signal States. </summary>
	/// \ingroup Common
	typedef enum NT_SignalState
	{
		NT_BadSignal = 0x00, ///<The bad signal state.
		NT_GoodSignal = 0x01, ///<The good signal state.
	} NT_SignalState;

	/// <summary> NanoTrak Operating mode. </summary>
	/// \ingroup Common
	typedef enum NT_Mode : WORD
	{
		NT_ModeUndefined = 0x00, ///< Undefined nanoTrak mode.
		NT_Piezo = 0x01, ///< The Piezo nanoTrak mode.
		NT_Latch = 0x02, ///< The Latched NanoTrak mode.
		NT_Tracking = 0x03, ///< The Tracking NanoTrak mode.
		NT_HorizontalTracking = 0x04, ///< The Horizontal Tracking NanoTrak mode.
		NT_VerticalTracking = 0x05, ///< The Vertical Tracking NanoTrak mode.
	} NT_Mode;

	/// <summary> Values that represent NanoTrak Operating Modes. </summary>
	/// \ingroup Common
	typedef enum NT_ControlMode : WORD
	{
		NT_ControlModeUndefined = 0x00, ///<undefined nanoTrak mode.
		NT_OpenLoop = 0x01, ///<the open loop nanoTrak mode.
		NT_ClosedLoop = 0x02, ///<the closed loop nanoTrak mode.
		NT_OpenLoopSmoothed = 0x03, ///<the smoothed open loop nanoTrak mode.
		NT_ClosedLoopSmoothed = 0x04, ///<the smoother closed loop nanoTrak mode.
	} NT_ControlMode;

	/// <summary> NanoTrak Feedback Source. </summary>
	/// \ingroup Common
	typedef enum NT_FeedbackSource : WORD
	{
		NT_FeedbackSourceUndefined = 0x00, ///< Undefined.
		NT_TIA = 0x01, ///< The TIA input source.
		NT_BNC_1v = 0x02, ///< The  BNC input source at 1V.
		NT_BNC_2v = 0x03, ///< The  BNC input source at 2V.
		NT_BNC_5v = 0x04, ///< The  BNC input source at 5V.
		NT_BNC_10v = 0x05, ///< The  BNC input source at 10V
	} NT_FeedbackSource;

	/// <summary> Defines the number TIA ranges. </summary>
	#define NUM_TIA_RANGES	16

	/// <summary> NanoTrak TIA Ranges. </summary>
	/// \ingroup Common
	typedef enum NT_TIARange : WORD
	{
		NT_TIARange1_3nA = 0x0003, ///< 3nA range.
		NT_TIARange2_10nA = 0x0004, ///< 10nA range.
		NT_TIARange3_30nA = 0x0005, ///< 30nA range.
		NT_TIARange4_100nA = 0x0006, ///< 100 nA range.
		NT_TIARange5_300nA = 0x0007, ///< 300 nA range.
		NT_TIARange6_1uA = 0x0008, ///< 1 uA range.
		NT_TIARange7_3uA = 0x0009, ///< 3 uA range.
		NT_TIARange8_10uA = 0x000A, ///< 10 uA range.
		NT_TIARange9_30uA = 0x000B, ///< 30 uA range.
		NT_TIARange10_100uA = 0x000C, ///< 100 uA range.
		NT_TIARange11_300uA = 0x000D, ///< 300 uA range.
		NT_TIARange12_1mA = 0x000E, ///< 1 mA range.
		NT_TIARange13_3mA = 0x000F, ///< 3 mA range.
		NT_TIARange14_10mA = 0x0010 ///< 10 mA range.
	} NT_TIARange;

	/// <summary> The Odd or Even TIA Range specification. </summary>
	/// \ingroup Common
	typedef enum NT_OddOrEven : WORD
	{
		NT_OddAndEven = 0x0001, ///< Both odd or even TIA ranges. 
		NT_Odd = 0x0002, ///< Odd TIA ranges.
		NT_Even = 0x0003 ///< Even TIA ranges.
	} NT_OddOrEven;

	/// <summary> The in range specification. </summary>
	/// \ingroup Common
	typedef enum NT_UnderOrOver : WORD
	{
		NT_InRange = 0x0001, ///< Signal is in range. 
		NT_UnderRange = 0x0002, ///< Signal is under range. 
		NT_OverRange = 0x0003 ///< Signal is over range. 
	} NT_UnderOrOver;

	/// <summary> Circle diameter mode types. </summary>
	/// \ingroup Common
	typedef enum NT_CircleDiameterMode : WORD
	{
		NT_ParameterCircleMode = 0x0001, ///<Use the fixed diameter definition.
		NT_AbsPowerCircleMode = 0x0002, ///<Use the algorithm to calculate circle diameter.
		NT_LUTCircleMode = 0x0003 ///<Use the circle look up table (LUT).
	} NT_CircleDiameterMode;

	/// <summary> The methods used by circle diameter algorithm. </summary>
	/// \ingroup Common
	typedef enum NT_CircleAdjustment : WORD
	{
		NT_LinearCircleAdjustment = 0x0001, ///<Linear Adjustment method.
		NT_LogCircleAdjustment = 0x0002, ///<Logarithmic circle adjustment.
		NT_SquareCircleAdjustment = 0x0003, ///<Square circle adjustment.
		NT_CubeCircleAdjustment = 0x0004 ///<Cubic circle adjustment.
	} NT_CircleAdjustment;

	/// <summary> TIA Ranging Mode. </summary>
	/// \ingroup Common
	typedef enum NT_TIARangeMode : WORD
	{
		NT_TIARangeModeUndefined = 0x0000, ///<Undefined.
		NT_AutoRangeAtSelected = 0x0001, ///<Autorange TIA at selected range.
		NT_ManualRangeAtSelected = 0x0002, ///<Manual TIA at selected range.
		NT_ManualRangeAtParameter = 0x0003, ///<Manual TIA at supplied parameter range.
		NT_AutoRangeAtParameter = 0x0004 ///<Autorange TIA at supplied parameter range.
	} NT_TIARangeMode;

	/// <summary> Values that represent Low Pass Frequencdies. </summary>
	/// \ingroup Common
	typedef enum NT_LowPassFrequency : WORD
	{
		NT_LowPassNone, ///<Low Pass Filter Diasabled.
		NT_LowPass_1Hz, ///<Low Pass Filter at 1 Hz.
		NT_LowPass_3Hz, ///<Low Pass Filter at 3 Hz.
		NT_LowPass_10Hz, ///<Low Pass Filter at 10 Hz.
		NT_LowPass_30Hz, ///<Low Pass Filter at 30 Hz.
		NT_LowPass_100Hz ///<Low Pass Filter at 100 Hz.
	} NT_LowPassFrequency;

	/// <summary> NanoTrak Output Voltage Range. </summary>
	/// \ingroup Common
	typedef enum NT_VoltageRange : WORD
	{
		NT_VoltageRangeUndefined = 0x0000, ///<Undefined.
		NT_VoltageRange_5v = 0x0001, ///<5v output rangen.
		NT_VoltageRange_10v = 0x0002 ///<10v output range.
	} NT_VoltageRange;

	/// <summary> NanoTrak Output Route. </summary>
	/// \ingroup Common
	typedef enum NT_OutputVoltageRoute : WORD
	{
		NT_SMAOnly = 0x0001, ///<Output to SMA connector only.
		NT_HubOrSMA = 0x0002 ///<Output to SMA connector and Hub.
	} NT_OutputVoltageRoute;

	/// <summary> The Input mode units. </summary>
	/// \ingroup Common
	typedef enum NT_PowerInputUnits : WORD
	{
		NT_Amps, ///<Display as mAmps.
		NT_Watts, ///<Display as mWatts
		NT_Db ///<Display as dBm.
	} NT_PowerInputUnits;

	/// <summary> The SMA units. </summary>
	/// \ingroup Common
	typedef enum NT_SMA_Units : WORD
	{
		NT_Voltage, ///<SMA output as Voltage.
		NT_FullRange, ///<SMA output as % Full Range.
		NT_UserDefined ///<SMA output as User Defined.
	} NT_SMA_Units;

	/// <summary> HV amp output current limit definitions. </summary>
	typedef enum BNT_CurrentLimit : WORD
	{
		NT_CurrentLimit_100mA = 0x00,
		NT_CurrentLimit_250mA = 0x01,
		NT_CurrentLimit_500mA = 0x02
	} BNT_CurrentLimit;

	/// <summary> HV amp output low pass filter definitions. </summary>
	typedef enum BNT_OutputLowPassFilter : WORD
	{
		NT_OutputFilter_10Hz = 0x0,
		NT_OutputFilter_100Hz = 0x1,
		NT_OutputFilter_5kHz = 0x2,
		NT_OutputFilter_None = 0x3,
	} BNT_OutputLowPassFilter;

	/// <summary> Feedback signal selection definitions. </summary>
	typedef enum BNT_FeedbackSignalSelection : WORD
	{
		NT_FeedbackSignalDC = 0x0000,
		NT_FeedbackSignalAC = 0xFFFF,
	} BNT_FeedbackSignalSelection;

	/// <summary> Feedback signal selection definitions. </summary>
	typedef enum BNT_BNCTriggerModes : WORD
	{
		NT_BNCModeTrigger = 0x0000,
		NT_BNCModeLVOut = 0xFFFF,
	} BNT_BNCTriggerModes;

	/// <summary> Trigger/LV Out BNCs mode selection definitions. </summary>
	typedef struct BNT_IO_Settings
	{
		/// <summary> Channel ident. </summary>
		WORD channel;
		/// <summary> Channel HV amp output current limit. </summary>
		BNT_CurrentLimit amplifierCurrentLimit;
		/// <summary> HV amp output low pass filter setting FOR BOTH CHANNELS. </summary>
		BNT_OutputLowPassFilter amplifierLowPassFilter;
		/// <summary> Channel feedback signal (legacy AC or DC differential). </summary>
		BNT_FeedbackSignalSelection feedbackSignal;
		/// <summary> CHANNEL INDEPENDANT Trigger input/output or LV output mode selection. DOES NOT APPLY TO MODULE VARIANTS. </summary>
		BNT_BNCTriggerModes BNCtriggerOrLowVoltageOut;
	} BNT_IO_Settings;

#pragma pack(1)

	/// <summary> Structure used to hold any parameter which has a horizontal and vertical component, i.e. position. </summary>
	typedef struct NT_HVComponent
	{
		/// <summary> The horizontal component, range 0 to 65535, usage dependant. </summary>
		WORD horizontalComponent;
		/// <summary> The vertical component, range 0 to 65535, useage dependant. </summary>
		WORD verticalComponent;
	} NT_HVComponent;

	/// <summary> Structure containing the scan circle parameters. </summary>
	typedef struct NT_CircleParameters
	{
		/// <summary> Circle diameter mode, <see cref="NT_CircleDiameterMode" />
		///		<list type=table>
		///			<item><term>Use supplied Parameters.</term><term>1</term></item>
		///			<item><term>Use supplied Algorithm.</term><term>2</term></item>
		///			<item><term>use Lookup Table (LUT)</term><term>3</term></item>
		///		</list> </summary>
		NT_CircleDiameterMode mode;
		/// <summary> Circle Diameter where 65535 corresponding to maximum voltage, 10 NT units. </summary>
		WORD diameter;
		/// <summary> Number of samples read per revolution (multiple of 4). </summary>
		WORD samplesPerRevolution;
		/// <summary> Minimum diameter imposed on algorithm 0 to 32767 in NT units. </summary>
		WORD minDiameter;
		/// <summary> Maximum diameter imposed on algorithm 0 to 32767 in NT units. </summary>
		WORD maxDiameter;
		/// <summary> Algorithm adjustment method: <see cref="NT_CircleAdjustment" />
		/// 	 <list type=table>
		///			<item><term>Linear Algorithm.</term><term>1</term></item>
		///			<item><term>Logarithmic algorithm.</term><term>2</term></item>
		///			<item><term>Square algorithm</term><term>3</term></item>
		///			<item><term>Cubic algorithm</term><term>4</term></item>
		///		</list> </summary>
		NT_CircleAdjustment algorithmAdjustment;
	} NT_CircleParameters;

	/// <summary> Structure containing circle the diameter lookup table entries. </summary>
	typedef struct NT_CircleDiameterLUT
	{
		/// <summary> Array of diameters for each TIA range with 65535 corresponding to maximum voltage. </summary>
		WORD LUTdiameter[NUM_TIA_RANGES];
	} NT_CircleDiameterLUT;

	/// <summary> Structure containing TIA range parameters. </summary>
	typedef struct NT_TIARangeParameters
	{
		/// <summary> Chooses automatic or manual ranging and currently selected or new range. <see cref="NT_TIARangeMode" />
		/// 	<list type=table>
		///			<item><term>Automatic Ranging at current range.</term><term>1</term></item>
		///			<item><term>Manual Ranging at current range.</term><term>2</term></item>
		///			<item><term>Manual Ranging using supplied range</term><term>3</term></item>
		///			<item><term>Automatic ranging using supplied range</term><term>4</term></item>
		///		</list>  </summary>
		NT_TIARangeMode mode;
		/// <summary> Up switching threshold as a percentage of the current range.<br />
		/// 		  When in an automatic mode, the range rises above this threshold, the TIA range will rise to the higher TIA range.<br />
		/// 		  Range 0 to 1000 equivalent to 0 to 100% </summary>
		WORD upLimit;
		/// <summary> Down switching threshold as a percentage of the current range.<br />
		/// 		  When in an automatic mode, the range drops below this threshold, the TIA range will drop to the lower TIA range.<br />
		/// 		  Range 0 to 1000 equivalent to 0 to 100%  </summary>
		WORD downLimit;
		/// <summary> The number of samples for averaging to give auto-range input from 2 to 32. </summary>
		short settleSamples;
		/// <summary> parameter determining which TIA ranges to include when auto ranging: <see cref="NT_OddOrEven" />
		/// 	<list type=table>
		///			<item><term>All TIA Ranges.</term><term>1</term></item>
		///			<item><term>Only use Odd TIA ranges.</term><term>2</term></item>
		///			<item><term>Only use even TIA ranges</term><term>3</term></item>
		///		</list> </summary>
		NT_OddOrEven changeToOddOrEven;
		/// <summary> TIA Range to use if in manual mode: <br />
		/// 		  <see cref="NT_TIARange" /> for TIA ranges. </summary>
		NT_TIARange newRange;
	} NT_TIARangeParameters;

	/// <summary> Structure containing long pass filter parameters. </summary>
	/// <value> Options for controlling long pass filters. </value>
	typedef struct NT_LowPassFilterParameters
	{
		/// <summary> Filter 1 Low Pass Filter
		/// 	<list type=table>
		///			<item><term>No Filter.</term><term>0</term></item>
		///			<item><term>1 Hz Filter.</term><term>1</term></item>
		///			<item><term>3 Hz Filter.</term><term>2</term></item>
		///			<item><term>10 Hz Filter</term><term>3</term></item>
		///			<item><term>30 Hz Filter.</term><term>4</term></item>
		///			<item><term>100 Hz Filter.</term><term>5</term></item>
		///		</list> </summary>
		NT_LowPassFrequency param1;
		/// <summary> Currently not used because there is only one filter controlled. </summary>
		NT_LowPassFrequency param2;
		/// <summary> Currently not used. </summary>
		NT_LowPassFrequency param3;
		/// <summary> Currently not used. </summary>
		NT_LowPassFrequency param4;
		/// <summary> Currently not used. </summary>
		NT_LowPassFrequency param5;
	} NT_LowPassFilterParameters;

	/// <summary> Structure containing TIA reading. </summary>
	typedef struct NT_TIAReading
	{
		/// <summary> Absolute reading. </summary>
		float absoluteReading;
		/// <summary> Relative reading 0-32767 for 0 - 100% of selected current range value. </summary>
		WORD relativeReading;
		/// <summary> Selected current range from the <see cref="NT_TIARange" />. </summary>
		NT_TIARange selectedRange;
		/// <summary> Indicates whether read signal is in range, over range or under range. </summary>
		NT_UnderOrOver underOrOverRead;
	} NT_TIAReading;


	/// <summary> Structure containing electronic input and output settings. </summary>
	typedef struct NT_IOSettings
	{
		/// <summary> Low Voltage Output range: <see cref="NT_VoltageRange" /> <list type=table>
		///			<item><term>0 - 5V output range.</term><term>1</term></item>
		///			<item><term>0 - 10V output range.</term><term>2</term></item>
		///		</list> </summary>
		NT_VoltageRange lowVoltageOutRange;
		/// <summary> Low Voltage Output routing: <see cref="NT_OutputVoltageRoute" /> <list type=table>
		///			<item><term>Output to SMA connector.</term><term>1</term></item>
		///			<item><term>Output to Hub and SMA connector.</term><term>2</term></item>
		///		</list> </summary>
		/// <summary> </summary>
		NT_OutputVoltageRoute lowVoltageOutputRoute;
		/// <summary> Not in use. </summary>
		WORD notYetInUse;
		/// <summary> Not in use. </summary>
		WORD unused;
	} NT_IOSettings;

	/// <summary> structure containing NT Gain parameters. </summary>
	typedef struct NT_GainParameters
	{
		/// <summary> The control mode (Always set to 0x02). </summary>
		WORD controlMode;
		/// <summary> The gain setting, range is 100 to 10000. </summary>
		short gain;
	} NT_GainParameters;


	#pragma pack()

    /// <summary> Build the DeviceList. </summary>
    /// <remarks> This function builds an internal collection of all devices found on the USB that are not currently open. <br />
    /// 		  NOTE, if a device is open, it will not appear in the list until the device has been closed. </remarks>
	/// <returns> The error code (see \ref C_DLL_ERRORCODES_page "Error Codes") or zero if successful. </returns>
    /// 		  \include CodeSnippet_identification.cpp
	/// <seealso cref="TLI_GetDeviceListSize()" />
	/// <seealso cref="TLI_GetDeviceList(SAFEARRAY** stringsReceiver)" />
	/// <seealso cref="TLI_GetDeviceListByType(SAFEARRAY** stringsReceiver, int typeID)" />
	/// <seealso cref="TLI_GetDeviceListByTypes(SAFEARRAY** stringsReceiver, int * typeIDs, int length)" />
	/// <seealso cref="TLI_GetDeviceListExt(char *receiveBuffer, DWORD sizeOfBuffer)" />
	/// <seealso cref="TLI_GetDeviceListByTypeExt(char *receiveBuffer, DWORD sizeOfBuffer, int typeID)" />
	/// <seealso cref="TLI_GetDeviceListByTypesExt(char *receiveBuffer, DWORD sizeOfBuffer, int * typeIDs, int length)" />
	NANOTRAK_API short __cdecl TLI_BuildDeviceList(void);

	/// <summary> Gets the device list size. </summary>
	/// 		  \include CodeSnippet_identification.cpp
	/// <returns> Number of devices in device list. </returns>
	/// <seealso cref="TLI_BuildDeviceList()" />
	/// <seealso cref="TLI_GetDeviceList(SAFEARRAY** stringsReceiver)" />
	/// <seealso cref="TLI_GetDeviceListByType(SAFEARRAY** stringsReceiver, int typeID)" />
	/// <seealso cref="TLI_GetDeviceListByTypes(SAFEARRAY** stringsReceiver, int * typeIDs, int length)" />
	/// <seealso cref="TLI_GetDeviceListExt(char *receiveBuffer, DWORD sizeOfBuffer)" />
	/// <seealso cref="TLI_GetDeviceListByTypeExt(char *receiveBuffer, DWORD sizeOfBuffer, int typeID)" />
	/// <seealso cref="TLI_GetDeviceListByTypesExt(char *receiveBuffer, DWORD sizeOfBuffer, int * typeIDs, int length)" />
	NANOTRAK_API short __cdecl TLI_GetDeviceListSize();

	/// <summary> Get the entire contents of the device list. </summary>
	/// <param name="stringsReceiver"> Outputs a SAFEARRAY of strings holding device serial numbers. </param>
	/// <returns> The error code (see \ref C_DLL_ERRORCODES_page "Error Codes") or zero if successful. </returns>
    /// 		  \include CodeSnippet_identification.cpp
	/// <seealso cref="TLI_GetDeviceListSize()" />
	/// <seealso cref="TLI_BuildDeviceList()" />
	/// <seealso cref="TLI_GetDeviceListByType(SAFEARRAY** stringsReceiver, int typeID)" />
	/// <seealso cref="TLI_GetDeviceListByTypes(SAFEARRAY** stringsReceiver, int * typeIDs, int length)" />
	/// <seealso cref="TLI_GetDeviceListExt(char *receiveBuffer, DWORD sizeOfBuffer)" />
	/// <seealso cref="TLI_GetDeviceListByTypeExt(char *receiveBuffer, DWORD sizeOfBuffer, int typeID)" />
	/// <seealso cref="TLI_GetDeviceListByTypesExt(char *receiveBuffer, DWORD sizeOfBuffer, int * typeIDs, int length)" />
	NANOTRAK_API short __cdecl TLI_GetDeviceList(SAFEARRAY** stringsReceiver);

	/// <summary> Get the contents of the device list which match the supplied typeID. </summary>
	/// <param name="stringsReceiver"> Outputs a SAFEARRAY of strings holding device serial numbers. </param>
	/// <param name="typeID">The typeID of devices to match, see \ref C_DEVICEID_page "Device serial numbers". </param>
	/// <returns> The error code (see \ref C_DLL_ERRORCODES_page "Error Codes") or zero if successful. </returns>
    /// 		  \include CodeSnippet_identification.cpp
	/// <seealso cref="TLI_GetDeviceListSize()" />
	/// <seealso cref="TLI_BuildDeviceList()" />
	/// <seealso cref="TLI_GetDeviceList(SAFEARRAY** stringsReceiver)" />
	/// <seealso cref="TLI_GetDeviceListByTypes(SAFEARRAY** stringsReceiver, int * typeIDs, int length)" />
	/// <seealso cref="TLI_GetDeviceListExt(char *receiveBuffer, DWORD sizeOfBuffer)" />
	/// <seealso cref="TLI_GetDeviceListByTypeExt(char *receiveBuffer, DWORD sizeOfBuffer, int typeID)" />
	/// <seealso cref="TLI_GetDeviceListByTypesExt(char *receiveBuffer, DWORD sizeOfBuffer, int * typeIDs, int length)" />
	NANOTRAK_API short __cdecl TLI_GetDeviceListByType(SAFEARRAY** stringsReceiver, int typeID);

	/// <summary> Get the contents of the device list which match the supplied typeIDs. </summary>
	/// <param name="stringsReceiver"> Outputs a SAFEARRAY of strings holding device serial numbers. </param>
	/// <param name="typeIDs"> list of typeIDs of devices to be matched, see \ref C_DEVICEID_page "Device serial numbers"</param>
	/// <param name="length"> length of type list</param>
	/// <returns> The error code (see \ref C_DLL_ERRORCODES_page "Error Codes") or zero if successful. </returns>
    /// 		  \include CodeSnippet_identification.cpp
	/// <seealso cref="TLI_GetDeviceListSize()" />
	/// <seealso cref="TLI_BuildDeviceList()" />
	/// <seealso cref="TLI_GetDeviceList(SAFEARRAY** stringsReceiver)" />
	/// <seealso cref="TLI_GetDeviceListByType(SAFEARRAY** stringsReceiver, int typeID)" />
	/// <seealso cref="TLI_GetDeviceListExt(char *receiveBuffer, DWORD sizeOfBuffer)" />
	/// <seealso cref="TLI_GetDeviceListByTypeExt(char *receiveBuffer, DWORD sizeOfBuffer, int typeID)" />
	/// <seealso cref="TLI_GetDeviceListByTypesExt(char *receiveBuffer, DWORD sizeOfBuffer, int * typeIDs, int length)" />
	NANOTRAK_API short __cdecl TLI_GetDeviceListByTypes(SAFEARRAY** stringsReceiver, int * typeIDs, int length);

	/// <summary> Get the entire contents of the device list. </summary>
	/// <param name="receiveBuffer"> a buffer in which to receive the list as a comma separated string. </param>
	/// <param name="sizeOfBuffer">	The size of the output string buffer. </param>
	/// <returns> The error code (see \ref C_DLL_ERRORCODES_page "Error Codes") or zero if successful. </returns>
    /// 		  \include CodeSnippet_identification.cpp
	/// <seealso cref="TLI_GetDeviceListSize()" />
	/// <seealso cref="TLI_BuildDeviceList()" />
	/// <seealso cref="TLI_GetDeviceList(SAFEARRAY** stringsReceiver)" />
	/// <seealso cref="TLI_GetDeviceListByType(SAFEARRAY** stringsReceiver, int typeID)" />
	/// <seealso cref="TLI_GetDeviceListByTypes(SAFEARRAY** stringsReceiver, int * typeIDs, int length)" />
	/// <seealso cref="TLI_GetDeviceListByTypeExt(char *receiveBuffer, DWORD sizeOfBuffer, int typeID)" />
	/// <seealso cref="TLI_GetDeviceListByTypesExt(char *receiveBuffer, DWORD sizeOfBuffer, int * typeIDs, int length)" />
	NANOTRAK_API short __cdecl TLI_GetDeviceListExt(char *receiveBuffer, DWORD sizeOfBuffer);

	/// <summary> Get the contents of the device list which match the supplied typeID. </summary>
	/// <param name="receiveBuffer"> a buffer in which to receive the list as a comma separated string. </param>
	/// <param name="sizeOfBuffer">	The size of the output string buffer. </param>
	/// <param name="typeID"> The typeID of devices to be matched, see \ref C_DEVICEID_page "Device serial numbers"</param>
	/// <returns> The error code (see \ref C_DLL_ERRORCODES_page "Error Codes") or zero if successful. </returns>
    /// 		  \include CodeSnippet_identification.cpp
	/// <seealso cref="TLI_GetDeviceListSize()" />
	/// <seealso cref="TLI_BuildDeviceList()" />
	/// <seealso cref="TLI_GetDeviceList(SAFEARRAY** stringsReceiver)" />
	/// <seealso cref="TLI_GetDeviceListByType(SAFEARRAY** stringsReceiver, int typeID)" />
	/// <seealso cref="TLI_GetDeviceListByTypes(SAFEARRAY** stringsReceiver, int * typeIDs, int length)" />
	/// <seealso cref="TLI_GetDeviceListExt(char *receiveBuffer, DWORD sizeOfBuffer)" />
	/// <seealso cref="TLI_GetDeviceListByTypesExt(char *receiveBuffer, DWORD sizeOfBuffer, int * typeIDs, int length)" />
	NANOTRAK_API short __cdecl TLI_GetDeviceListByTypeExt(char *receiveBuffer, DWORD sizeOfBuffer, int typeID);

	/// <summary> Get the contents of the device list which match the supplied typeIDs. </summary>
	/// <param name="receiveBuffer"> a buffer in which to receive the list as a comma separated string. </param>
	/// <param name="sizeOfBuffer">	The size of the output string buffer. </param>
	/// <param name="typeIDs"> list of typeIDs of devices to be matched, see \ref C_DEVICEID_page "Device serial numbers"</param>
	/// <param name="length"> length of type list</param>
	/// <returns> The error code (see \ref C_DLL_ERRORCODES_page "Error Codes") or zero if successful. </returns>
    /// 		  \include CodeSnippet_identification.cpp
	/// <seealso cref="TLI_GetDeviceListSize()" />
	/// <seealso cref="TLI_BuildDeviceList()" />
	/// <seealso cref="TLI_GetDeviceList(SAFEARRAY** stringsReceiver)" />
	/// <seealso cref="TLI_GetDeviceListByType(SAFEARRAY** stringsReceiver, int typeID)" />
	/// <seealso cref="TLI_GetDeviceListByTypes(SAFEARRAY** stringsReceiver, int * typeIDs, int length)" />
	/// <seealso cref="TLI_GetDeviceListExt(char *receiveBuffer, DWORD sizeOfBuffer)" />
	/// <seealso cref="TLI_GetDeviceListByTypeExt(char *receiveBuffer, DWORD sizeOfBuffer, int typeID)" />
	NANOTRAK_API short __cdecl TLI_GetDeviceListByTypesExt(char *receiveBuffer, DWORD sizeOfBuffer, int * typeIDs, int length);

	/// <summary> Get the device information from the USB port. </summary>
	/// <remarks> The Device Info is read from the USB port not from the device itself.<remarks>
	/// <param name="serialNo"> The serial number of the device. </param>
	/// <param name="info">    The <see cref="TLI_DeviceInfo"/> device information. </param>
	/// <returns> 1 if successful, 0 if not. </returns>
    /// 		  \include CodeSnippet_identification.cpp
	/// <seealso cref="TLI_GetDeviceListSize()" />
	/// <seealso cref="TLI_BuildDeviceList()" />
	/// <seealso cref="TLI_GetDeviceList(SAFEARRAY** stringsReceiver)" />
	/// <seealso cref="TLI_GetDeviceListByType(SAFEARRAY** stringsReceiver, int typeID)" />
	/// <seealso cref="TLI_GetDeviceListByTypes(SAFEARRAY** stringsReceiver, int * typeIDs, int length)" />
	/// <seealso cref="TLI_GetDeviceListExt(char *receiveBuffer, DWORD sizeOfBuffer)" />
	/// <seealso cref="TLI_GetDeviceListByTypeExt(char *receiveBuffer, DWORD sizeOfBuffer, int typeID)" />
	/// <seealso cref="TLI_GetDeviceListByTypesExt(char *receiveBuffer, DWORD sizeOfBuffer, int * typeIDs, int length)" />
	NANOTRAK_API short __cdecl TLI_GetDeviceInfo(char const * serialNo, TLI_DeviceInfo *info);

	/// <summary> Open the device for communications. </summary>
	/// <param name="serialNo">	The serial no of the device to be connected. </param>
	/// <returns> The error code (see \ref C_DLL_ERRORCODES_page "Error Codes") or zero if successful. </returns>
    /// 		  \include CodeSnippet_connectionN.cpp
	/// <seealso cref="NT_Close(char const * serialNo)" />
	NANOTRAK_API short __cdecl NT_Open(char const * serialNo);

	/// <summary> Disconnect and close the device. </summary>
	/// <param name="serialNo">	The serial no of the device to be disconnected. </param>
    /// 		  \include CodeSnippet_connectionN.cpp
	/// <seealso cref="NT_Open(char const * serialNo)" />
	NANOTRAK_API void __cdecl NT_Close(char const * serialNo);

	/// <summary>	Check connection. </summary>
	/// <param name="serialNo">	The device serial no. </param>
	/// <returns> true if the USB is listed by the ftdi controller</returns>
	/// \include CodeSnippet_CheckConnection.cpp
	NANOTRAK_API bool __cdecl NT_CheckConnection(char const * serialNo);

	/// <summary> Sends a command to the device to make it identify iteself. </summary>
	/// <param name="serialNo">	The device serial no. </param>
	NANOTRAK_API void __cdecl NT_Identify(char const * serialNo);

	/// <summary> Gets the hardware information from the device. </summary>
	/// <param name="serialNo">		    The device serial no. </param>
	/// <param name="modelNo">		    Address of a buffer to receive the model number string. Minimum 8 characters </param>
	/// <param name="sizeOfModelNo">	    The size of the model number buffer, minimum of 8 characters. </param>
	/// <param name="type">		    Address of a WORD to receive the hardware type number. </param>
	/// <param name="numChannels">	    Address of a short to receive the  number of channels. </param>
	/// <param name="notes">		    Address of a buffer to receive the notes describing the device. </param>
	/// <param name="sizeOfNotes">		    The size of the notes buffer, minimum of 48 characters. </param>
	/// <param name="firmwareVersion"> Address of a DWORD to receive the  firmware version number made up of 4 byte parts. </param>
	/// <param name="hardwareVersion"> Address of a WORD to receive the  hardware version number. </param>
	/// <param name="modificationState">	    Address of a WORD to receive the hardware modification state number. </param>
	/// <returns> The error code (see \ref C_DLL_ERRORCODES_page "Error Codes") or zero if successful. </returns>
    /// 		  \include CodeSnippet_identify.cpp
	NANOTRAK_API short __cdecl NT_GetHardwareInfo(char const * serialNo, char * modelNo, DWORD sizeOfModelNo, WORD * type, WORD * numChannels, 
													char * notes, DWORD sizeOfNotes, DWORD * firmwareVersion, WORD * hardwareVersion, WORD * modificationState);

	/// <summary> Gets the hardware information in a block. </summary>
	/// <param name="serialNo">	The device serial no. </param>
	/// <param name="hardwareInfo"> Address of a TLI_HardwareInformation structure to receive the hardware information. </param>
	/// <returns> The error code (see \ref C_DLL_ERRORCODES_page "Error Codes") or zero if successful. </returns>
    /// 		  \include CodeSnippet_identify.cpp
	NANOTRAK_API short __cdecl NT_GetHardwareInfoBlock(char const *serialNo, TLI_HardwareInformation *hardwareInfo);

	/// <summary> Gets version number of the device firmware. </summary>
	/// <param name="serialNo">	The device serial no. </param>
	/// <returns> The device firmware version number made up of 4 byte parts. </returns>
    /// 		  \include CodeSnippet_identify.cpp
	NANOTRAK_API DWORD __cdecl NT_GetFirmwareVersion(char const * serialNo);

	/// <summary> Gets version number of the device software. </summary>
	/// <param name="serialNo">	The device serial no. </param>
	/// <returns> The device software version number made up of 4 byte parts. </returns>
    /// 		  \include CodeSnippet_identify.cpp
	NANOTRAK_API DWORD __cdecl NT_GetSoftwareVersion(char const * serialNo);

	/// <summary> Update device with stored settings. </summary>
	/// <param name="serialNo"> The device serial no. </param>
	/// <returns> <c>true</c> if successful, false if not. </returns>
    /// 		  \include CodeSnippet_connection1.cpp
	NANOTRAK_API bool __cdecl NT_LoadSettings(char const * serialNo);

	/// <summary> Update device with named settings. </summary>
	/// <param name="serialNo"> The device serial no. </param>
	/// <param name="settingsName"> Name of settings stored away from device. </param>
	/// <returns> <c>true</c> if successful, false if not. </returns>
	///             \include CodeSnippet_connection1.cpp
	NANOTRAK_API bool __cdecl NT_LoadNamedSettings(char const * serialNo, char const *settingsName);

	/// <summary> persist the devices current settings. </summary>
	/// <param name="serialNo">	The device serial no. </param>
	/// <returns> <c>true</c> if successful, false if not. </returns>
	NANOTRAK_API bool __cdecl NT_PersistSettings(char const * serialNo);

	/// <summary> Tells the device that it is being disconnected. </summary>
	/// <remarks> This does not disconnect the communications.<br />
	/// 		  To disconnect the communications, call the <see cref="NT_Close(char const * serialNo)" /> function. </remarks>
	/// <param name="serialNo">	The device serial no. </param>
	/// <returns> The error code (see \ref C_DLL_ERRORCODES_page "Error Codes") or zero if successful. </returns>
	NANOTRAK_API short __cdecl NT_Disconnect(char const * serialNo);

	/// <summary> Requests the NanoTrak signal state. </summary>
	/// <param name="serialNo">	The device serial no. </param>
	/// <returns> The error code (see \ref C_DLL_ERRORCODES_page "Error Codes") or zero if successful. </returns>
	/// <seealso cref="NT_GetSignalState(char const * serialNo)" />
	NANOTRAK_API short __cdecl NT_RequestSignalState(char const * serialNo);

	/// <summary> Gets the NanoTrak signal state. </summary>
	/// <param name="serialNo">	The device serial no. </param>
	/// <returns> <list type=table>
	///				<item><term>Not tracking or poor signal</term><term>0</term></item>
	///				<item><term>Tracking and good signal</term><term>1</term></item>
	/// 		  </list> </returns>
	/// <seealso cref="NT_RequestSignalState(char const * serialNo)" />
	NANOTRAK_API NT_SignalState __cdecl NT_GetSignalState(char const * serialNo);

	/// <summary> Requests the NanoTrak mode. </summary>
	/// <param name="serialNo">	The device serial no. </param>
	/// <returns> The error code (see \ref C_DLL_ERRORCODES_page "Error Codes") or zero if successful. </returns>
	/// <seealso cref="NT_GetMode(char const * serialNo)" />
	/// <seealso cref="NT_SetMode(char const * serialNo, NT_Mode mode)" />
	NANOTRAK_API short __cdecl NT_RequestMode(char const * serialNo);

	/// <summary> Gets the nanoTrak operating mode. </summary>
	/// <param name="serialNo">	The device serial no. </param>
	/// <returns> The NanoTrak operating mode.
	/// 		  <list type=table>
	///				<item><term>Undefined</term><term>0</term></item>
	///				<item><term>Piezo Mode</term><term>1</term></item>
	///				<item><term>Latched output mode</term><term>2</term></item>
	///				<item><term>Tracking mode</term><term>3</term></item>
	///				<item><term>Horizontal tracking mode</term><term>4</term></item>
	///				<item><term>Vertical Tracking Mode</term><term>5</term></item>
	/// 		  </list> </returns>
	/// <seealso cref="NT_SetMode(char const * serialNo, NT_Mode mode)" />
	/// <seealso cref="NT_RequestMode(char const * serialNo)" />
	NANOTRAK_API NT_Mode __cdecl NT_GetMode(char const * serialNo);

	/// <summary> Setsthe nanoTrak operating mode. </summary>
	/// <param name="serialNo">	The device serial no. </param>
	/// <param name="mode"> The NanoTrak operating mode.
	/// 		<list type=table>
	///				<item><term>Undefined</term><term>0</term></item>
	///				<item><term>Piezo Mode</term><term>1</term></item>
	///				<item><term>Latched output mode</term><term>2</term></item>
	///				<item><term>Tracking mode</term><term>3</term></item>
	///				<item><term>Horizontal tracking mode</term><term>4</term></item>
	///				<item><term>Vertical Tracking Mode</term><term>5</term></item>
	/// 		  </list> </param>
	/// <returns> The error code (see \ref C_DLL_ERRORCODES_page "Error Codes") or zero if successful. </returns>
	/// <seealso cref="NT_RequestMode(char const * serialNo)" />
	/// <seealso cref="NT_GetMode(char const * serialNo)" />
	NANOTRAK_API short __cdecl NT_SetMode(char const * serialNo, NT_Mode mode);

	/// <summary> Requests the NanoTrak tracking threshold signal. </summary>
	/// <param name="serialNo">	The device serial no. </param>
	/// <returns> The error code (see \ref C_DLL_ERRORCODES_page "Error Codes") or zero if successful. </returns>
	/// <seealso cref="NT_GetTrackingThresholdSignal(char const * serialNo)" />
	/// <seealso cref="NT_SetTrackingThresholdSignal(char const * serialNo, float threshold)" />
	NANOTRAK_API short __cdecl NT_RequestTrackingThresholdSignal(char const * serialNo);

	/// <summary> Gets the tracking threshold signal. </summary>
	/// <param name="serialNo">	The device serial no. </param>
	/// <returns> Tracking threshold signal in amps from 1.0e-9 to 1.0e-3. </returns>
	/// <seealso cref="NT_RequestrackingThresholdSignal(char const * serialNo)" />
	/// <seealso cref="NT_SetTrackingThresholdSignal(char const * serialNo, float threshold)" />
	NANOTRAK_API float __cdecl NT_GetTrackingThresholdSignal(char const * serialNo);

	/// <summary> Sets the tracking threshold signal. </summary>
	/// <param name="serialNo">	The device serial no. </param>
	/// <param name="threshold"> Tracking threshold signal in amps from 1.0e-9 to 1.0e-3. </param>
	/// <returns> The error code (see \ref C_DLL_ERRORCODES_page "Error Codes") or zero if successful. </returns>
	/// <seealso cref="NT_RequestrackingThresholdSignal(char const * serialNo)" />
	/// <seealso cref="NT_GetTrackingThresholdSignal(char const * serialNo)" />
	NANOTRAK_API short __cdecl NT_SetTrackingThresholdSignal(char const * serialNo, float threshold);

	/// <summary> Requests the home position of the scan circle. </summary>
	/// <param name="serialNo">	The device serial no. </param>
	/// <returns> The error code (see \ref C_DLL_ERRORCODES_page "Error Codes") or zero if successful. </returns>
	/// <seealso cref="NT_GetCircleHomePosition(char const * serialNo)" />
	/// <seealso cref="NT_SetCircleHomePosition(char const * serialNo, NT_HVComponent *position)" />
	NANOTRAK_API short __cdecl NT_RequestCircleHomePosition(char const * serialNo);

	/// <summary> Gets the home position of the scan circle. </summary>
	/// <param name="serialNo">	The device serial no. </param>
	/// <param name="position"> Address of the NT_HVComponent to receive the position as an XY pair,<br />
	/// 				   range 0 to 65535 equivalent to 0 to 10 NT Units. </param>
	/// <returns> The error code (see \ref C_DLL_ERRORCODES_page "Error Codes") or zero if successful. </returns>
	/// <seealso cref="NT_RequesCircleHomePosition(char const * serialNo)" />
	/// <seealso cref="NT_SetCircleHomePosition(char const * serialNo, NT_HVComponent *position)" />
	/// <seealso cref="NT_HomeCircle(char const * serialNo)" />
	NANOTRAK_API short __cdecl NT_GetCircleHomePosition(char const * serialNo, NT_HVComponent *position);

	/// <summary> Sets the home position of the scan circle. </summary>
	/// <param name="serialNo">	The device serial no. </param>
	/// <param name="position"> Address of the NT_HVComponent containing the new position as an XY pair<br />
	/// 				   range 0 to 65535 equivalent to 0 to 10 NT Units. </param>
	/// <returns> The error code (see \ref C_DLL_ERRORCODES_page "Error Codes") or zero if successful. </returns>
	/// <seealso cref="NT_RequesCircleHomePosition(char const * serialNo)" />
	/// <seealso cref="NT_GetCircleHomePosition(char const * serialNo, NT_HVComponent *position)" />
	/// <seealso cref="NT_HomeCircle(char const * serialNo)" />
	NANOTRAK_API short __cdecl NT_SetCircleHomePosition(char const * serialNo, NT_HVComponent *position);

	/// <summary> Move the scan circle to the home position. </summary>
	/// <param name="serialNo">	The device serial no. </param>
	/// <returns> The error code (see \ref C_DLL_ERRORCODES_page "Error Codes") or zero if successful. </returns>
	/// <seealso cref="NT_SetCircleHomePosition(char const * serialNo, NT_HVComponent *position)" />
	/// <seealso cref="NT_GetCircleHomePosition(char const * serialNo, NT_HVComponent *position)" />
	NANOTRAK_API short __cdecl NT_HomeCircle(char const * serialNo);

	/// <summary>Requests the current scan circle centre position. </summary>
	/// <remarks> This command will request an update from the device.<br />
	/// 		  NOTE this is nor required if the device is being continously polled using <see cref="NT_StartPolling(char const * serialNo, int milliseconds)" />.</remarks>
	/// <param name="serialNo">	The device serial no. </param>
	/// <returns> The error code (see \ref C_DLL_ERRORCODES_page "Error Codes") or zero if successfully requested. </returns>
	/// <seealso cref="NT_GetCirclePosition(char const * serialNo, NT_HVComponent *position)" />
	/// <seealso cref="NT_StartPolling(char const * serialNo, int milliseconds)" />
	NANOTRAK_API short __cdecl NT_RequestCirclePosition(char const * serialNo);

	/// <summary> Gets the current scan circle centre position. </summary>
	/// <remarks> This command will return the latest value received from the device.<br />
	///			  To get an updated value use <see cref="NT_RequestCirclePosition(char const * serialNo)" /> or <see cref="NT_StartPolling(char const * serialNo, int milliseconds)" /></remarks>
	/// <param name="serialNo"> The device serial no. </param>
	/// <param name="position"> Address of the NT_HVComponent to receive the position as an XY pair,<br />
	/// 				   range 0 to 65535 equivalent to 0 to 10 NT Units. </param>
	/// <returns> The error code (see \ref C_DLL_ERRORCODES_page "Error Codes") or zero if successful. </returns>
	/// <seealso cref="NT_RequestCirclePosition(char const * serialNo)" />
	/// <seealso cref="NT_StartPolling(char const * serialNo, int milliseconds)" />
	NANOTRAK_API short __cdecl NT_GetCirclePosition(char const * serialNo, NT_HVComponent *position);

	/// <summary> Requests the scanning circle parameters. </summary>
	/// <param name="serialNo">	The device serial no. </param>
	/// <returns> The error code (see \ref C_DLL_ERRORCODES_page "Error Codes") or zero if successful. </returns>
	/// <seealso cref="NT_GetCircleParams(char const * serialNo)" />
	/// <seealso cref="NT_SetCircleParams(char const * serialNo, NT_CircleParameters *params" />
	NANOTRAK_API short __cdecl NT_RequestCircleParams(char const * serialNo);

	/// <summary> Gets the scanning circle parameters. </summary>
	/// <param name="serialNo">	The device serial no. </param>
	/// <param name="params"> Address of the NT_CircleParameters to receive the parameters defining the scan circle. </param>
	/// <returns> The error code (see \ref C_DLL_ERRORCODES_page "Error Codes") or zero if successful. </returns>
	/// <seealso cref="NT_RequesCircleParams(char const * serialNo)" />
	/// <seealso cref="NT_SetCircleParams(char const * serialNo, NT_CircleParameters *params)" />
	/// <seealso cref="NT_GetCircleDiameter(char const * serialNo)" />
	/// <seealso cref="NT_SetCircleDiameter(char const * serialNo, WORD diameter)" />
	/// <seealso cref="NT_GetCircleDiameterLUT(char const * serialNo, NT_CircleDiameterLUT *LUT)" />
	/// <seealso cref="NT_SetCircleDiameterLUT(char const * serialNo, NT_CircleDiameterLUT *LUT)" />
	NANOTRAK_API short __cdecl NT_GetCircleParams(char const * serialNo, NT_CircleParameters *params);

	/// <summary> Sets the scanning circle parameters. </summary>
	/// <param name="serialNo">	The device serial no. </param>
	/// <param name="params"> Address of the NT_CircleParameters containing the new parameters defining the scan circle. </param>
	/// <returns> The error code (see \ref C_DLL_ERRORCODES_page "Error Codes") or zero if successful. </returns>
	/// <seealso cref="NT_RequesCircleParams(char const * serialNo)" />
	/// <seealso cref="NT_GetCircleParams(char const * serialNo, NT_CircleParameters *params)" />
	/// <seealso cref="NT_GetCircleDiameter(char const * serialNo)" />
	/// <seealso cref="NT_SetCircleDiameter(char const * serialNo, WORD diameter)" />
	/// <seealso cref="NT_GetCircleDiameterLUT(char const * serialNo, NT_CircleDiameterLUT *LUT)" />
	/// <seealso cref="NT_SetCircleDiameterLUT(char const * serialNo, NT_CircleDiameterLUT *LUT)" />
	NANOTRAK_API short __cdecl NT_SetCircleParams(char const * serialNo, NT_CircleParameters *params);

	/// <summary> Gets the scan circle diameter. </summary>
	/// <param name="serialNo">	The device serial no. </param>
	/// <returns> The scanning circle diameter, range 0 to 65535 (0 to 10 NT Units). </returns>
	/// <seealso cref="NT_SetCircleDiameter(char const * serialNo, WORD diameter)" />
	/// <seealso cref="NT_SetCircleParams(char const * serialNo, NT_CircleParameters *params)" />
	/// <seealso cref="NT_GetCircleParams(char const * serialNo, NT_CircleParameters *params)" />
	/// <seealso cref="NT_GetCircleDiameterLUT(char const * serialNo, NT_CircleDiameterLUT *LUT)" />
	/// <seealso cref="NT_SetCircleDiameterLUT(char const * serialNo, NT_CircleDiameterLUT *LUT)" />
	NANOTRAK_API WORD __cdecl NT_GetCircleDiameter(char const * serialNo);

	/// <summary> Sets the scan circle diameter. </summary>
	/// <param name="serialNo">	The device serial no. </param>
	/// <param name="diameter"> The scanning circle diameter, range 0 to 65535 (0 to 10 NT Units). </param>
	/// <returns> The error code (see \ref C_DLL_ERRORCODES_page "Error Codes") or zero if successful. </returns>
	/// <seealso cref="NT_GetCircleDiameter(char const * serialNo)" />
	/// <seealso cref="NT_SetCircleParams(char const * serialNo, NT_CircleParameters *params)" />
	/// <seealso cref="NT_GetCircleParams(char const * serialNo, NT_CircleParameters *params)" />
	/// <seealso cref="NT_GetCircleDiameterLUT(char const * serialNo, NT_CircleDiameterLUT *LUT)" />
	/// <seealso cref="NT_SetCircleDiameterLUT(char const * serialNo, NT_CircleDiameterLUT *LUT)" />
	NANOTRAK_API short __cdecl NT_SetCircleDiameter(char const * serialNo, WORD diameter);

	/// <summary> Requests the scan circle diameter Lookup Table (LUT). </summary>
	/// <param name="serialNo">	The device serial no. </param>
	/// <returns> The error code (see \ref C_DLL_ERRORCODES_page "Error Codes") or zero if successful. </returns>
	/// <seealso cref="NT_SetCircleDiameterLUT(char const * serialNo, NT_CircleDiameterLUT *LUT)" />
	/// <seealso cref="NT_GetCircleDiameterLUT(char const * serialNo, NT_CircleDiameterLUT *LUT)" />
	/// <seealso cref="NT_SetCircleParams(char const * serialNo, NT_CircleParameters *params)" />
	/// <seealso cref="NT_GetCircleParams(char const * serialNo, NT_CircleParameters *params)" />
	/// <seealso cref="NT_GetCircleDiameter(char const * serialNo)" />
	/// <seealso cref="NT_SetCircleDiameter(char const * serialNo, WORD diameter)" />
	NANOTRAK_API short __cdecl NT_RequestCircleDiameterLUT(char const * serialNo);

	/// <summary> Gets the scan circle diameter Lookup Table (LUT). </summary>
	/// <param name="serialNo">	The device serial no. </param>
	/// <param name="LUT"> Address of the NT_CircleDiameterLUT to receive the  scan circle diameter lookup table. </param>
	/// <returns> The error code (see \ref C_DLL_ERRORCODES_page "Error Codes") or zero if successful. </returns>
	/// <seealso cref="NT_SetCircleDiameterLUT(char const * serialNo, NT_CircleDiameterLUT *LUT)" />
	/// <seealso cref="NT_RequestCircleDiameterLUT(char const * serialNo)" />
	/// <seealso cref="NT_SetCircleParams(char const * serialNo, NT_CircleParameters *params)" />
	/// <seealso cref="NT_GetCircleParams(char const * serialNo, NT_CircleParameters *params)" />
	/// <seealso cref="NT_GetCircleDiameter(char const * serialNo)" />
	/// <seealso cref="NT_SetCircleDiameter(char const * serialNo, WORD diameter)" />
	NANOTRAK_API short __cdecl NT_GetCircleDiameterLUT(char const * serialNo, NT_CircleDiameterLUT *LUT);

	/// <summary> Sets the scan circle diameter Lookup Table (LUT). </summary>
	/// <param name="serialNo">	The device serial no. </param>
	/// <param name="LUT"> Address of the NT_CircleParameters containing the new scan circle diameter lookup table. </param>
	/// <returns> The error code (see \ref C_DLL_ERRORCODES_page "Error Codes") or zero if successful. </returns>
	/// <seealso cref="NT_GetCircleDiameterLUT(char const * serialNo, NT_CircleDiameterLUT *LUT)" />
	/// <seealso cref="NT_RequestCircleDiameterLUT(char const * serialNo)" />
	/// <seealso cref="NT_SetCircleParams(char const * serialNo, NT_CircleParameters *params)" />
	/// <seealso cref="NT_GetCircleParams(char const * serialNo, NT_CircleParameters *params)" />
	/// <seealso cref="NT_GetCircleDiameter(char const * serialNo)" />
	/// <seealso cref="NT_SetCircleDiameter(char const * serialNo, WORD diameter)" />
	NANOTRAK_API short __cdecl NT_SetCircleDiameterLUT(char const * serialNo, NT_CircleDiameterLUT *LUT);
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
